EthanSK/magic-wand/control-stones/design/v2/exports/handheld-overview.png

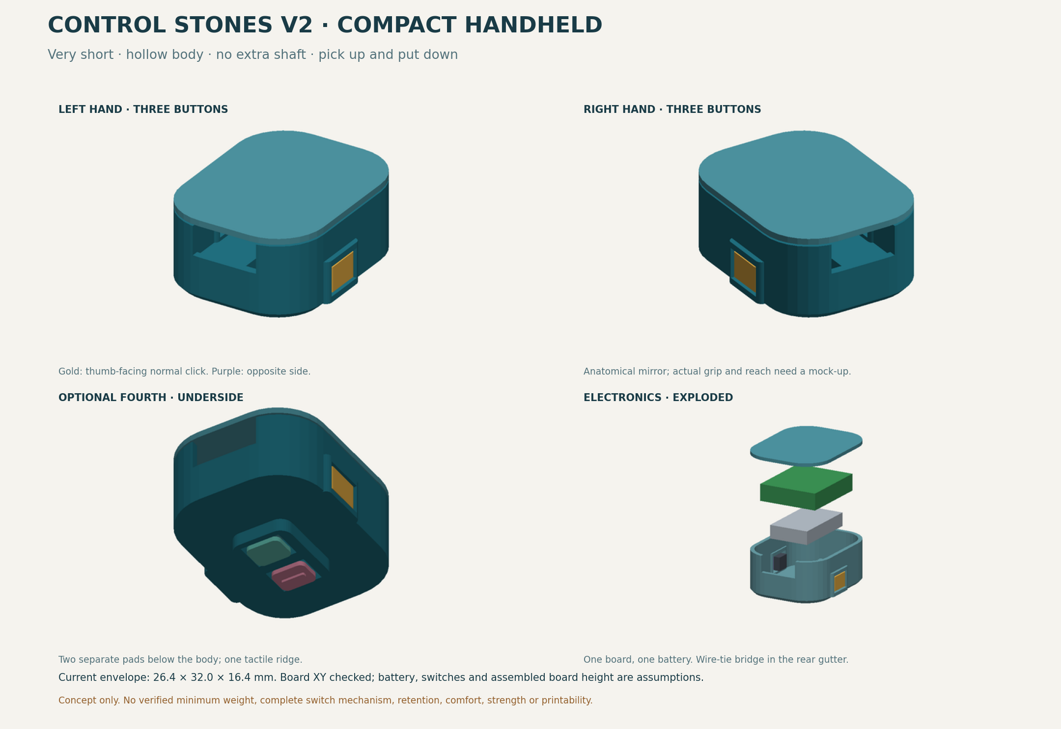
control-stones/design/v2/exports/handheld-overview.png
