EthanSK/magic-wand/control-stones/design/v2/exports/handheld-v-ring.png

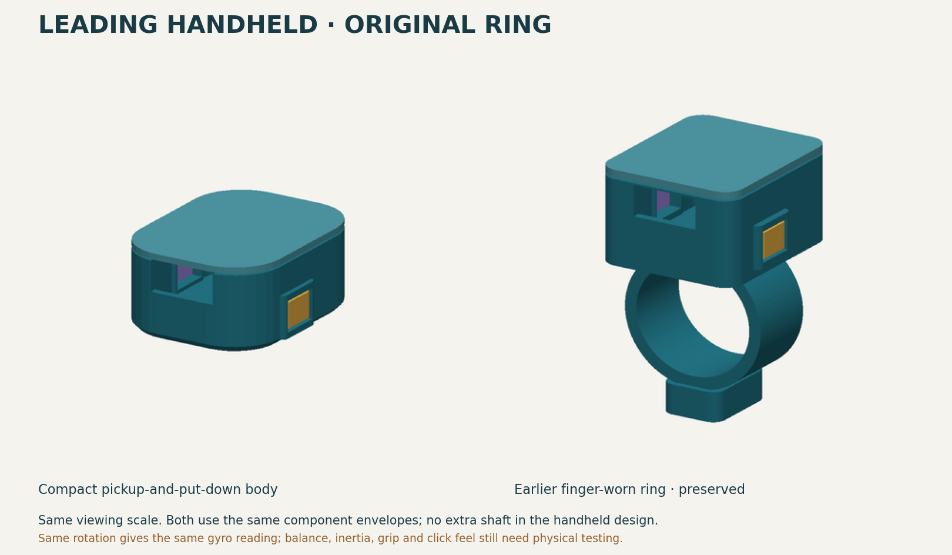
control-stones/design/v2/exports/handheld-v-ring.png
