EthanSK/magic-wand/control-stones/design/v2/exports/overview.png

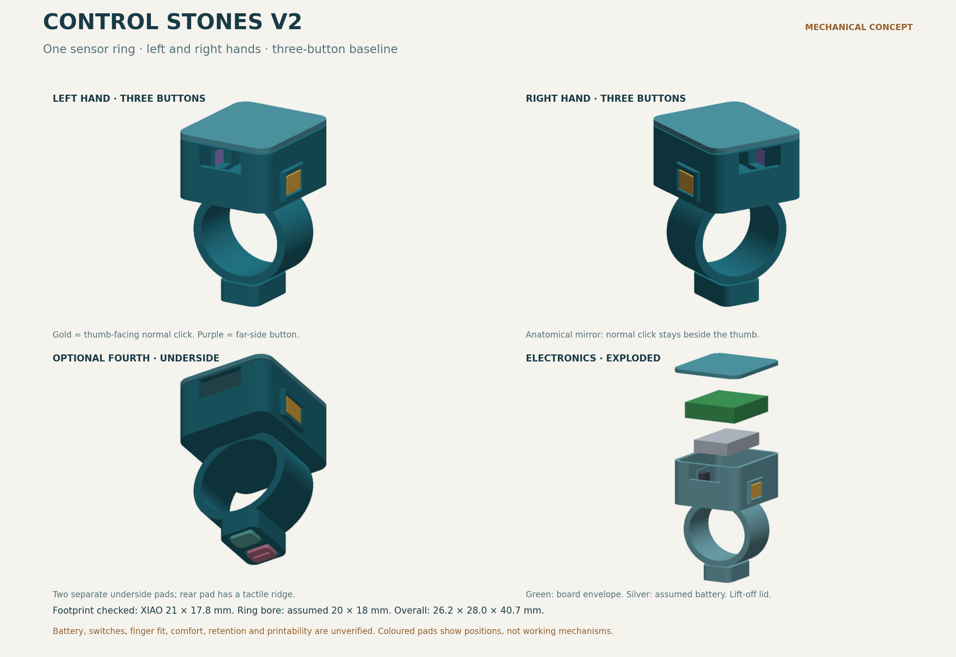
control-stones/design/v2/exports/overview.png
