EthanSK/magic-wand/control-stones/design/v2/exports/underside-comparison.png

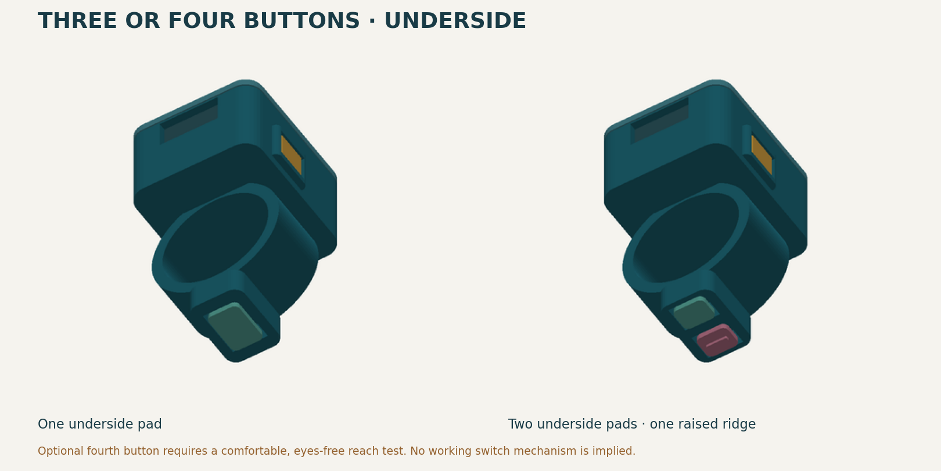
control-stones/design/v2/exports/underside-comparison.png
