EthanSK/magic-wand/magic-wand/hardware/carbon-rod-holders-r5/exports/Battery-options.png

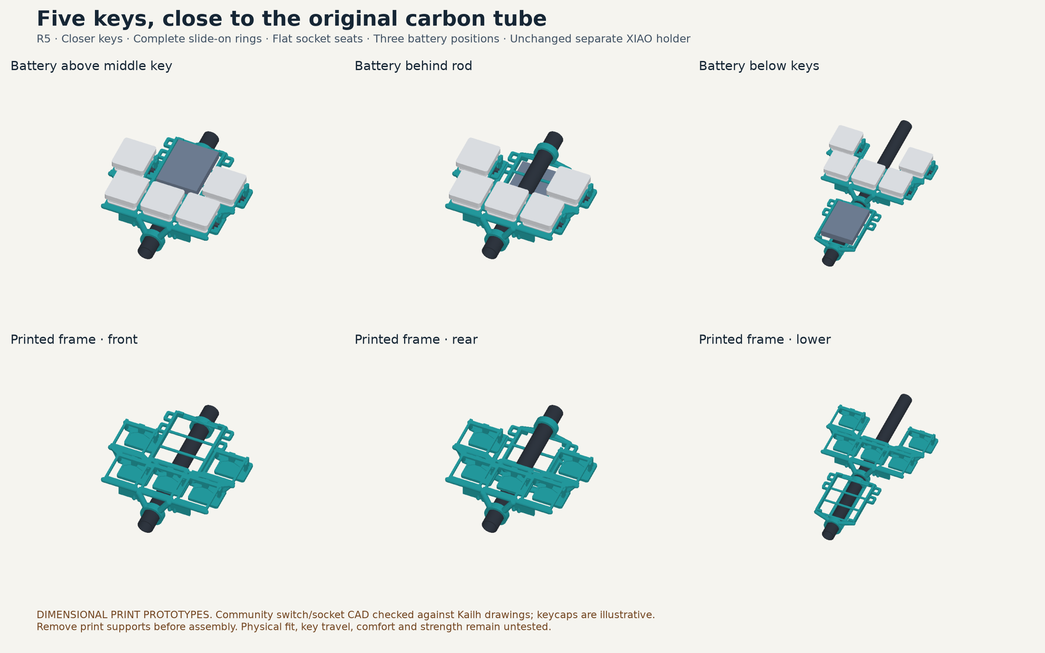
magic-wand/hardware/carbon-rod-holders-r5/exports/Battery-options.png
