EthanSK/magic-wand/magic-wand/hardware/carbon-rod-holders-r14-pyramid/exports/Key_Carrier-overhang-views.png

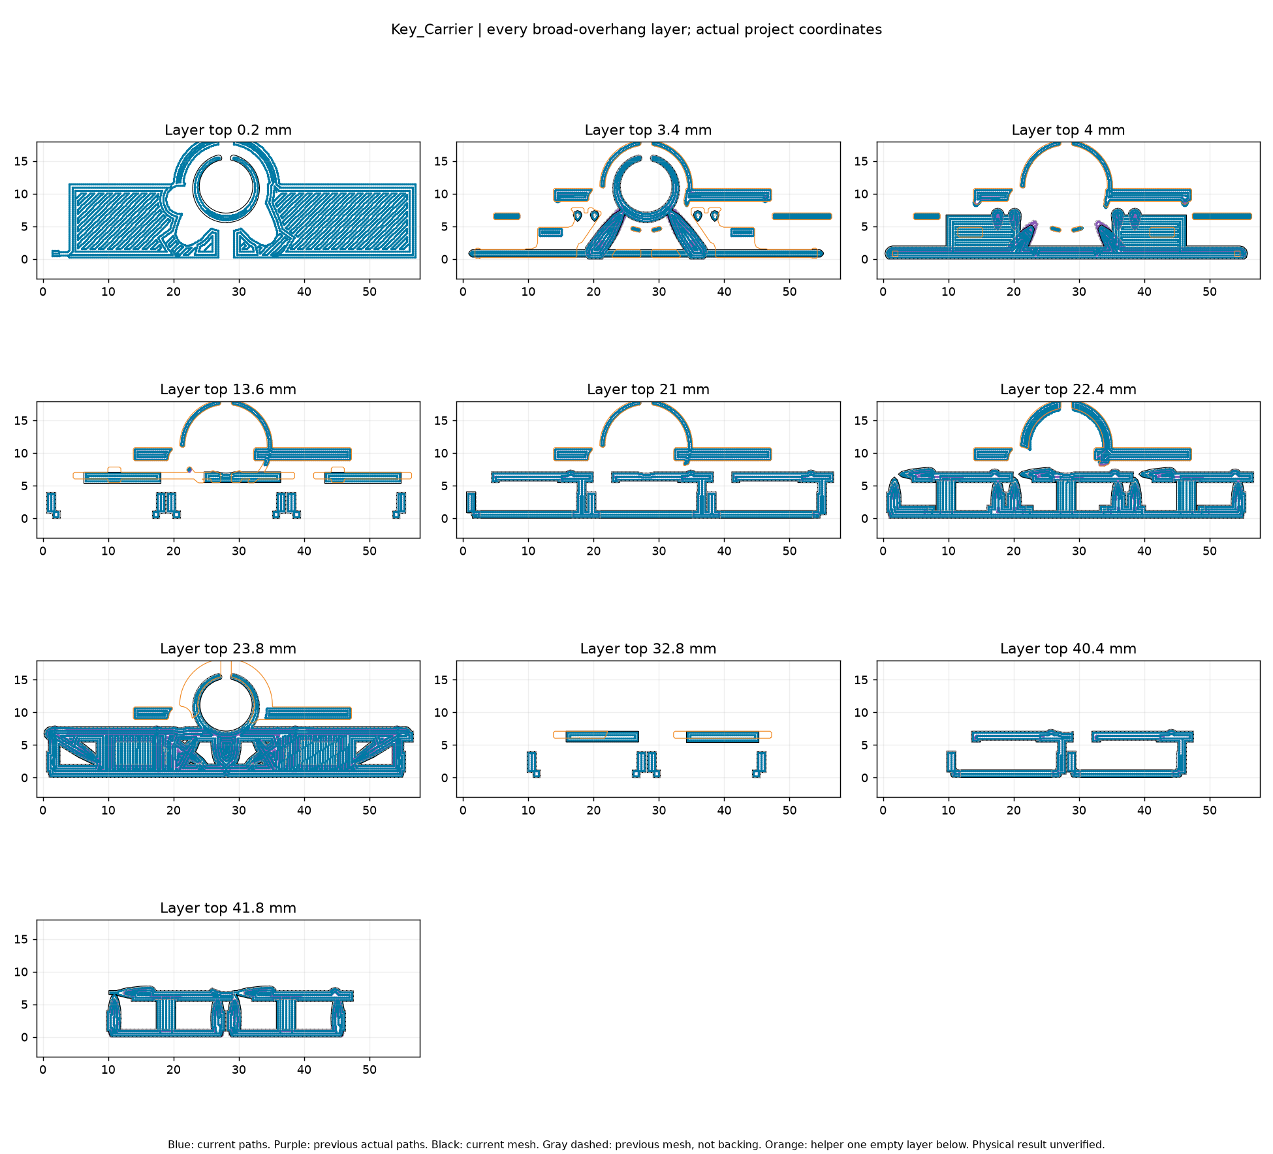
magic-wand/hardware/carbon-rod-holders-r14-pyramid/exports/Key_Carrier-overhang-views.png
