EthanSK/magic-wand/magic-wand/hardware/carbon-rod-holders-r14-pyramid/exports/Key_Carrier-overview.png

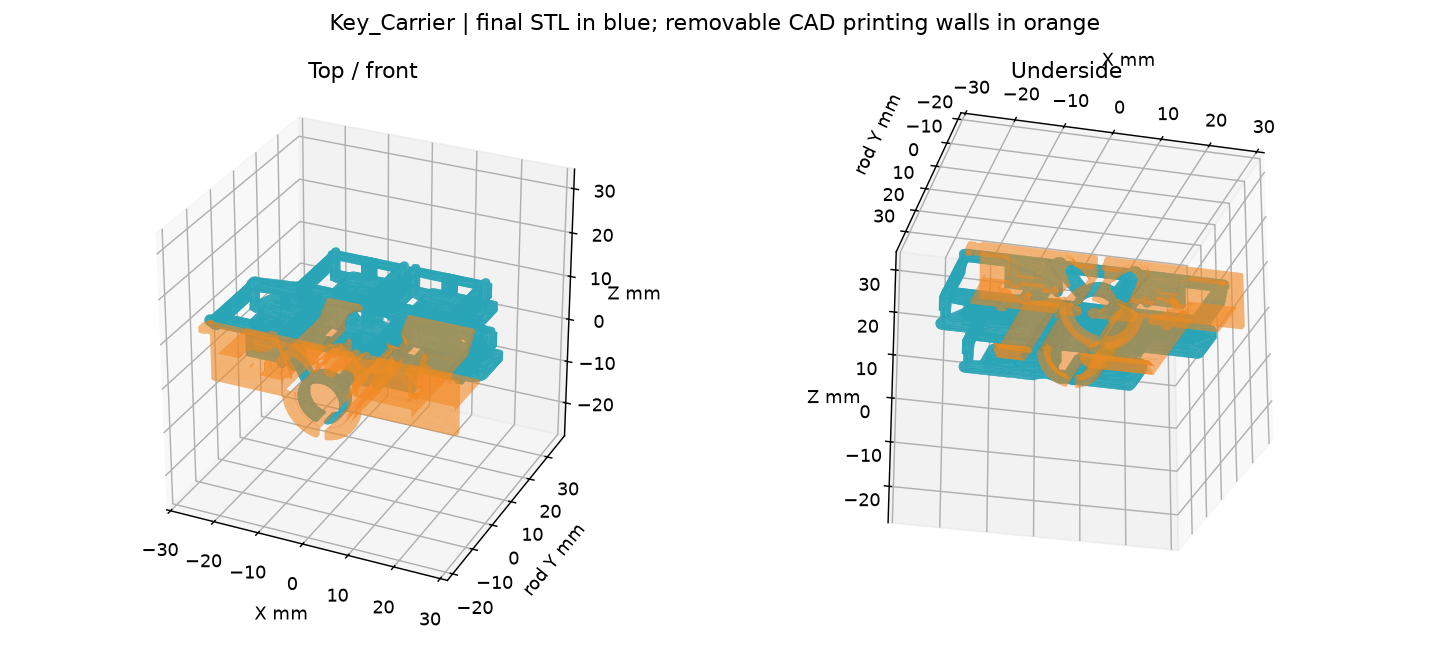
magic-wand/hardware/carbon-rod-holders-r14-pyramid/exports/Key_Carrier-overview.png
