EthanSK/magic-wand/magic-wand/hardware/carbon-rod-holders-r14-pyramid/exports/Key_Carrier-slice-views.png

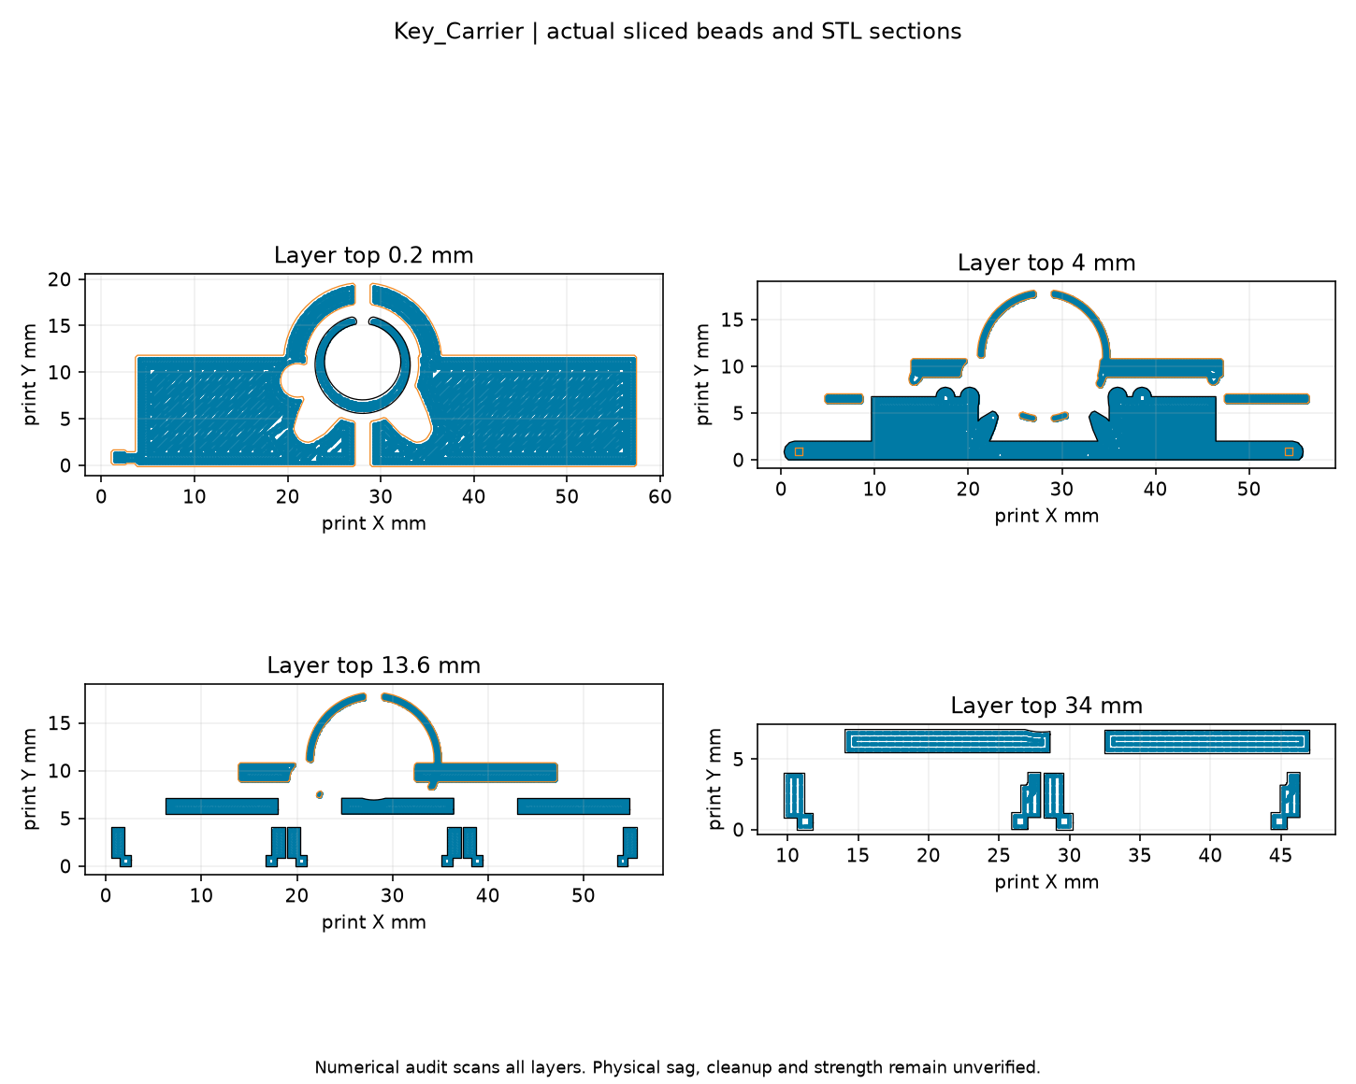
magic-wand/hardware/carbon-rod-holders-r14-pyramid/exports/Key_Carrier-slice-views.png
