EthanSK/magic-wand/magic-wand/hardware/carbon-rod-holders-r14-pyramid/exports/layout-comparison.png

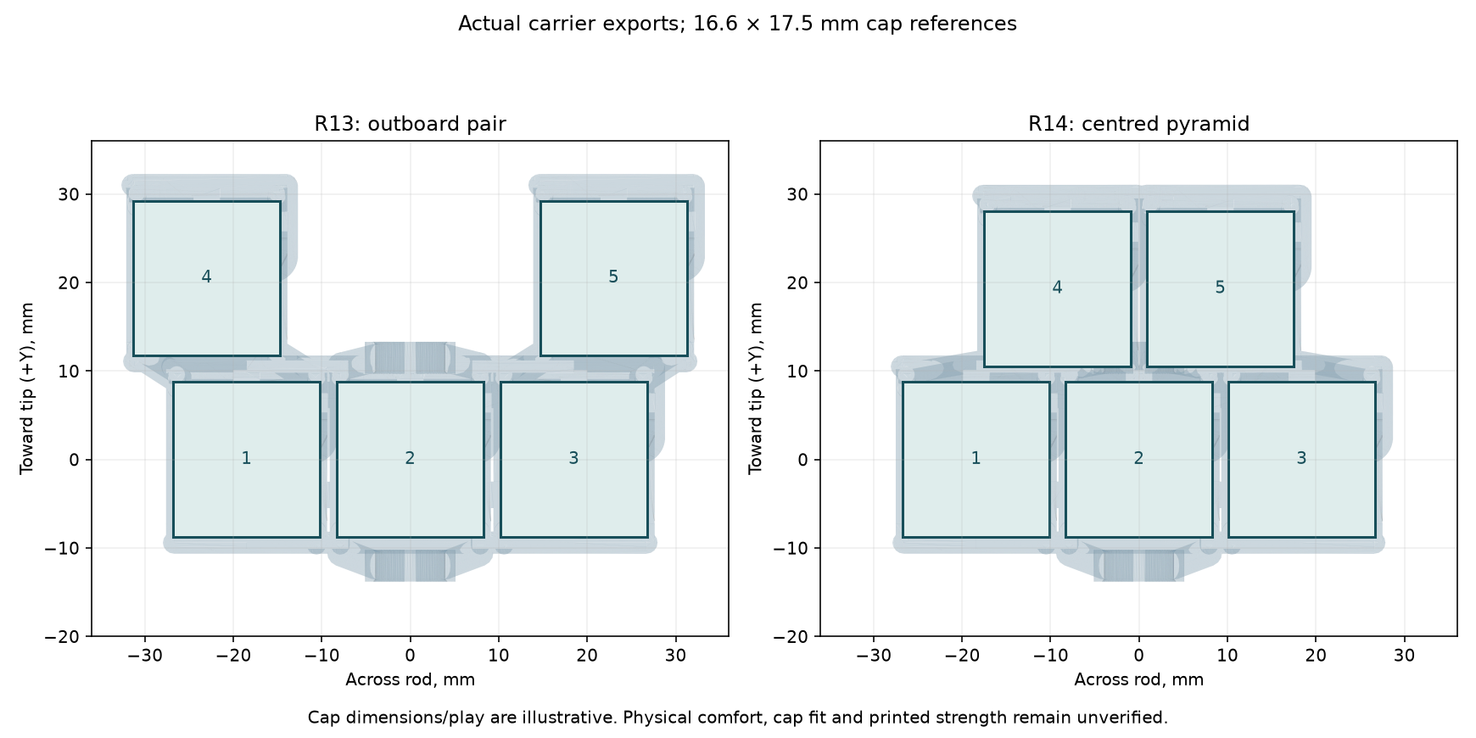
magic-wand/hardware/carbon-rod-holders-r14-pyramid/exports/layout-comparison.png
