EthanSK/magic-wand/magic-wand/hardware/carbon-rod-holders-r15-tight-pyramid/exports/Battery_End_Gate-overview.png

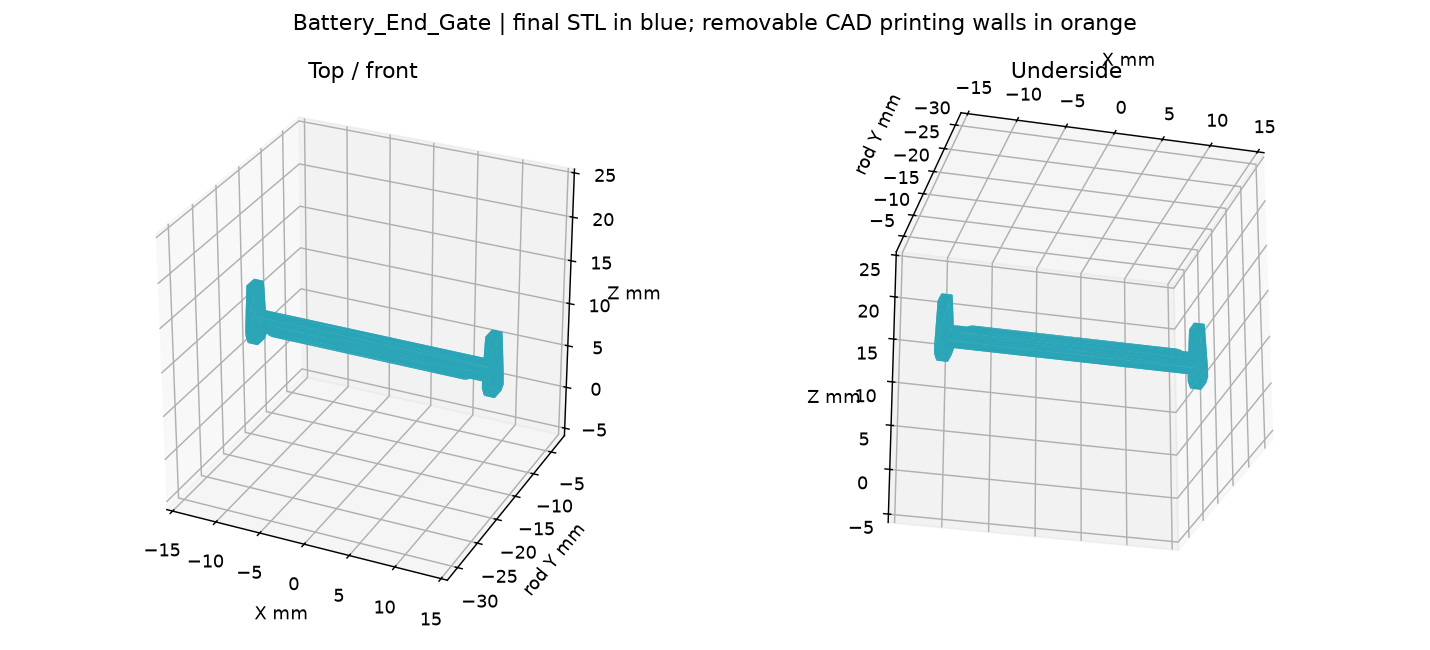
magic-wand/hardware/carbon-rod-holders-r15-tight-pyramid/exports/Battery_End_Gate-overview.png
