EthanSK/magic-wand/magic-wand/hardware/carbon-rod-holders-r15-tight-pyramid/exports/Battery_Holder-slice-views.png

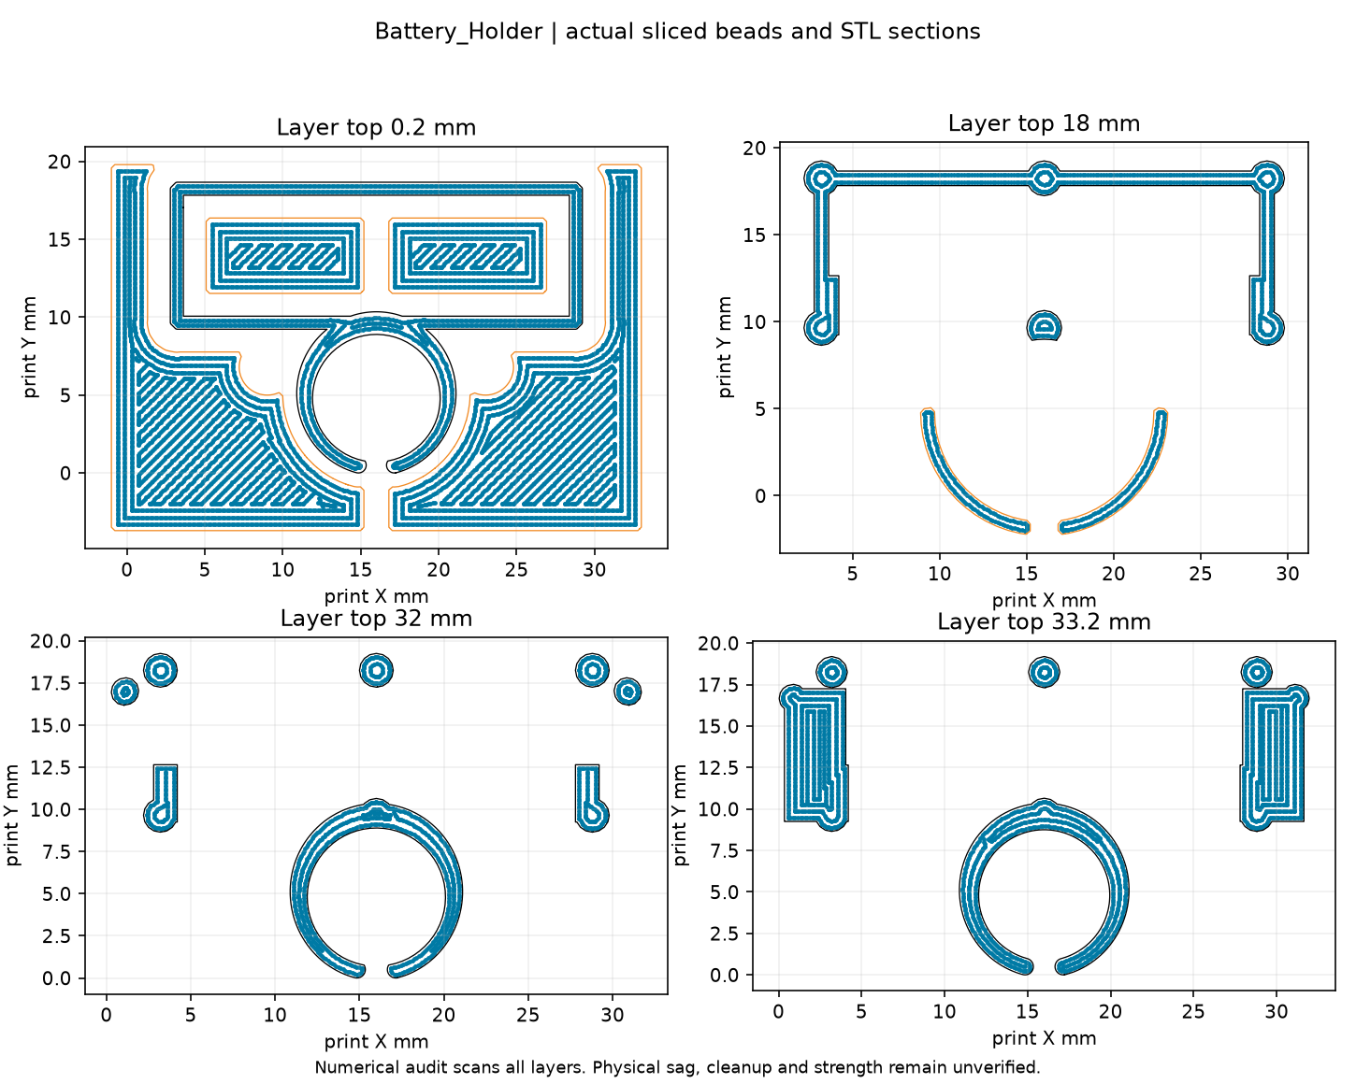
magic-wand/hardware/carbon-rod-holders-r15-tight-pyramid/exports/Battery_Holder-slice-views.png
