EthanSK/magic-wand/magic-wand/hardware/carbon-rod-holders-r15-tight-pyramid/exports/Key_Carrier-overhang-views.png

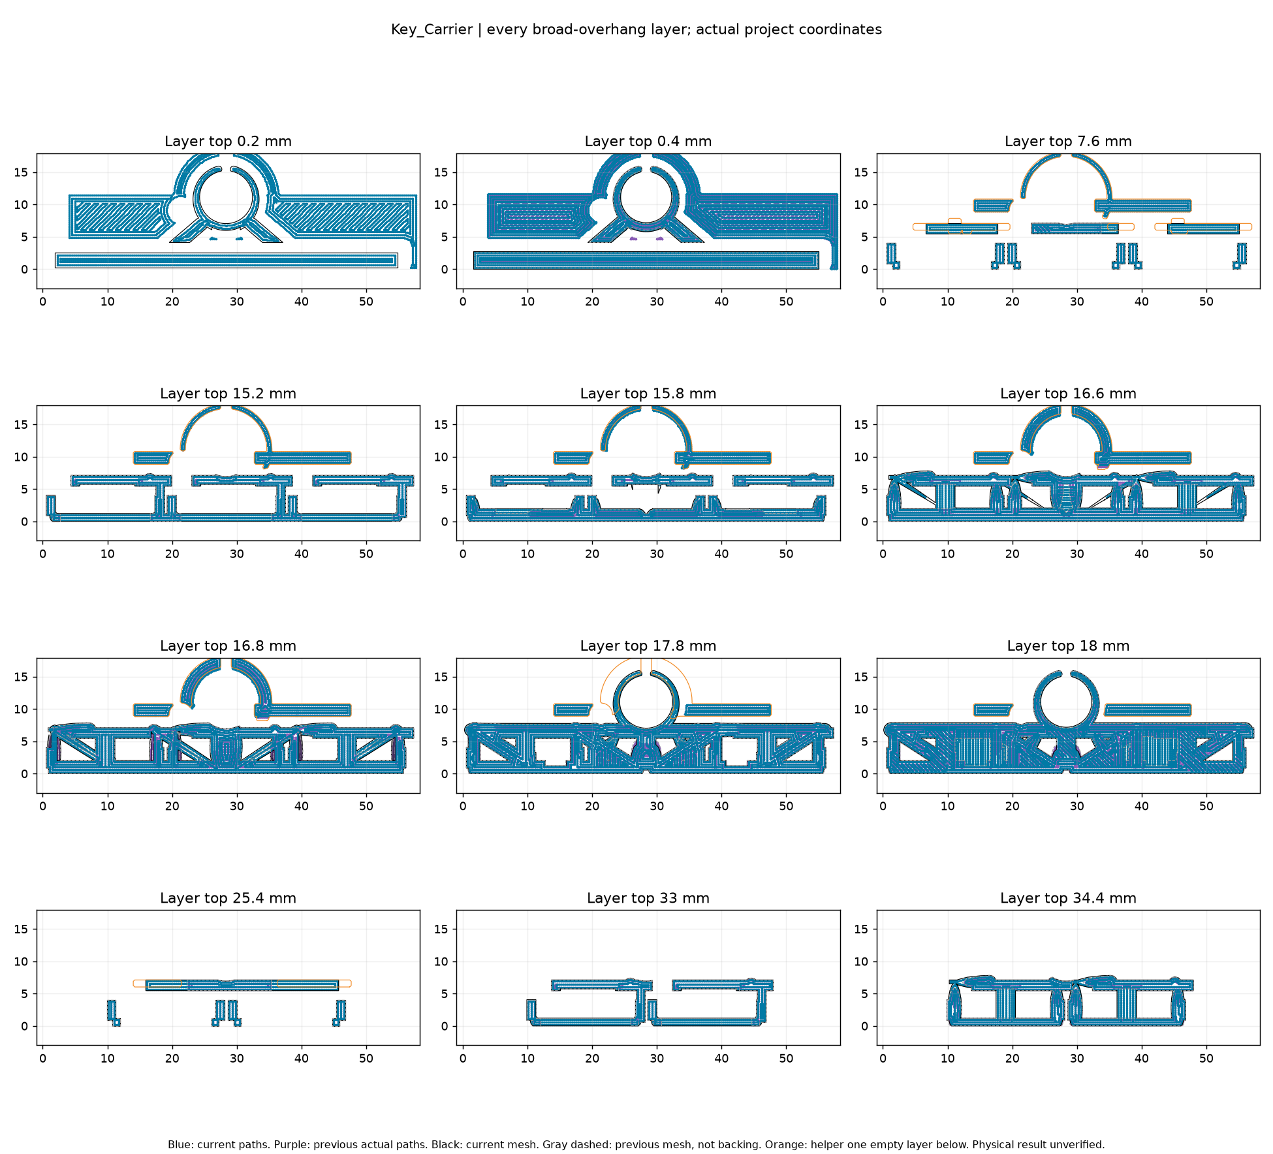
magic-wand/hardware/carbon-rod-holders-r15-tight-pyramid/exports/Key_Carrier-overhang-views.png
