EthanSK/magic-wand/magic-wand/hardware/carbon-rod-holders-r15-tight-pyramid/exports/layout-comparison.png

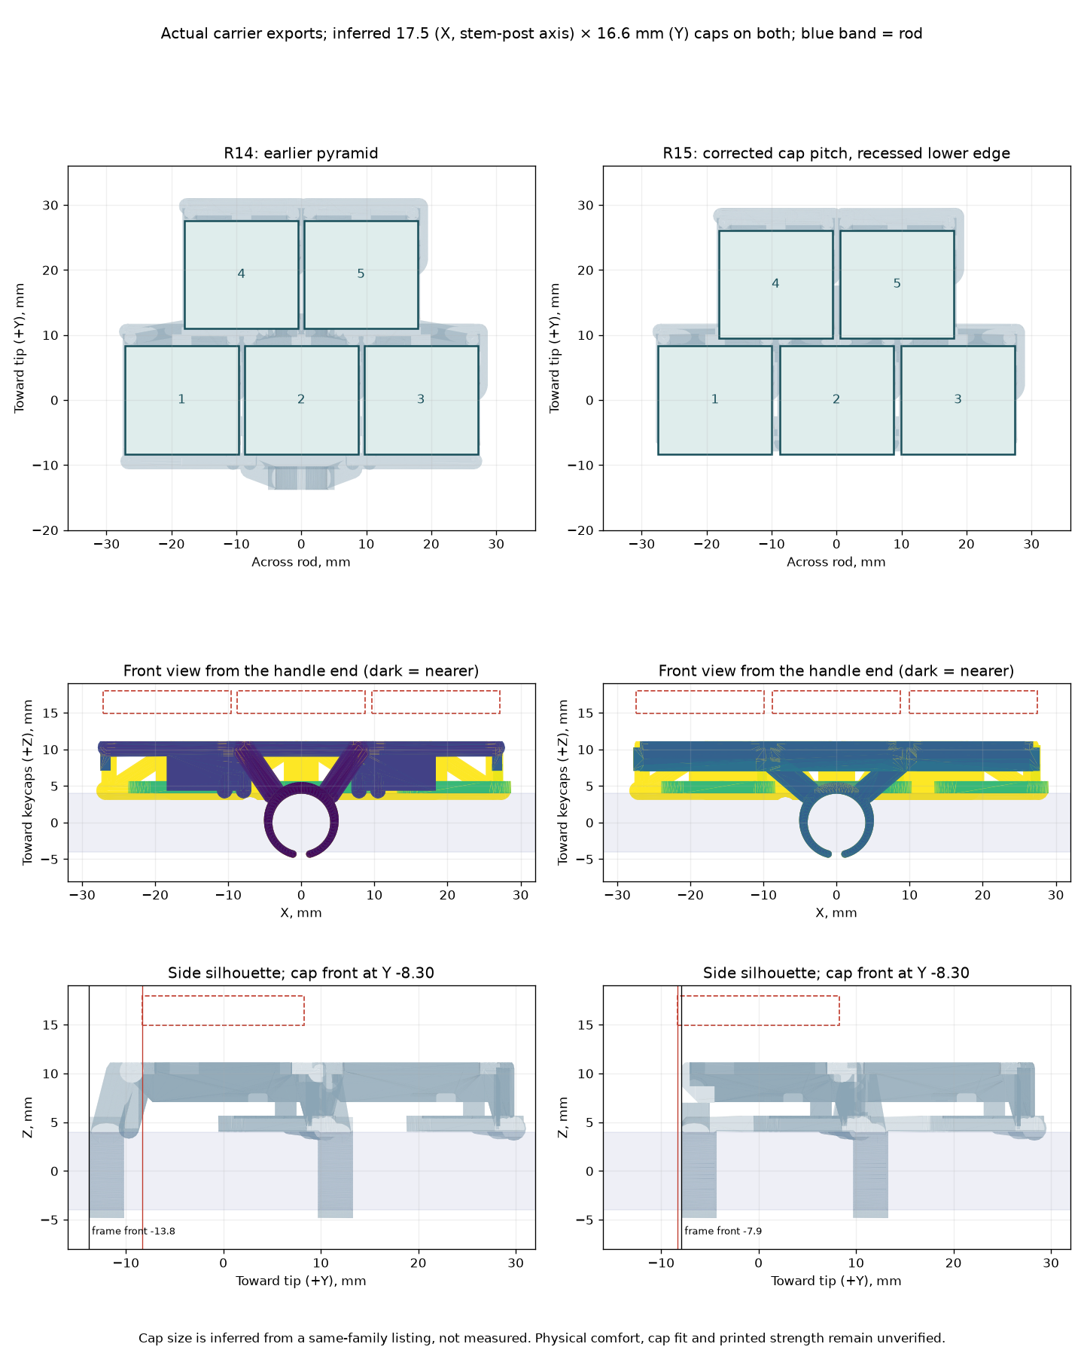
magic-wand/hardware/carbon-rod-holders-r15-tight-pyramid/exports/layout-comparison.png
