EthanSK/magic-wand/magic-wand/hardware/carbon-rod-holders-r15-tight-pyramid/exports/XIAO_Rod_Holder-slice-views.png

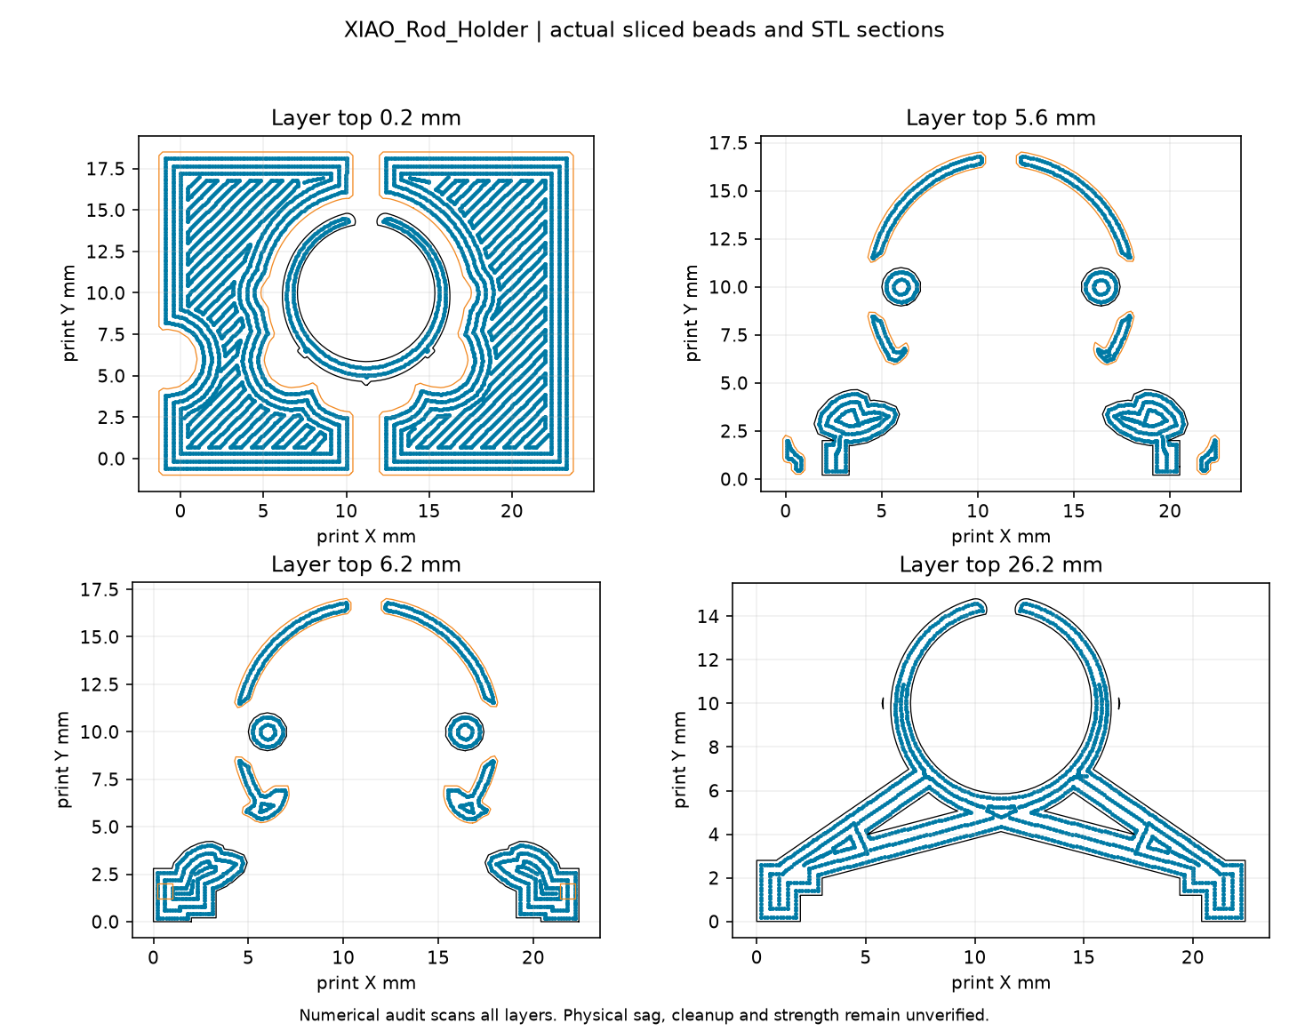
magic-wand/hardware/carbon-rod-holders-r15-tight-pyramid/exports/XIAO_Rod_Holder-slice-views.png
