EthanSK/magic-wand/magic-wand/hardware/carbon-rod-holders-r16-repair/exports/Battery_End_Gate-overview.png

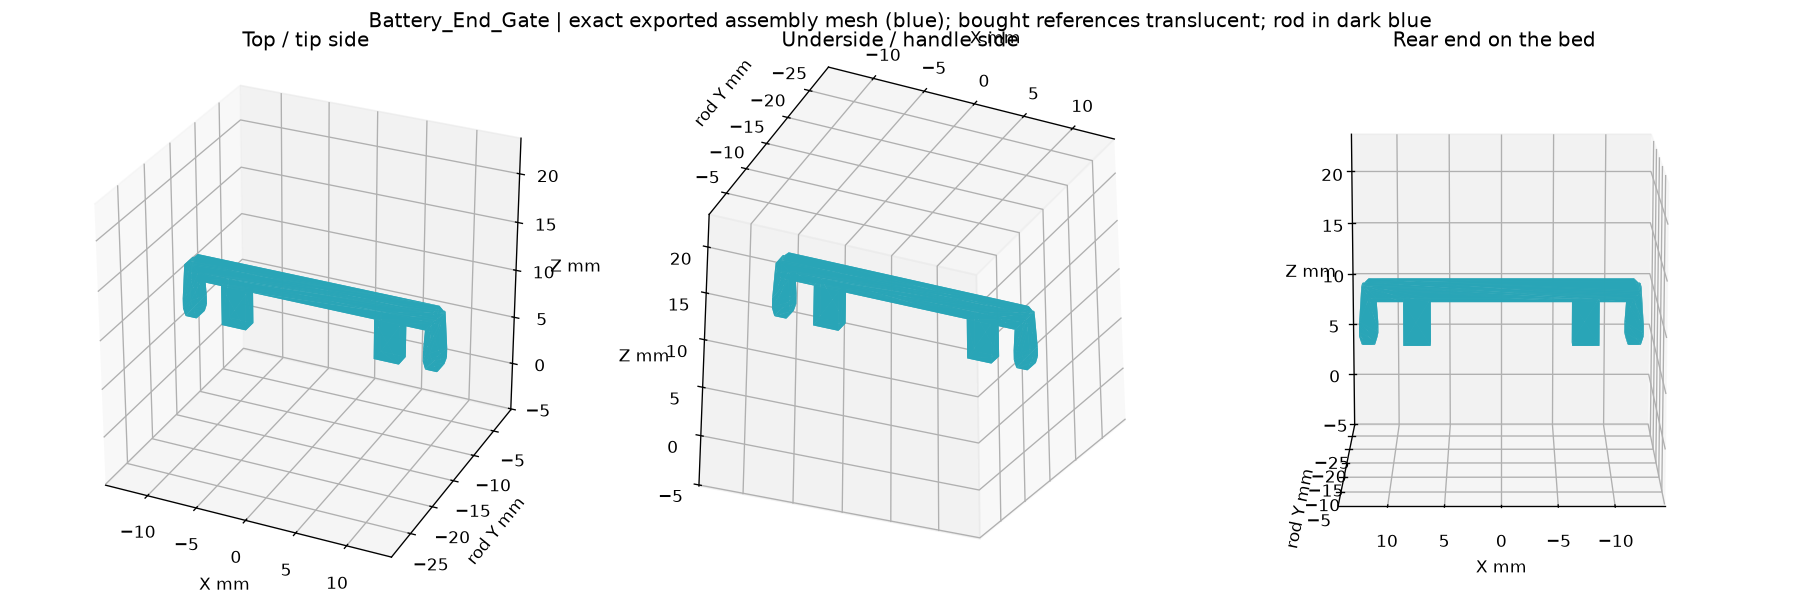
magic-wand/hardware/carbon-rod-holders-r16-repair/exports/Battery_End_Gate-overview.png
