EthanSK/magic-wand/magic-wand/hardware/carbon-rod-holders-r16-repair/exports/Battery_Holder-overview.png

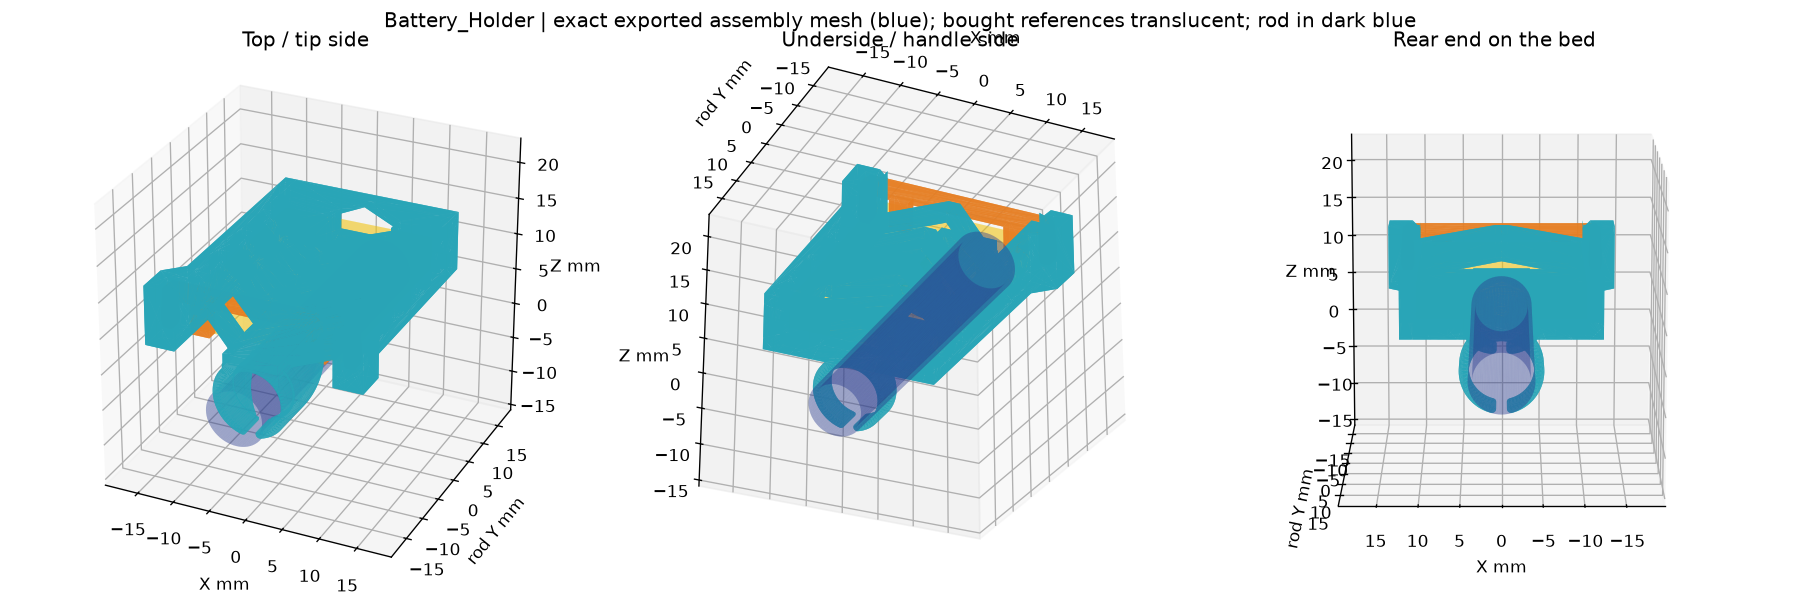
magic-wand/hardware/carbon-rod-holders-r16-repair/exports/Battery_Holder-overview.png
