EthanSK/magic-wand/magic-wand/hardware/carbon-rod-holders-r17-anchored-repair/exports/Battery_End_Gate-overview.png

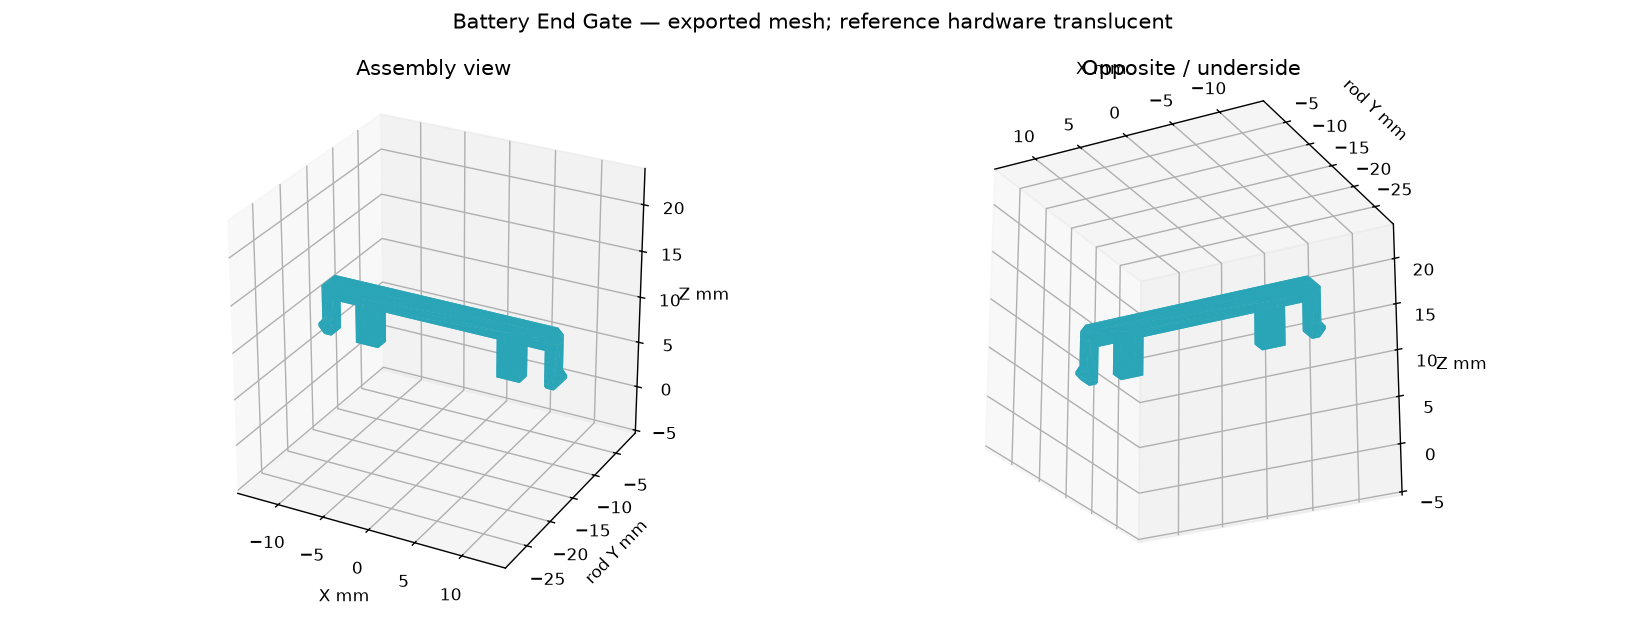
magic-wand/hardware/carbon-rod-holders-r17-anchored-repair/exports/Battery_End_Gate-overview.png
