EthanSK/magic-wand/magic-wand/hardware/carbon-rod-holders-r18-easy-release/exports/Battery_Holder-gui-final-layer-views.png

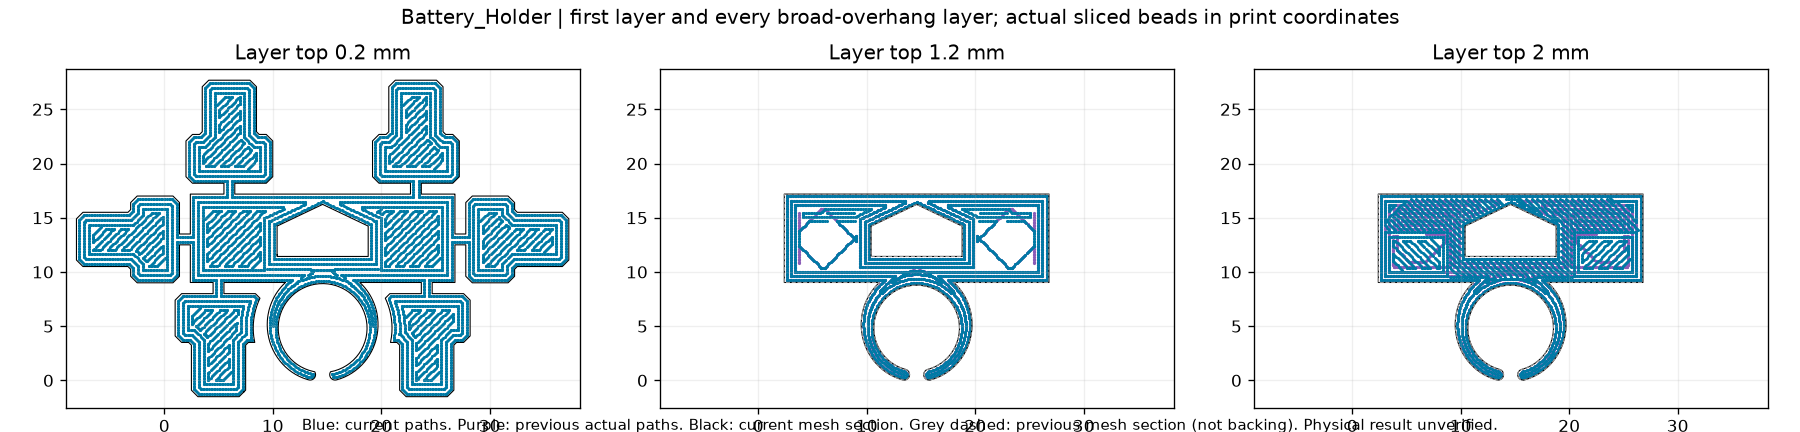
magic-wand/hardware/carbon-rod-holders-r18-easy-release/exports/Battery_Holder-gui-final-layer-views.png
