EthanSK/magic-wand/magic-wand/hardware/carbon-rod-holders-r18-easy-release/exports/XIAO_Rod_Holder-gui-final-layer-views.png

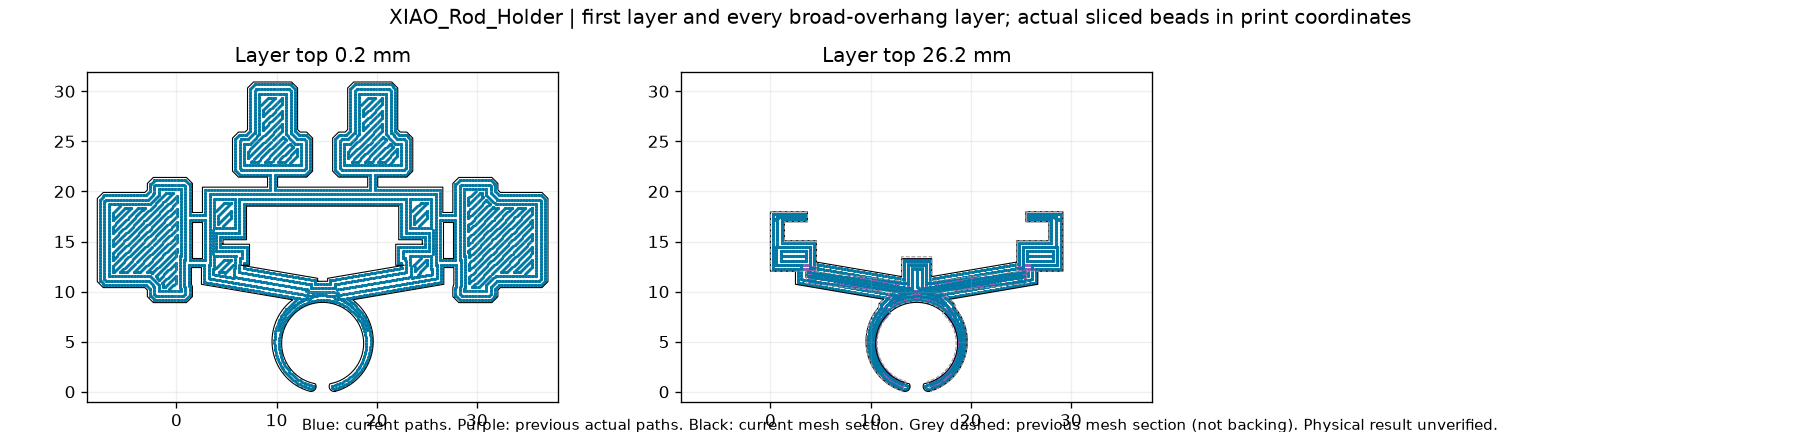
magic-wand/hardware/carbon-rod-holders-r18-easy-release/exports/XIAO_Rod_Holder-gui-final-layer-views.png
