EthanSK/magic-wand/magic-wand/hardware/carbon-rod-holders-r19-lightweight/exports/Battery_Holder-layer-views.png

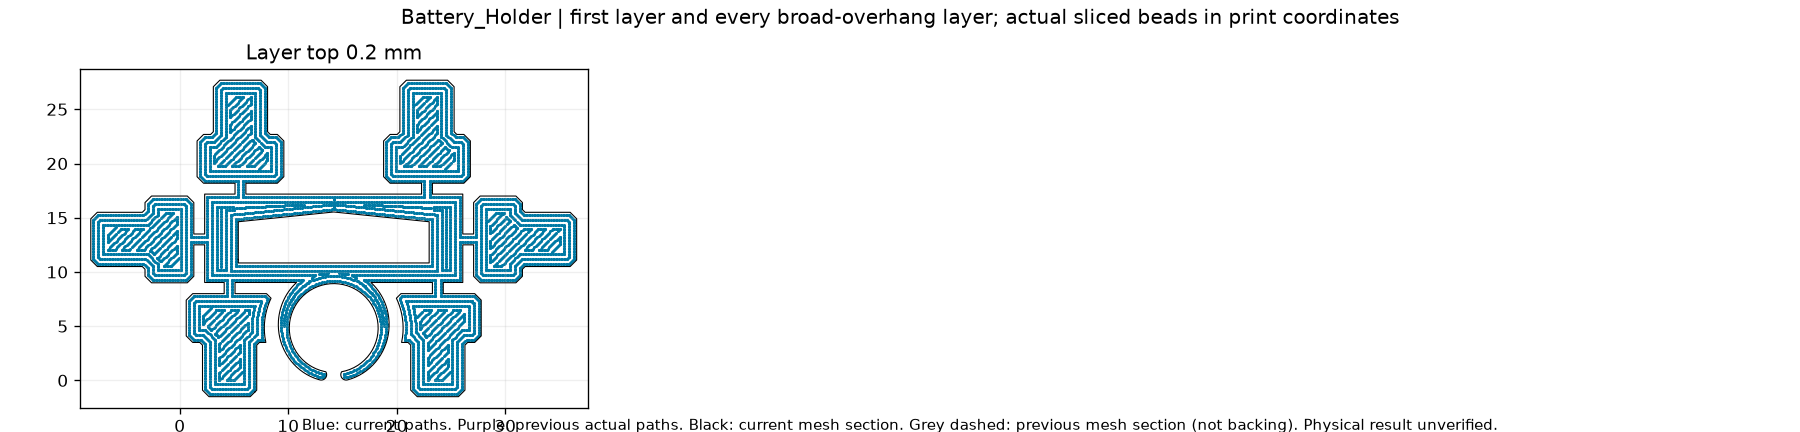
magic-wand/hardware/carbon-rod-holders-r19-lightweight/exports/Battery_Holder-layer-views.png
