EthanSK/magic-wand/magic-wand/hardware/carbon-rod-holders-r19-lightweight/exports/Battery_Spacer_0p4mm-layer-views.png

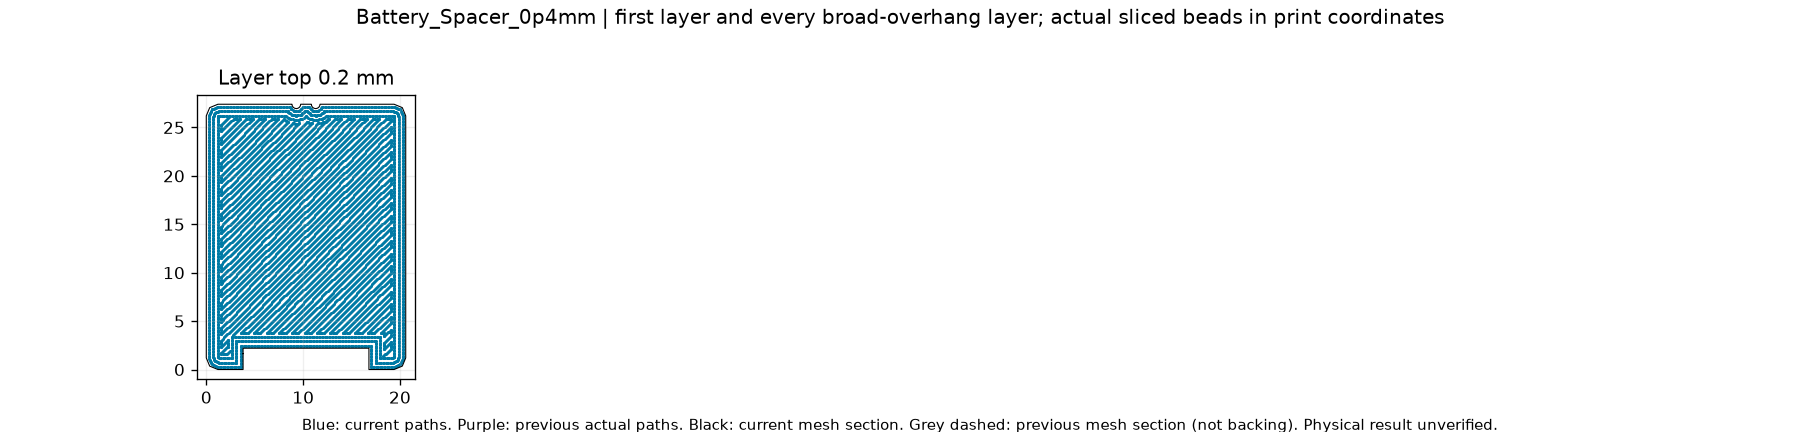
magic-wand/hardware/carbon-rod-holders-r19-lightweight/exports/Battery_Spacer_0p4mm-layer-views.png
