EthanSK/magic-wand/magic-wand/hardware/carbon-rod-holders-r19-lightweight/exports/open-floor-plan.png

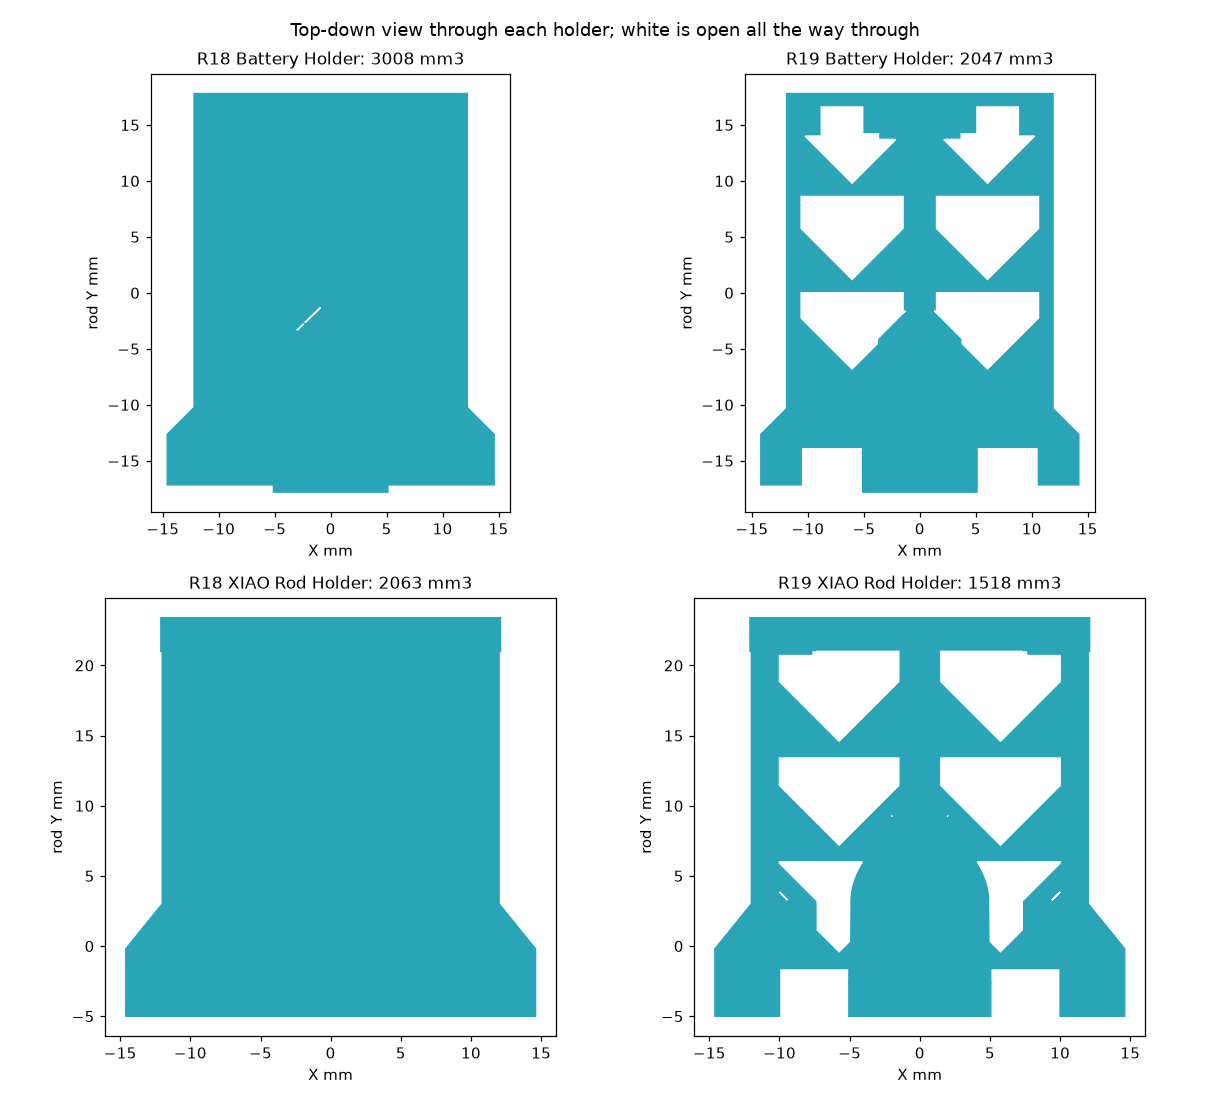
magic-wand/hardware/carbon-rod-holders-r19-lightweight/exports/open-floor-plan.png
