EthanSK/magic-wand/magic-wand/hardware/carbon-rod-holders-r19-lightweight/exports/XIAO_Near_Keeper-layer-views.png

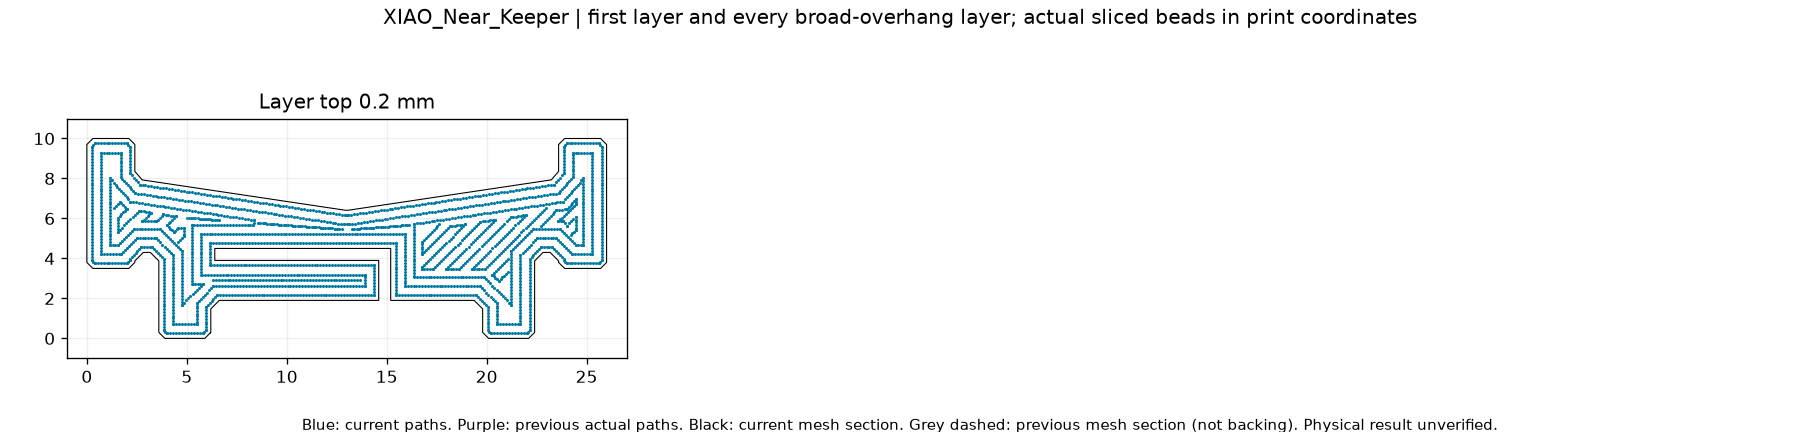
magic-wand/hardware/carbon-rod-holders-r19-lightweight/exports/XIAO_Near_Keeper-layer-views.png
