EthanSK/magic-wand/magic-wand/hardware/carbon-rod-holders-r20-finger-guard/exports/Finger_Guard-layer-views.png

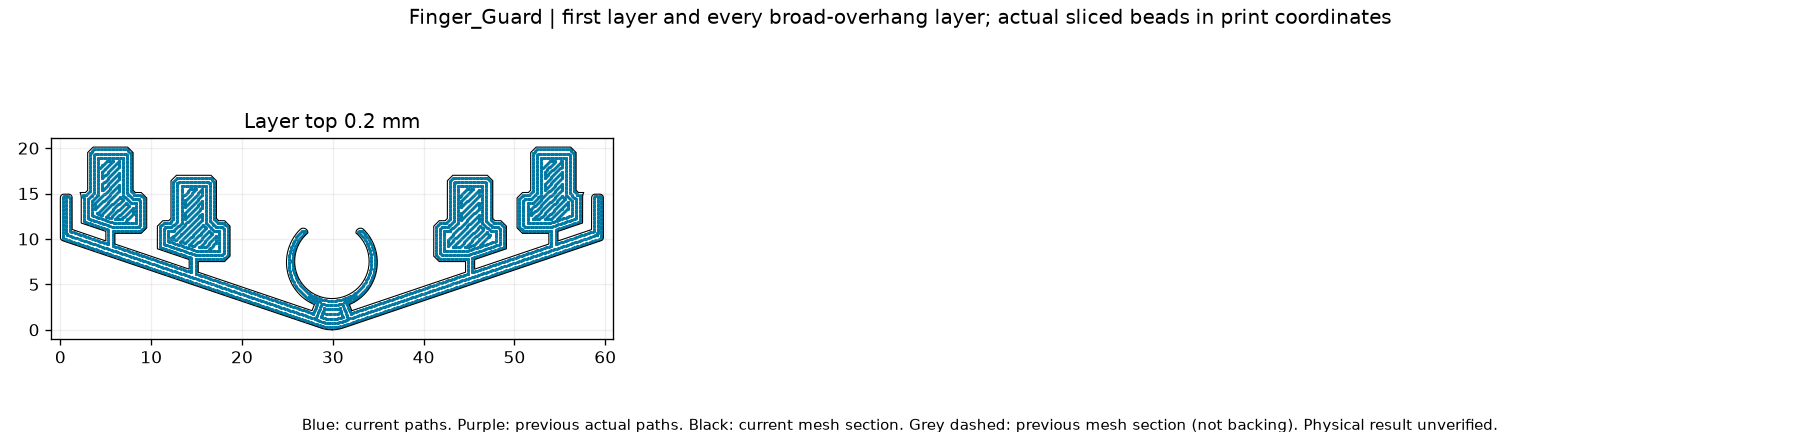
magic-wand/hardware/carbon-rod-holders-r20-finger-guard/exports/Finger_Guard-layer-views.png
