EthanSK/magic-wand/magic-wand/hardware/carbon-rod-holders-r20-finger-guard/exports/Key_Carrier-layer-views.png

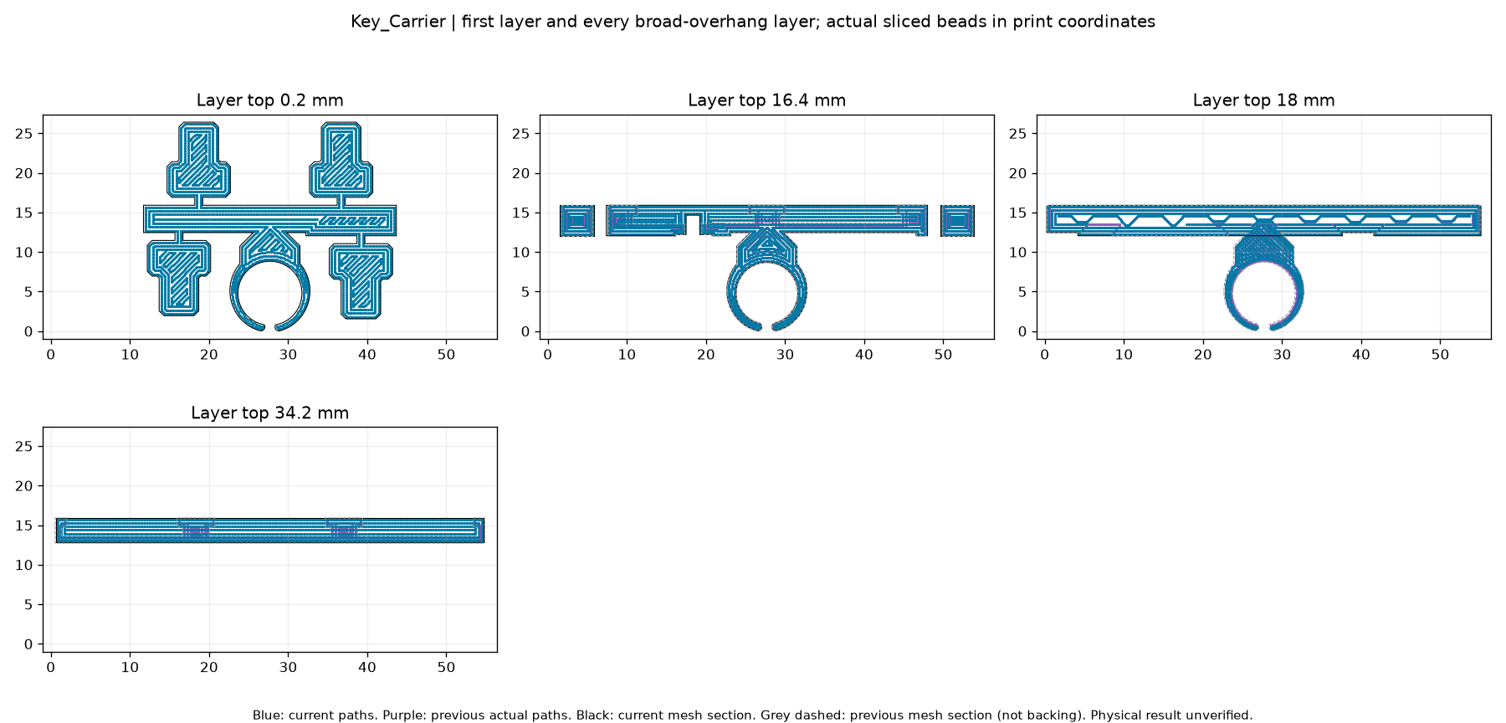
magic-wand/hardware/carbon-rod-holders-r20-finger-guard/exports/Key_Carrier-layer-views.png
