EthanSK/magic-wand/magic-wand/hardware/carbon-rod-holders-r36-grove-touch/exports/plate-preview.png

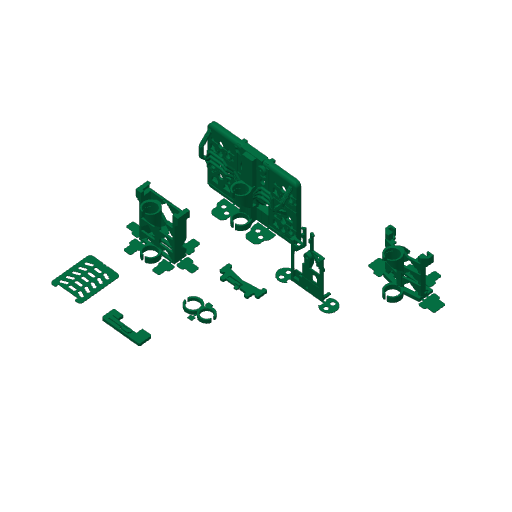
magic-wand/hardware/carbon-rod-holders-r36-grove-touch/exports/plate-preview.png
