EthanSK/magic-wand/magic-wand/hardware/carbon-rod-holders-r37-adjustable-op1/exports/gentle-start/plate-preview.png

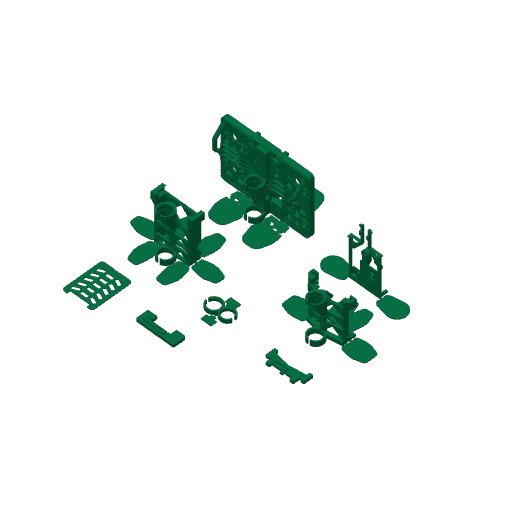
magic-wand/hardware/carbon-rod-holders-r37-adjustable-op1/exports/gentle-start/plate-preview.png
