EthanSK/magic-wand/magic-wand/hardware/carbon-rod-holders-r14-pyramid/exports/Key_Carrier-PRINT-HELPER-assembly.stl

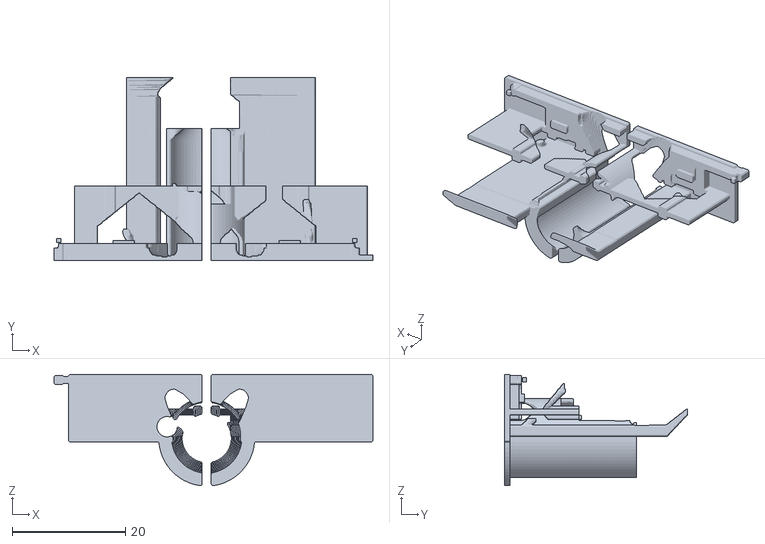
[picture p48: CAD file, 2026-11-06]
magic-wand/hardware/carbon-rod-holders-r14-pyramid/exports/Key_Carrier-PRINT-HELPER-assembly.stl
56.4 x 32.4 x 19.7
