EthanSK/magic-wand/magic-wand/hardware/carbon-rod-holders-r15-tight-pyramid/exports/trial-Key_Carrier/Key_Carrier-assembly.stl

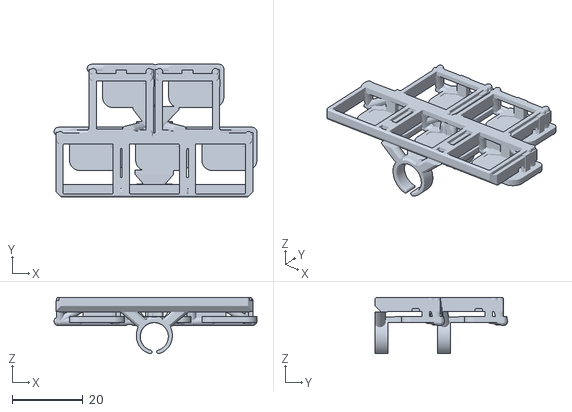
[picture p49: CAD file, 2026-11-06]
magic-wand/hardware/carbon-rod-holders-r15-tight-pyramid/exports/trial-Key_Carrier/Key_Carrier-assembly.stl
57.4 x 37.4 x 15.9
