EthanSK/magic-wand/magic-wand/hardware/carbon-rod-holders-r16-repair/exports/Key_Carrier-assembly.stl

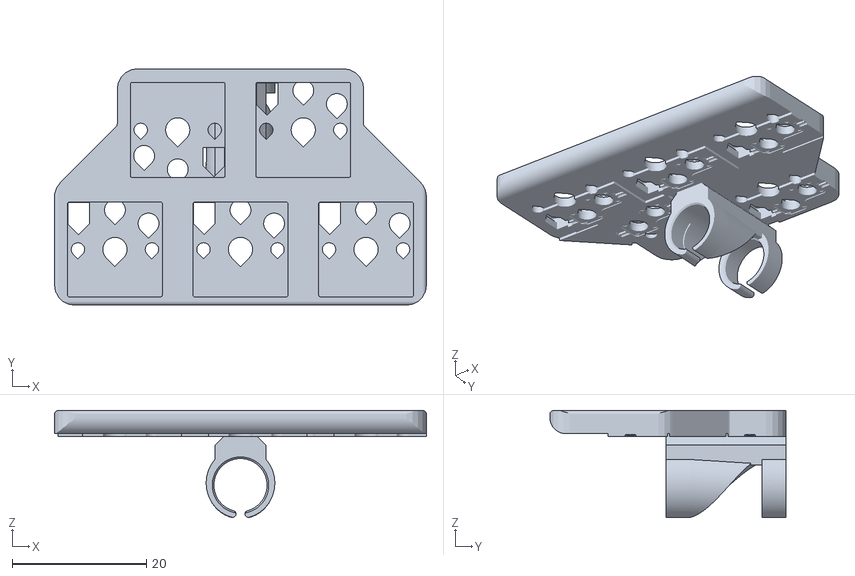
[picture p50: CAD file, 2026-11-08]
magic-wand/hardware/carbon-rod-holders-r16-repair/exports/Key_Carrier-assembly.stl
55.4 x 35.2 x 15.9
