EthanSK/magic-wand/magic-wand/hardware/carbon-rod-holders-r20-finger-guard/exports/Finger_Guard-assembly.stl

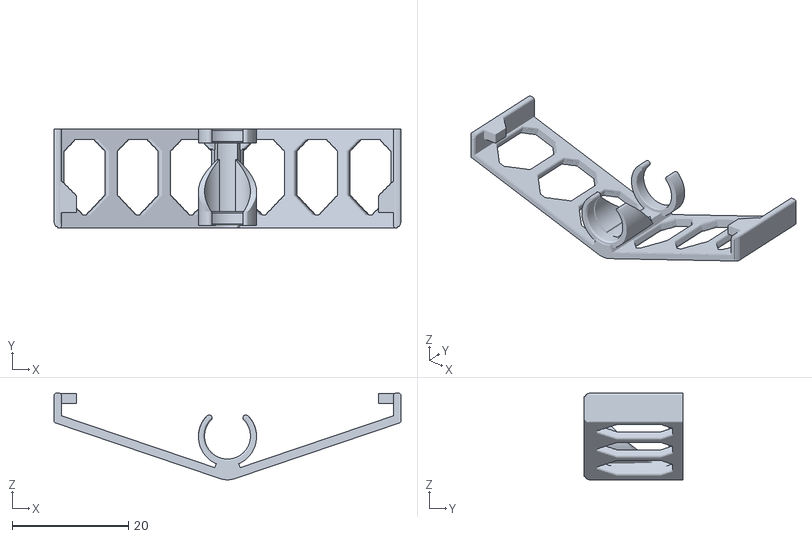
[picture p51: CAD file, 2026-11-10]
magic-wand/hardware/carbon-rod-holders-r20-finger-guard/exports/Finger_Guard-assembly.stl
59.8 x 17.0 x 14.9
