EthanSK/magic-wand/magic-wand/hardware/carbon-rod-holders-r22-integrated-guard/exports/Cable_Clip_12_Wire-assembly.stl

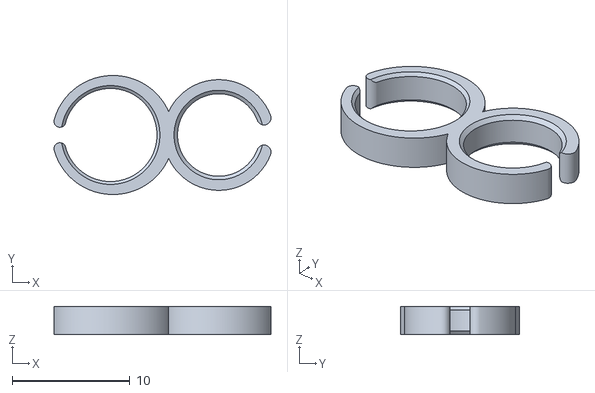
[picture p52: CAD file, 2026-11-10]
magic-wand/hardware/carbon-rod-holders-r22-integrated-guard/exports/Cable_Clip_12_Wire-assembly.stl
18.4 x 10.1 x 2.40
