EthanSK/magic-wand/magic-wand/hardware/carbon-rod-holders-r25-keeper-release/exports/XIAO_Rod_Holder-assembly.stl

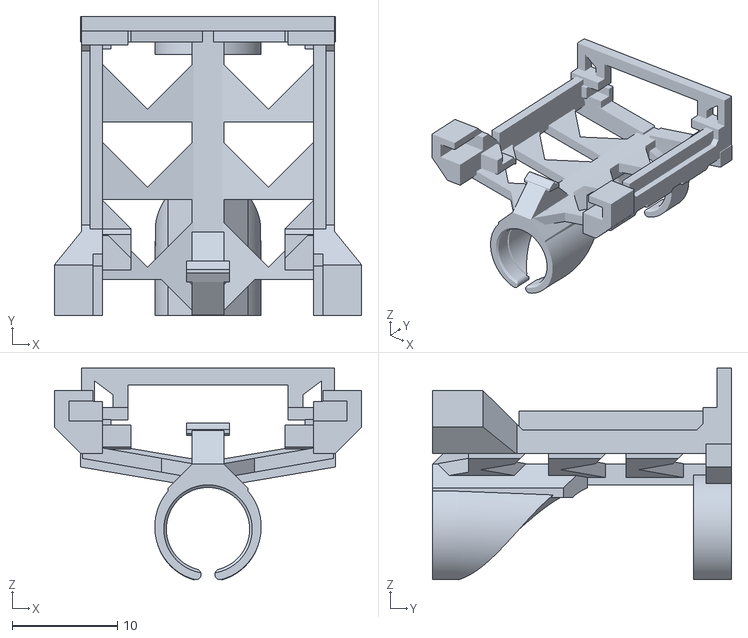
[picture p53: CAD file, 2026-11-10]
magic-wand/hardware/carbon-rod-holders-r25-keeper-release/exports/XIAO_Rod_Holder-assembly.stl
29.2 x 28.4 x 20.1
