EthanSK/magic-wand/magic-wand/hardware/carbon-rod-holders-r32-complete-assembly/exports/R32-Complete-A1-mini-PETG-layout.3mf

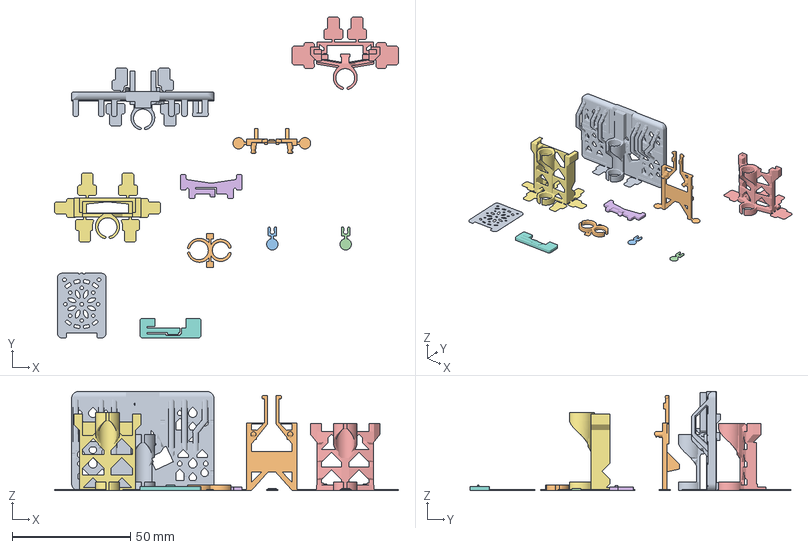
[picture p54: CAD file, 2026-11-11]
magic-wand/hardware/carbon-rod-holders-r32-complete-assembly/exports/R32-Complete-A1-mini-PETG-layout.3mf
145.3 x 135.6 x 41.9 mm
Key_Carrier
DFRobot_Hole_Bracket
DFR0030_Post_Clip
DFR0030_Post_Clip_2
XIAO_Rod_Holder
XIAO_Near_Keeper
Battery_Holder
Battery_End_Door
Battery_Spacer_0p4mm_Patterned
Cable_Clip_12_Wire
