EthanSK/magic-wand/magic-wand/hardware/carbon-rod-holders-r33-crosswise-guards/exports/Key_Carrier-assembly.stl

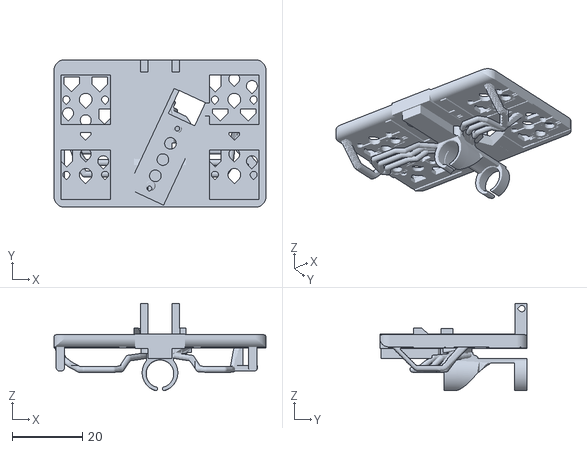
[picture p55: CAD file, 2026-11-11]
magic-wand/hardware/carbon-rod-holders-r33-crosswise-guards/exports/Key_Carrier-assembly.stl
60.2 x 41.9 x 24.8
