EthanSK/magic-wand/magic-wand/hardware/carbon-rod-holders-r38-centred-op1/exports/standard-retry/R38-Complete-A1-mini-PETG-layout.3mf

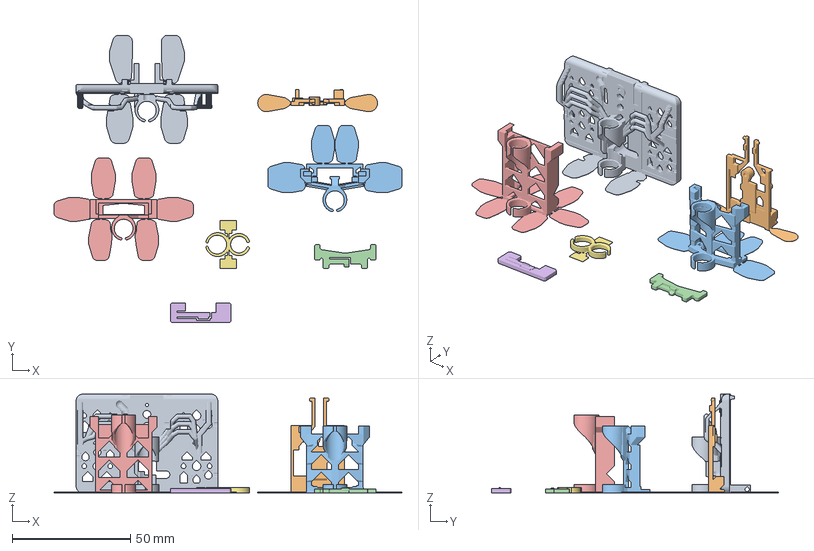
[picture p56: CAD file, 2026-11-14]
magic-wand/hardware/carbon-rod-holders-r38-centred-op1/exports/standard-retry/R38-Complete-A1-mini-PETG-layout.3mf
147.3 x 121.6 x 41.9 mm
Key_Carrier
Grove_Touch_Bracket
XIAO_Rod_Holder
XIAO_Near_Keeper
Battery_Holder
Battery_End_Door
Cable_Clip_12_Wire
