EthanSK/magic-wand/magic-wand/hardware/carbon-rod-holders-r6-three-key/exports/Key_Battery_Carrier-assembly.stl

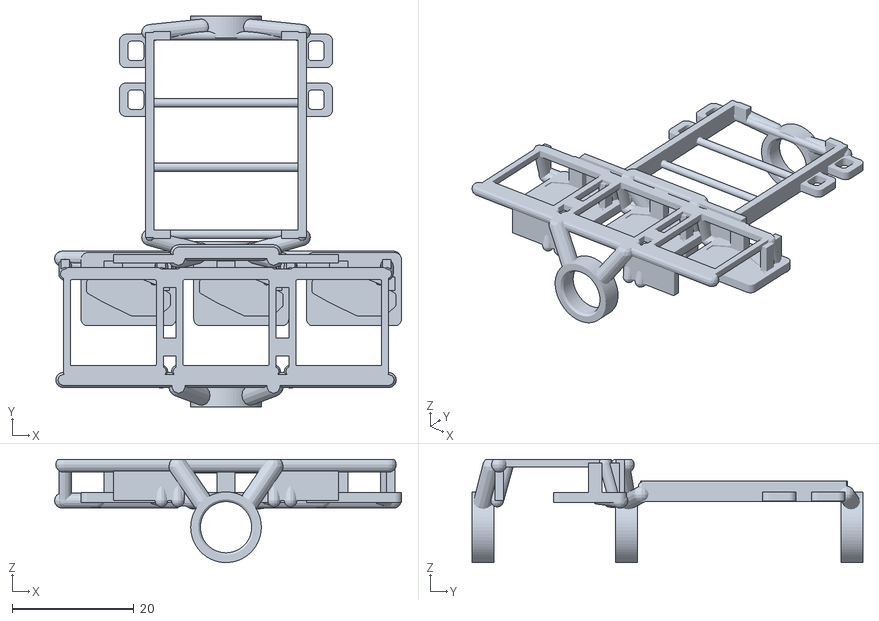
[picture p57: CAD file, 2026-11-02]
magic-wand/hardware/carbon-rod-holders-r6-three-key/exports/Key_Battery_Carrier-assembly.stl
56.9 x 64.1 x 16.9
