EthanSK/magic-wand/magic-wand/hardware/carbon-rod-holders/exports/XIAO_Rod_Holder-assembly.stl

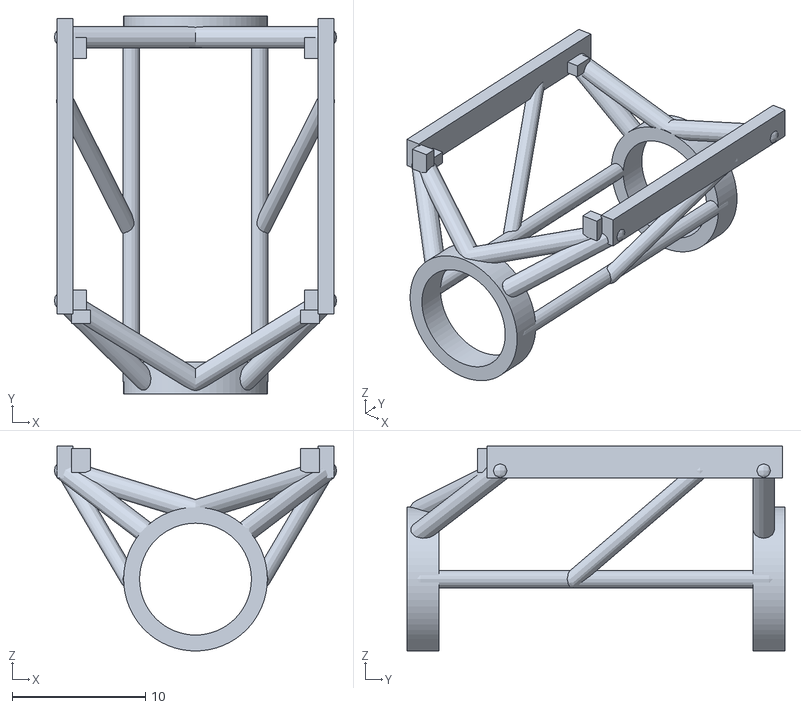
[picture p58: CAD file, 2026-10-30]
magic-wand/hardware/carbon-rod-holders/exports/XIAO_Rod_Holder-assembly.stl
21.2 x 28.4 x 15.4
