EthanSK/magic-wand/magic-wand/hardware/carbon-rod-holders-r16-repair/exports/Battery_Holder-assembly.stl

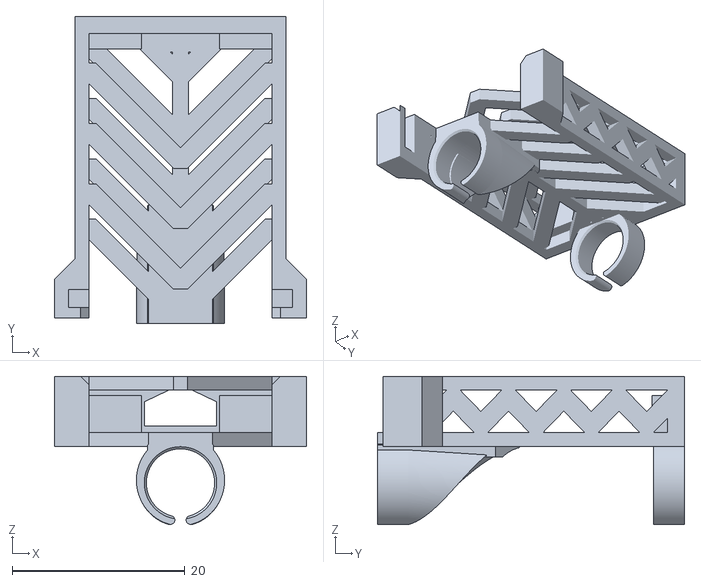
[picture p59: CAD file, 2026-11-08]
magic-wand/hardware/carbon-rod-holders-r16-repair/exports/Battery_Holder-assembly.stl
29.2 x 35.6 x 17.2
