EthanSK/magic-wand/magic-wand/hardware/carbon-rod-holders-r22-integrated-guard/exports/Key_Carrier-assembly.stl

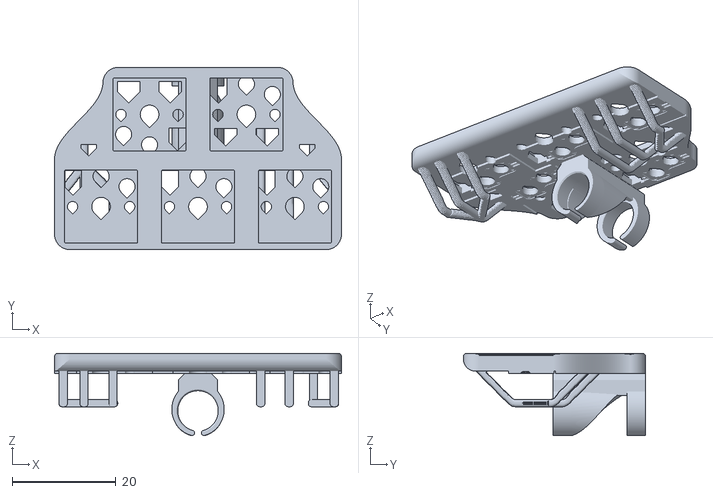
[picture p62: CAD file, 2026-11-10]
magic-wand/hardware/carbon-rod-holders-r22-integrated-guard/exports/Key_Carrier-assembly.stl
55.4 x 35.2 x 15.9
