EthanSK/magic-wand/magic-wand/hardware/carbon-rod-holders-r25-keeper-release/exports/XIAO_Near_Keeper-assembly.stl

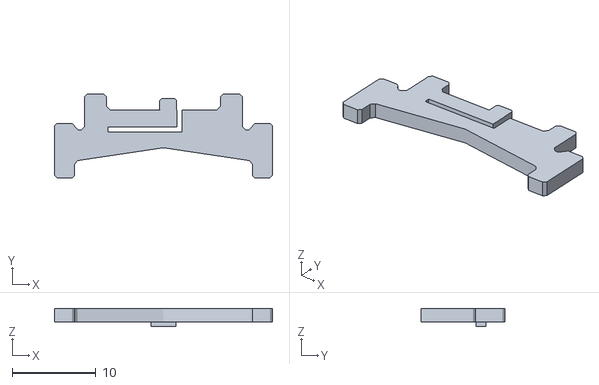
[picture p63: CAD file, 2026-11-10]
magic-wand/hardware/carbon-rod-holders-r25-keeper-release/exports/XIAO_Near_Keeper-assembly.stl
26.0 x 10.0 x 2.15
