EthanSK/magic-wand/magic-wand/hardware/carbon-rod-holders-r34-straight-op1/exports/DFRobot_Hole_Bracket-assembly.stl

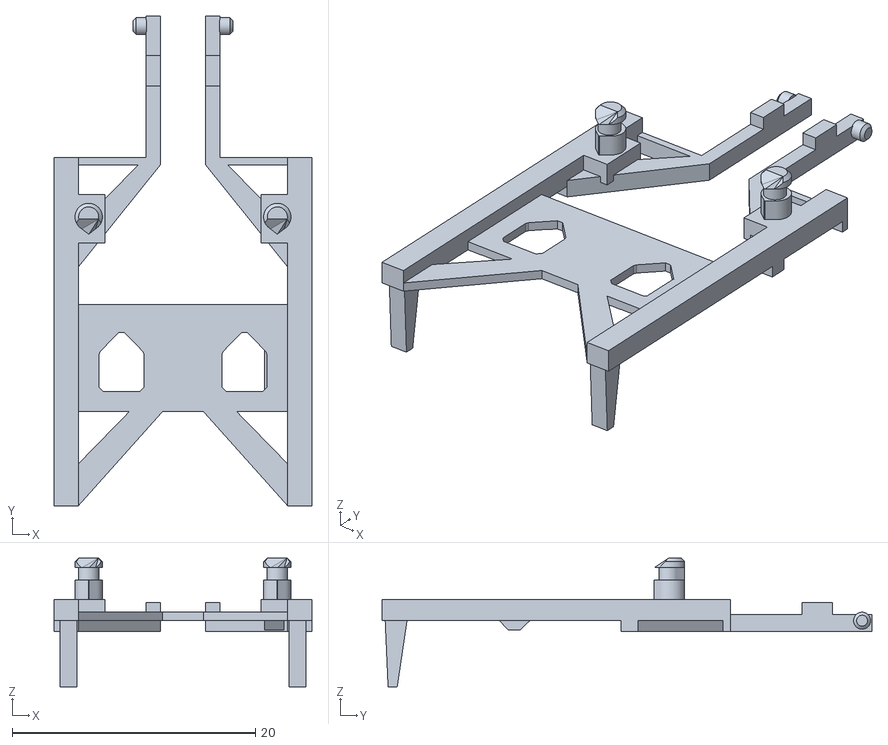
[picture p64: CAD file, 2026-11-11]
magic-wand/hardware/carbon-rod-holders-r34-straight-op1/exports/DFRobot_Hole_Bracket-assembly.stl
21.2 x 40.2 x 10.6
