EthanSK/magic-wand/magic-wand/hardware/carbon-rod-holders-r35-backed-roots/exports/DFRobot_Hole_Bracket-assembly.stl

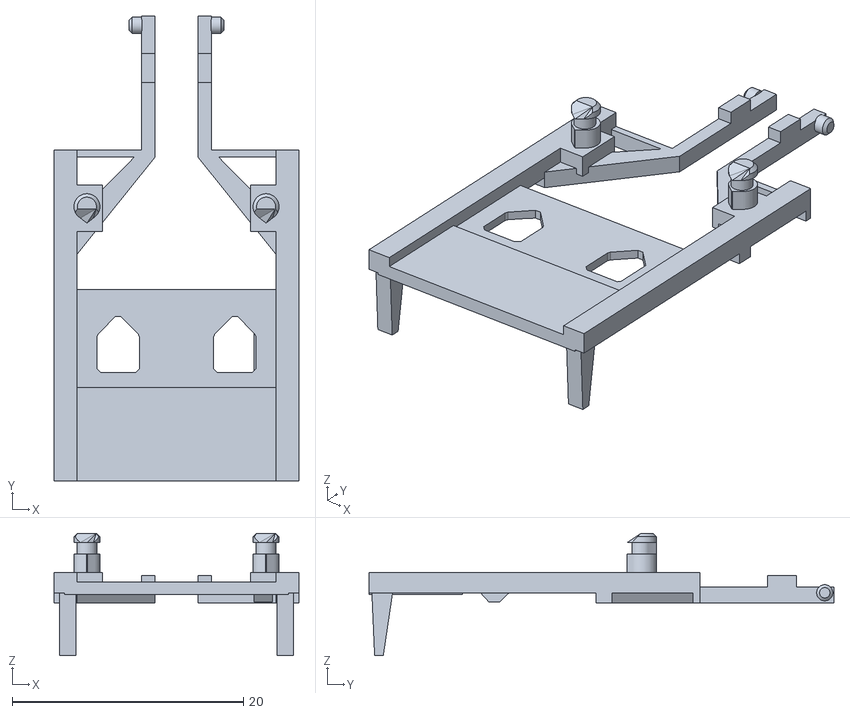
[picture p65: CAD file, 2026-11-12]
magic-wand/hardware/carbon-rod-holders-r35-backed-roots/exports/DFRobot_Hole_Bracket-assembly.stl
21.2 x 40.2 x 10.6
