EthanSK/magic-wand/magic-wand/hardware/carbon-rod-holders-r36-grove-touch/exports/Grove_Touch_Bracket-assembly.stl

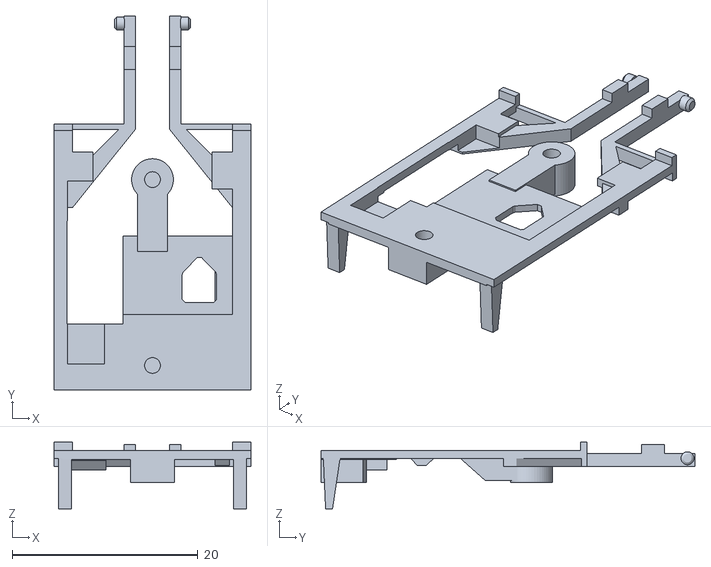
[picture p66: CAD file, 2026-11-12]
magic-wand/hardware/carbon-rod-holders-r36-grove-touch/exports/Grove_Touch_Bracket-assembly.stl
21.2 x 40.2 x 7.20
