EthanSK/magic-wand/magic-wand/hardware/carbon-rod-holders-r38-centred-op1/exports/Key_Carrier-assembly.stl

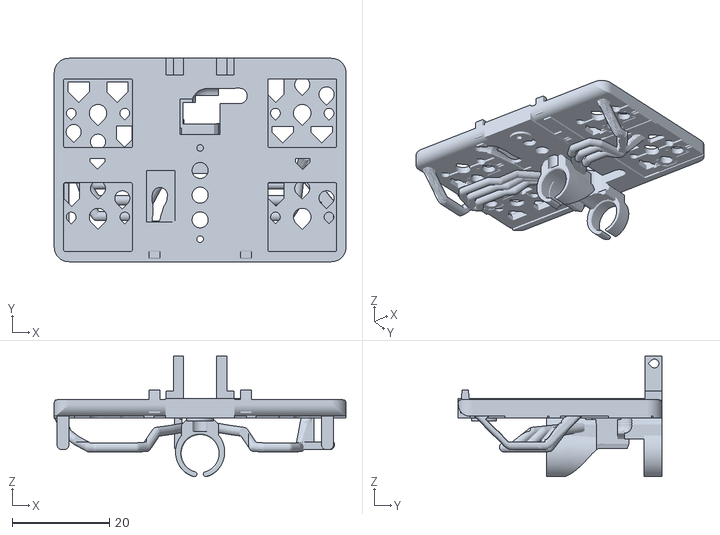
[picture p67: CAD file, 2026-11-14]
magic-wand/hardware/carbon-rod-holders-r38-centred-op1/exports/Key_Carrier-assembly.stl
60.0 x 41.9 x 24.8
