EthanSK/magic-wand/magic-wand/hardware/carbon-rod-holders-r12-closer-thumb/exports/Key_Carrier-assembly.stl

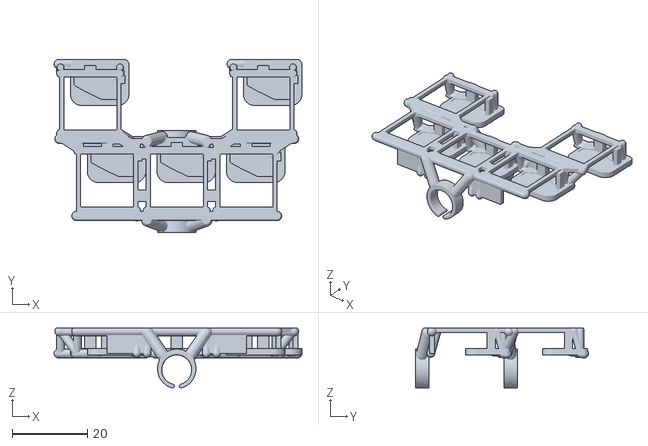
[picture p68: CAD file, 2026-11-02]
magic-wand/hardware/carbon-rod-holders-r12-closer-thumb/exports/Key_Carrier-assembly.stl
66.0 x 46.1 x 15.9
