EthanSK/magic-wand/magic-wand/hardware/carbon-rod-holders-r14-pyramid/exports/Key_Carrier-assembly.stl

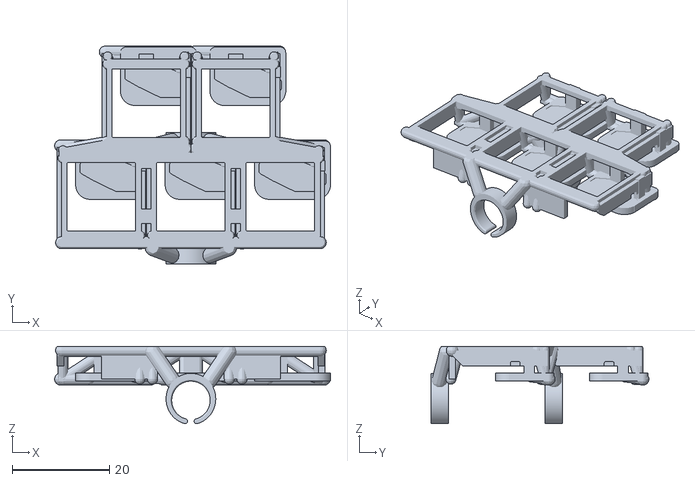
[picture p69: CAD file, 2026-11-06]
magic-wand/hardware/carbon-rod-holders-r14-pyramid/exports/Key_Carrier-assembly.stl
56.8 x 44.8 x 15.9
