EthanSK/magic-wand/magic-wand/hardware/carbon-rod-holders-r16-repair/exports/Battery_End_Gate-assembly.stl

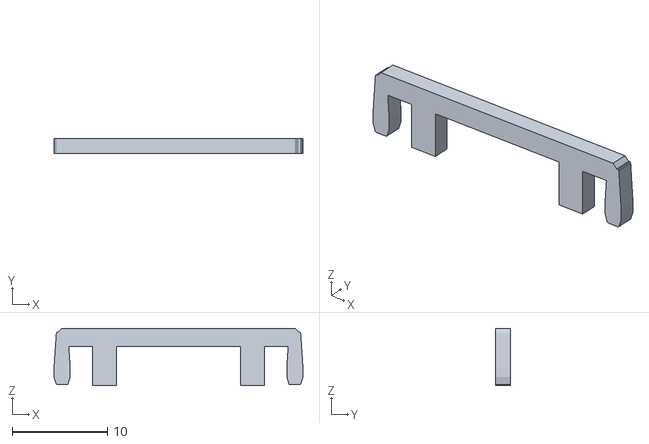
[picture p70: CAD file, 2026-11-08]
magic-wand/hardware/carbon-rod-holders-r16-repair/exports/Battery_End_Gate-assembly.stl
26.1 x 1.60 x 6.00
