EthanSK/magic-wand/magic-wand/hardware/carbon-rod-holders-r17-anchored-repair/exports/XIAO_Rod_Holder-assembly.stl

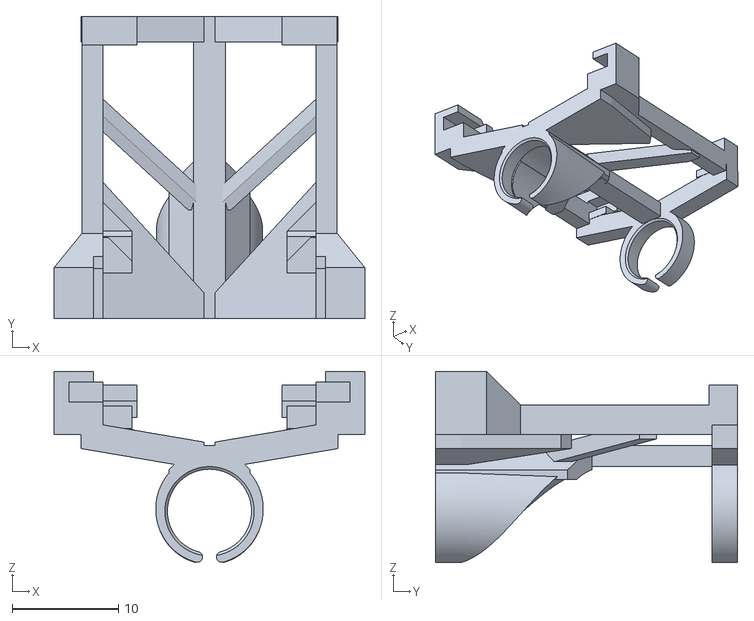
[picture p71: CAD file, 2026-11-08]
magic-wand/hardware/carbon-rod-holders-r17-anchored-repair/exports/XIAO_Rod_Holder-assembly.stl
29.2 x 28.4 x 18.0
