EthanSK/magic-wand/magic-wand/hardware/carbon-rod-holders-r20-finger-guard/exports/Battery_Holder-assembly.stl

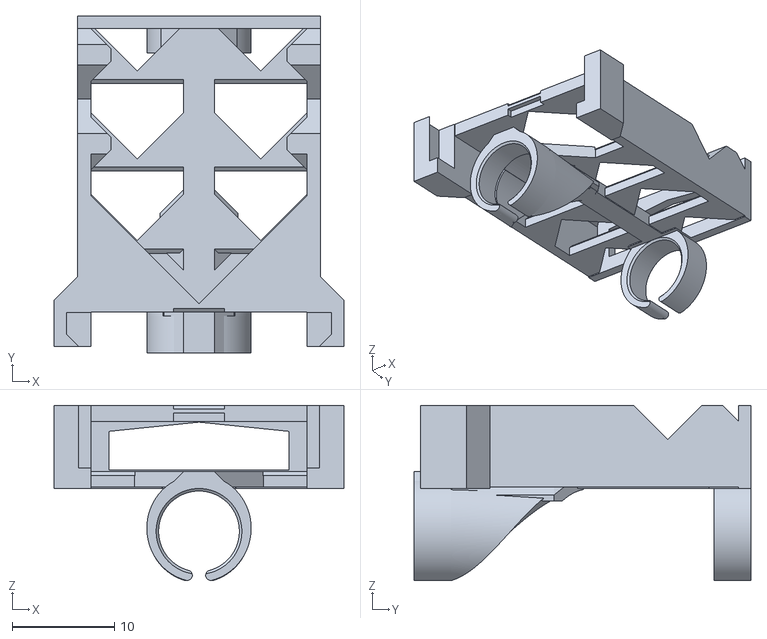
[picture p72: CAD file, 2026-11-10]
magic-wand/hardware/carbon-rod-holders-r20-finger-guard/exports/Battery_Holder-assembly.stl
28.4 x 33.0 x 17.2
