EthanSK/magic-wand/magic-wand/hardware/carbon-rod-holders-r23-hybrid-centre/exports/Centre_Paddle_Deep_Trial-assembly.stl

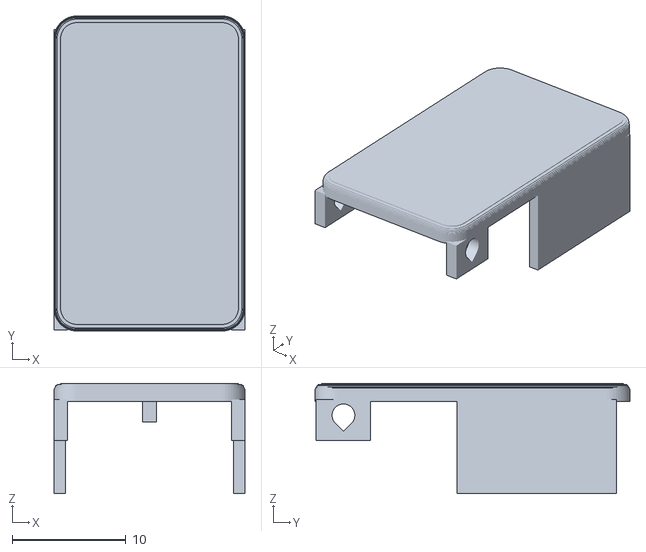
[picture p73: CAD file, 2026-11-10]
magic-wand/hardware/carbon-rod-holders-r23-hybrid-centre/exports/Centre_Paddle_Deep_Trial-assembly.stl
16.8 x 27.7 x 9.68
