EthanSK/magic-wand/magic-wand/hardware/carbon-rod-holders-r29-dfrobot-snap-arms/exports/DFRobot_Touch_Tray-assembly.stl

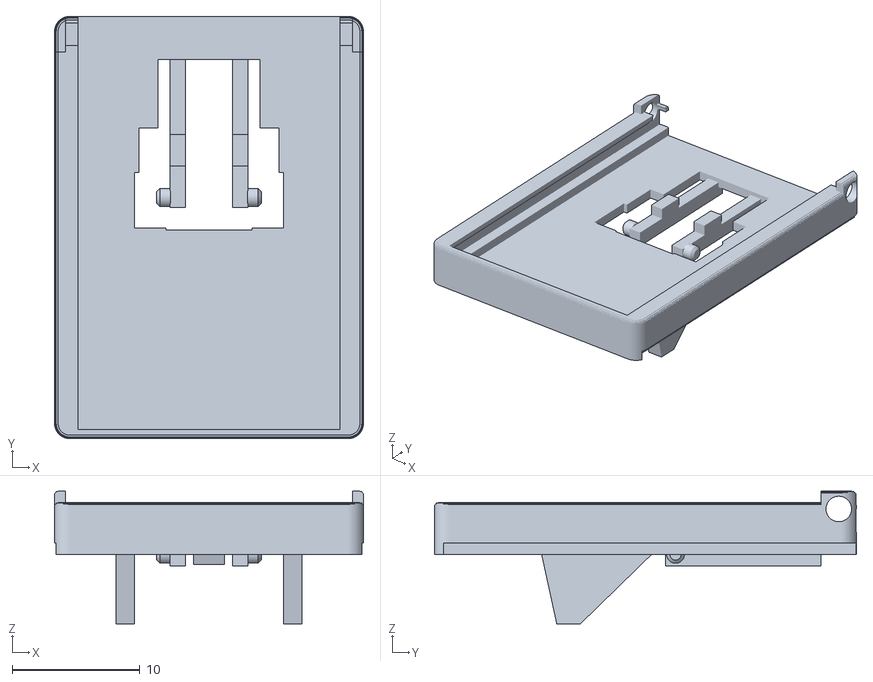
[picture p74: CAD file, 2026-11-11]
magic-wand/hardware/carbon-rod-holders-r29-dfrobot-snap-arms/exports/DFRobot_Touch_Tray-assembly.stl
24.2 x 33.1 x 10.4
