EthanSK/magic-wand/magic-wand/hardware/carbon-rod-holders-r3/exports/Key_Battery_Carrier-assembly.stl

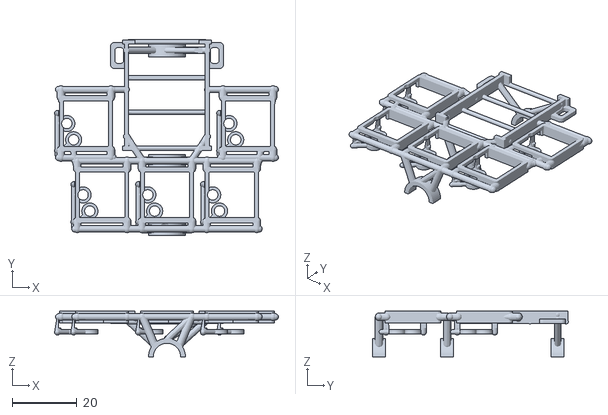
[picture p75: CAD file, 2026-11-01]
magic-wand/hardware/carbon-rod-holders-r3/exports/Key_Battery_Carrier-assembly.stl
69.1 x 60.4 x 14.1
