EthanSK/magic-wand/magic-wand/hardware/carbon-rod-holders-r30-dfrobot-hole-mount/exports/DFRobot_Hole_Bracket-assembly.stl

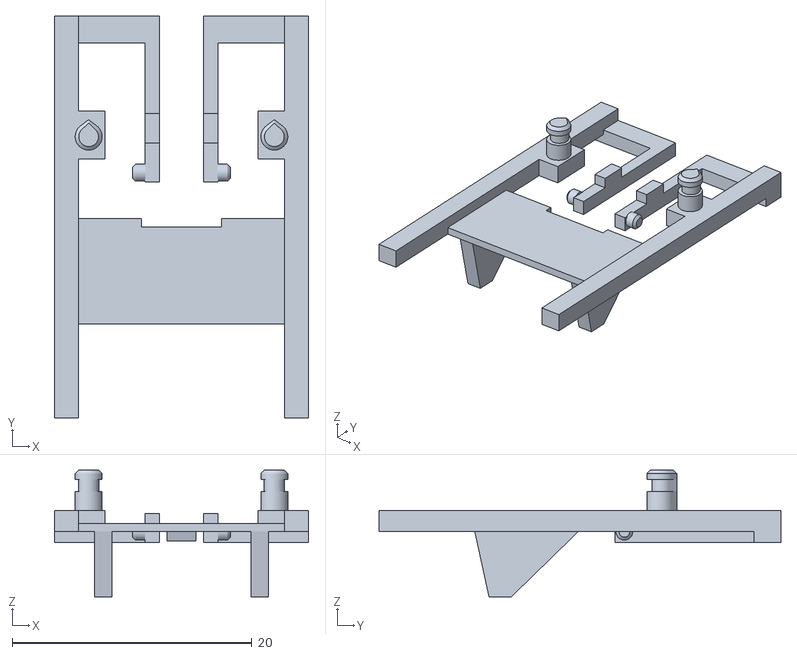
[picture p76: CAD file, 2026-11-11]
magic-wand/hardware/carbon-rod-holders-r30-dfrobot-hole-mount/exports/DFRobot_Hole_Bracket-assembly.stl
21.2 x 33.5 x 10.6
