EthanSK/magic-wand/magic-wand/hardware/carbon-rod-holders-r37-adjustable-op1/exports/Key_Carrier-assembly.stl

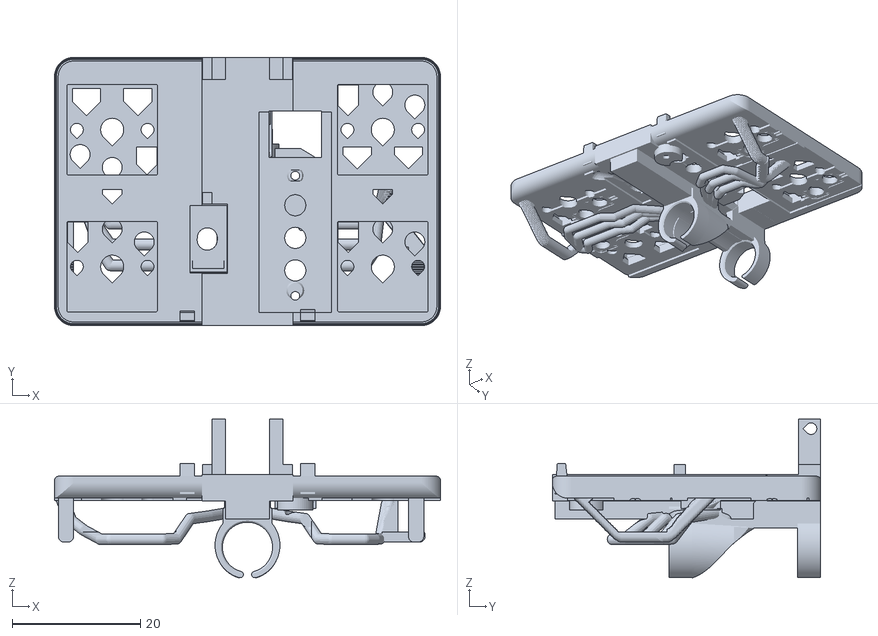
[picture p78: CAD file, 2026-11-12]
magic-wand/hardware/carbon-rod-holders-r37-adjustable-op1/exports/Key_Carrier-assembly.stl
60.2 x 41.9 x 24.8
