EthanSK/magic-wand/magic-wand-3d-models/Slim-Loop-slim-complete-both-hands.3mf

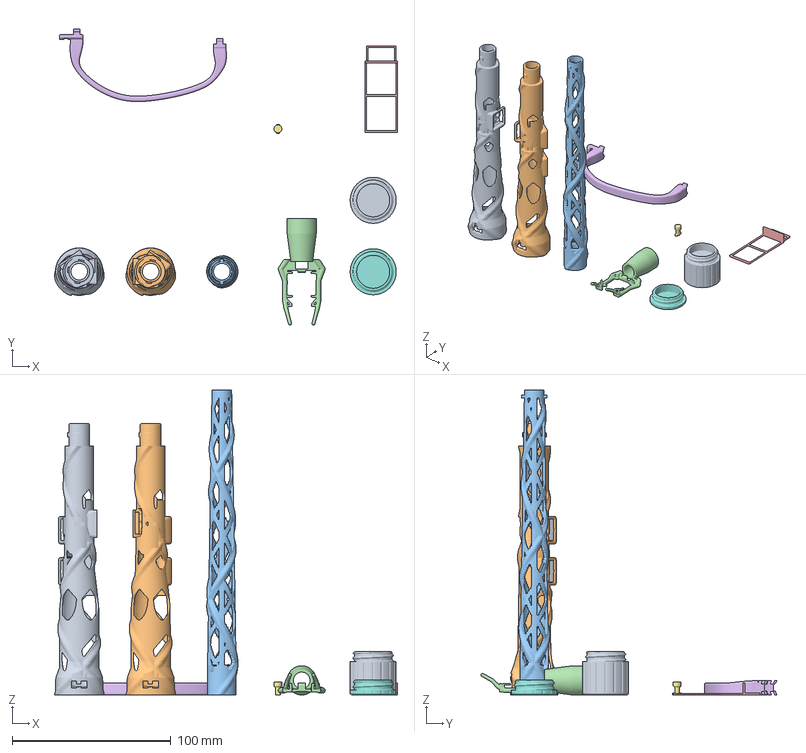
[picture p79: CAD file, 2026-10-28]
magic-wand-3d-models/Slim-Loop-slim-complete-both-hands.3mf
215.9 x 186.3 x 192.0 mm
Grip_Left
Grip_Right
Continuous_Shaft
Sense_Open_Cradle
Battery_Sled
Removable_Finger_Loop
Loop_Keeper_Key
Battery_Screw_Cap_Light
Battery_Screw_Cap_Weighted
