EthanSK/magic-wand/magic-wand/hardware/carbon-rod-holders-r15-tight-pyramid/exports/Key_Carrier-PRINT-HELPER-assembly.stl

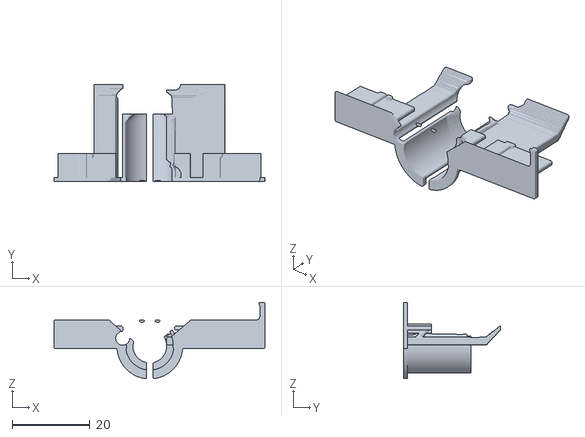
[picture p80: CAD file, 2026-11-06]
magic-wand/hardware/carbon-rod-holders-r15-tight-pyramid/exports/Key_Carrier-PRINT-HELPER-assembly.stl
54.4 x 25.0 x 19.7
