EthanSK/magic-wand/magic-wand/hardware/carbon-rod-holders-r19-lightweight/exports/XIAO_Rod_Holder-assembly.stl

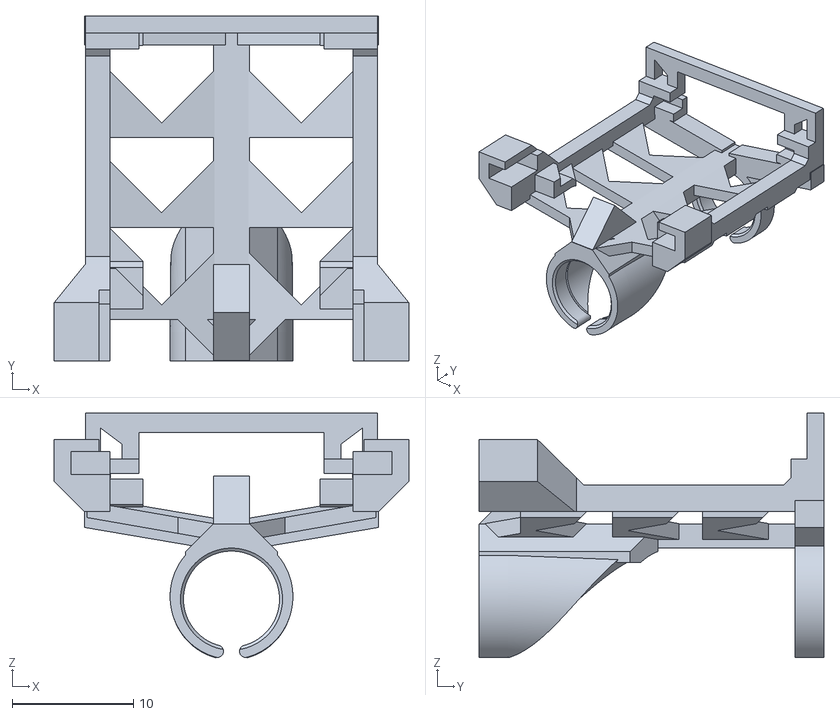
[picture p81: CAD file, 2026-11-09]
magic-wand/hardware/carbon-rod-holders-r19-lightweight/exports/XIAO_Rod_Holder-assembly.stl
29.2 x 28.4 x 20.1
