EthanSK/magic-wand/magic-wand/hardware/carbon-rod-holders-r29-dfrobot-snap-arms/exports/Key_Carrier-assembly.stl

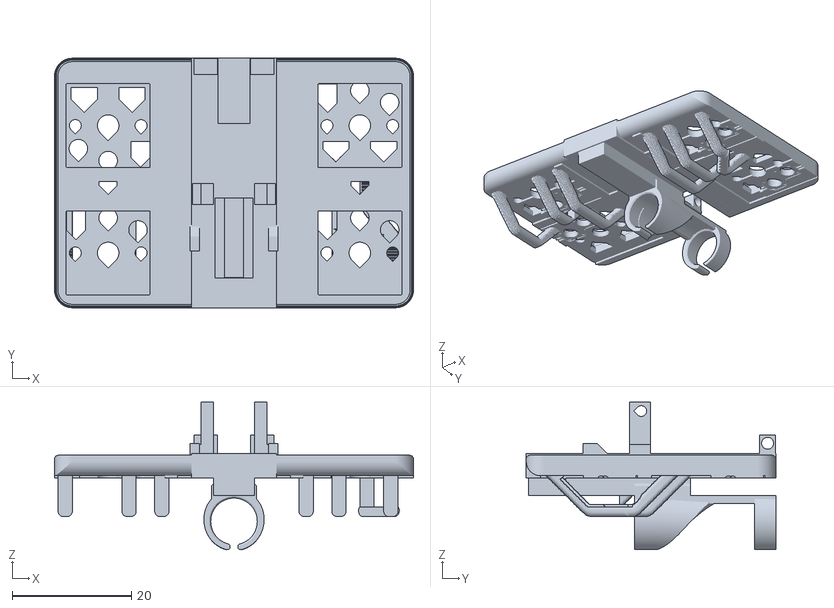
[picture p82: CAD file, 2026-11-11]
magic-wand/hardware/carbon-rod-holders-r29-dfrobot-snap-arms/exports/Key_Carrier-assembly.stl
60.2 x 41.9 x 24.8
