EthanSK/magic-wand/magic-wand/hardware/carbon-rod-holders-r38-centred-op1/exports/Grove_Touch_Bracket-assembly.stl

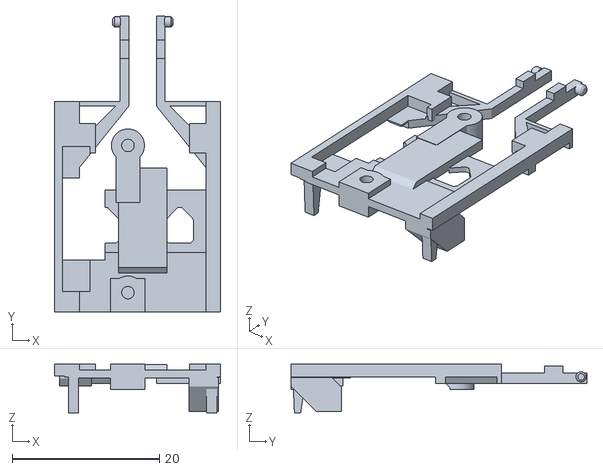
[picture p84: CAD file, 2026-11-14]
magic-wand/hardware/carbon-rod-holders-r38-centred-op1/exports/Grove_Touch_Bracket-assembly.stl
22.6 x 40.2 x 6.66
