EthanSK/magic-wand/magic-wand/hardware/carbon-rod-holders-r7-spring-clips/exports/Carrier_rear-assembly.stl

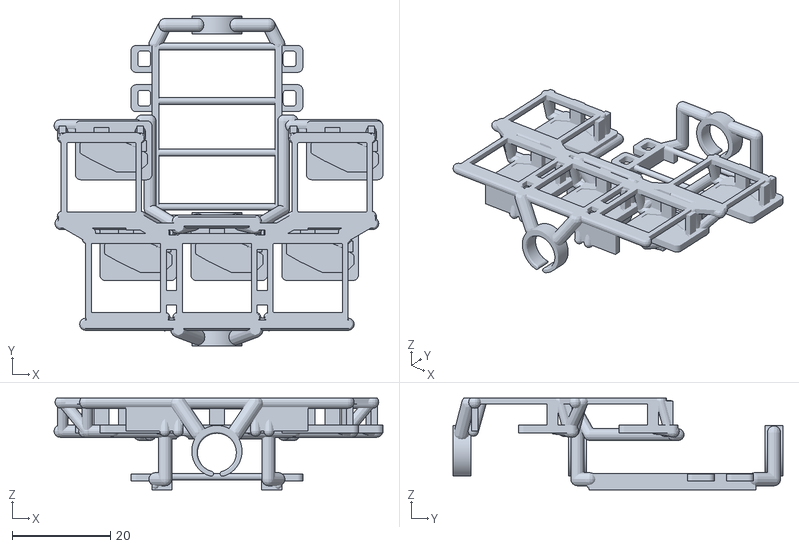
[picture p85: CAD file, 2026-11-02]
magic-wand/hardware/carbon-rod-holders-r7-spring-clips/exports/Carrier_rear-assembly.stl
67.0 x 67.1 x 18.7
