EthanSK/magic-wand/magic-wand/hardware/carbon-rod-holders-r21-cable-clip/exports/Cable_Clip_4mm-assembly.stl

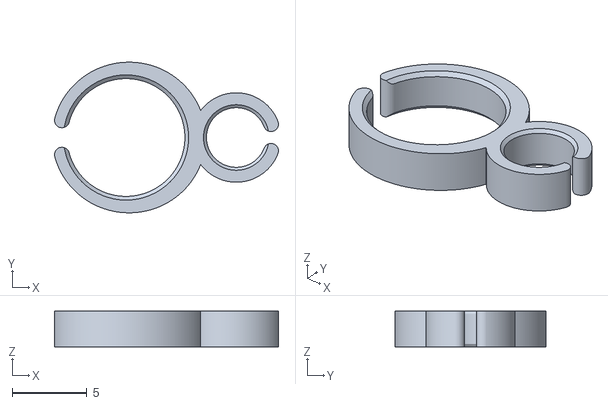
[picture p86: CAD file, 2026-11-10]
magic-wand/hardware/carbon-rod-holders-r21-cable-clip/exports/Cable_Clip_4mm-assembly.stl
15.0 x 10.1 x 2.40
