EthanSK/magic-wand/magic-wand/hardware/carbon-rod-holders-r26-dfrobot-centre/exports/OP1_Board_Latch-assembly.stl

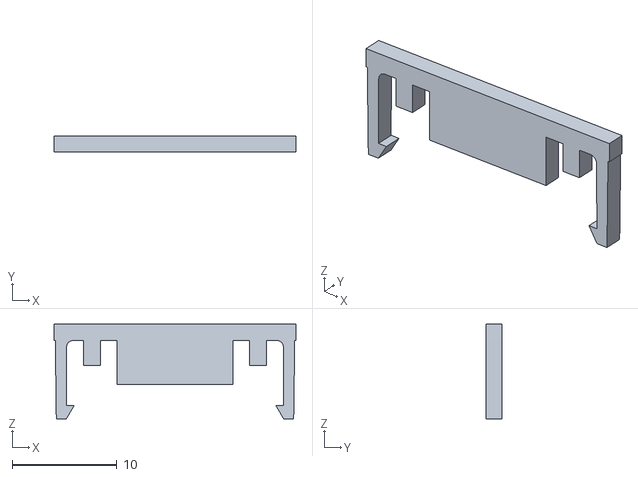
[picture p87: CAD file, 2026-11-11]
magic-wand/hardware/carbon-rod-holders-r26-dfrobot-centre/exports/OP1_Board_Latch-assembly.stl
23.1 x 1.54 x 9.04
