EthanSK/magic-wand/magic-wand/hardware/carbon-rod-holders-r29-dfrobot-snap-arms/exports/OP1_Rear_Keeper-assembly.stl

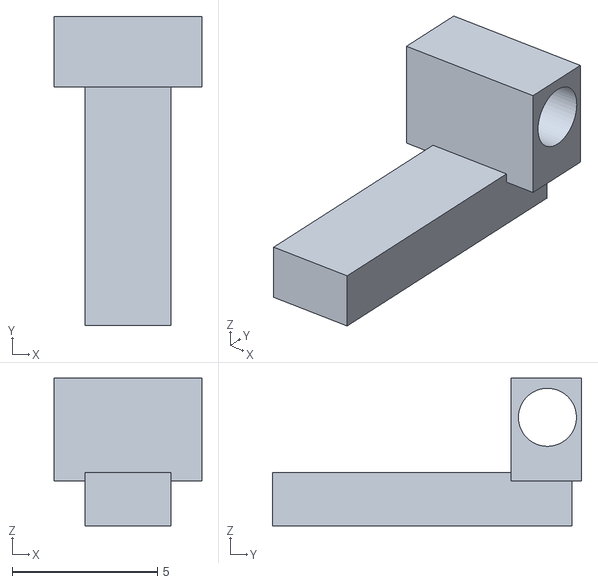
[picture p88: CAD file, 2026-11-11]
magic-wand/hardware/carbon-rod-holders-r29-dfrobot-snap-arms/exports/OP1_Rear_Keeper-assembly.stl
5.10 x 10.7 x 5.09
