EthanSK/magic-wand/magic-wand/hardware/carbon-rod-holders-r5/exports/Carrier_front-assembly.stl

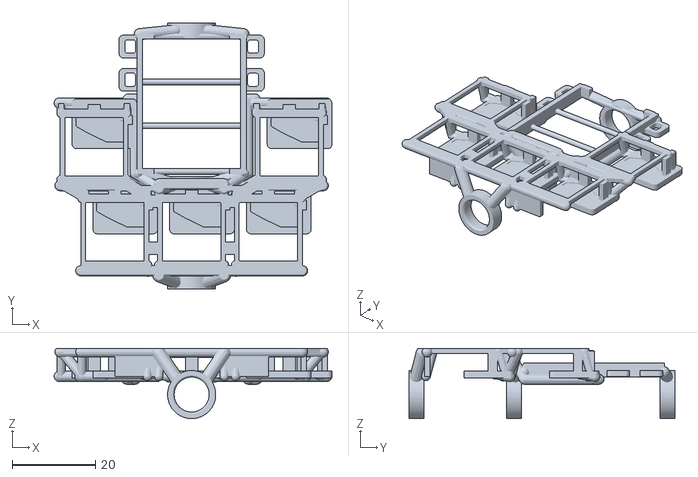
[picture p89: CAD file, 2026-11-02]
magic-wand/hardware/carbon-rod-holders-r5/exports/Carrier_front-assembly.stl
67.0 x 64.1 x 16.9
