EthanSK/magic-wand/magic-wand/hardware/carbon-rod-holders-r12-closer-thumb/exports/Battery_End_Gate-assembly.stl

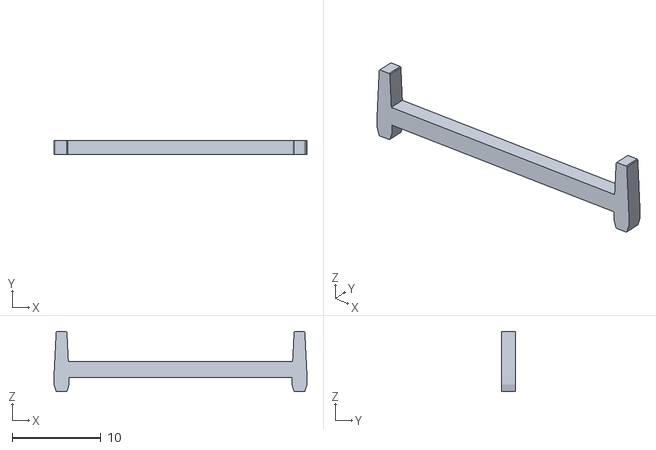
[picture p90: CAD file, 2026-11-02]
magic-wand/hardware/carbon-rod-holders-r12-closer-thumb/exports/Battery_End_Gate-assembly.stl
28.5 x 1.60 x 6.80
