EthanSK/magic-wand/magic-wand/hardware/carbon-rod-holders-r15-tight-pyramid/exports/XIAO_Rod_Holder-PRINT-HELPER-assembly.stl

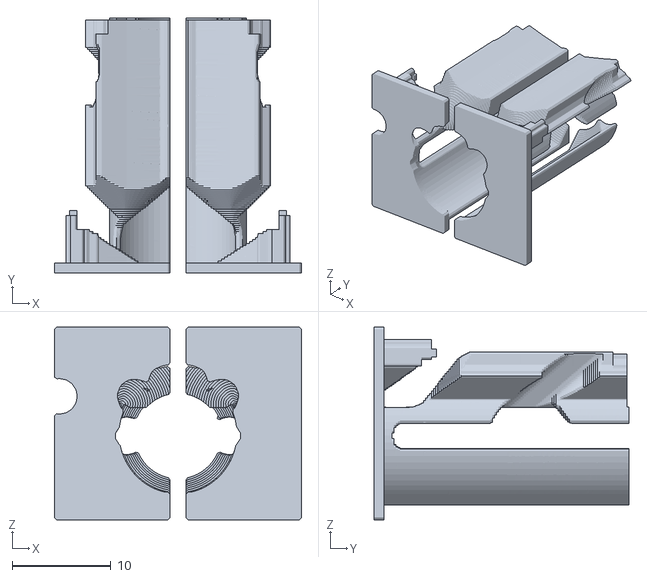
[picture p91: CAD file, 2026-11-05]
magic-wand/hardware/carbon-rod-holders-r15-tight-pyramid/exports/XIAO_Rod_Holder-PRINT-HELPER-assembly.stl
25.0 x 25.8 x 19.5
