EthanSK/magic-wand/magic-wand/hardware/carbon-rod-holders-r26-dfrobot-centre/exports/Key_Carrier-assembly.stl

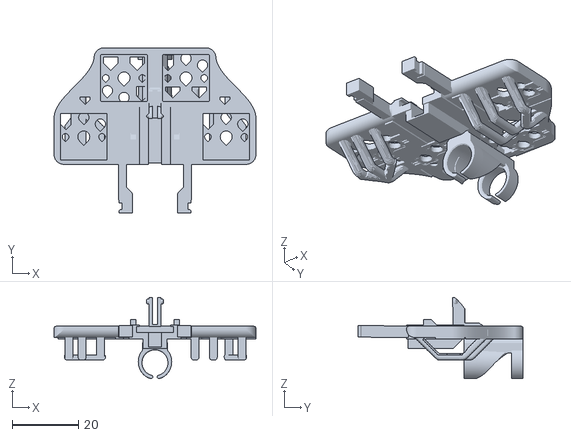
[picture p92: CAD file, 2026-11-11]
magic-wand/hardware/carbon-rod-holders-r26-dfrobot-centre/exports/Key_Carrier-assembly.stl
61.0 x 49.9 x 24.6
