EthanSK/magic-wand/magic-wand/hardware/carbon-rod-holders-r37-adjustable-op1/exports/Grove_Touch_Bracket-assembly.stl

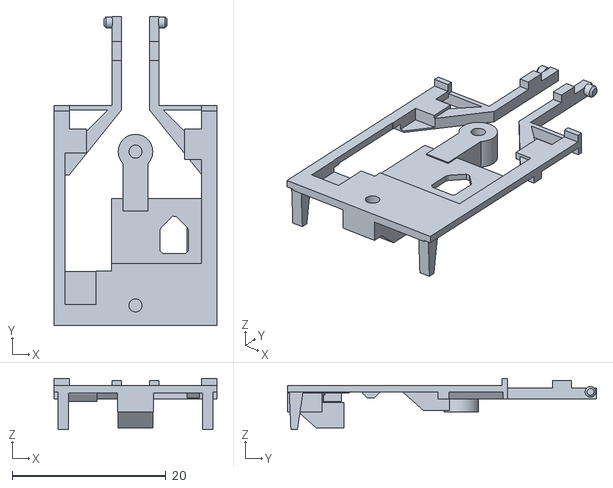
[picture p93: CAD file, 2026-11-12]
magic-wand/hardware/carbon-rod-holders-r37-adjustable-op1/exports/Grove_Touch_Bracket-assembly.stl
21.2 x 40.2 x 6.66
