EthanSK/magic-wand/magic-wand/hardware/carbon-rod-holders-r15-tight-pyramid/exports/Battery_Holder-PRINT-HELPER-assembly.stl

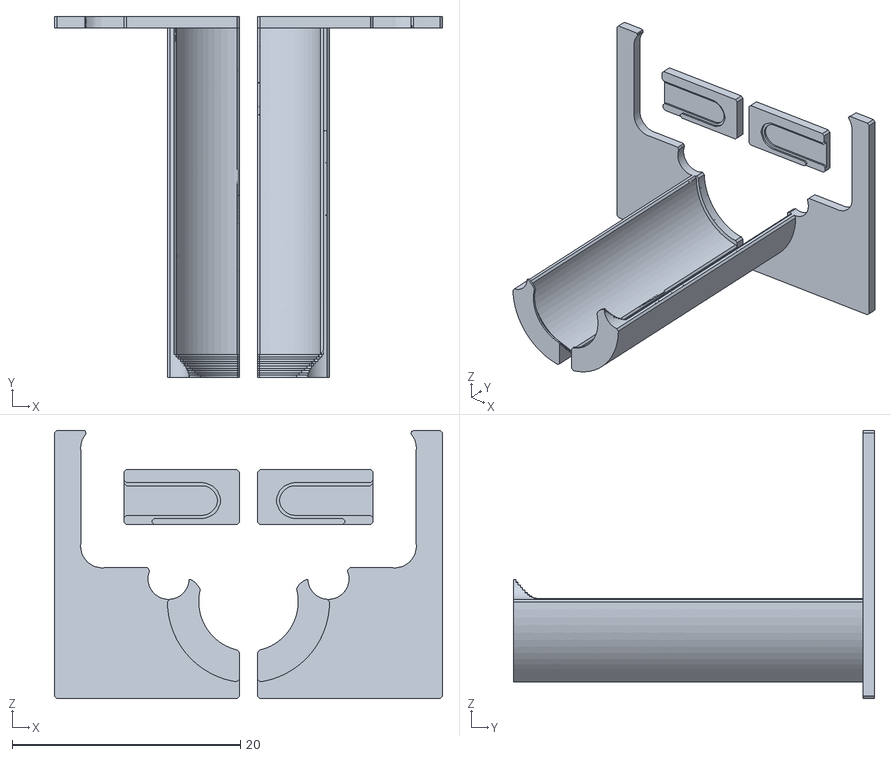
[picture p94: CAD file, 2026-11-05]
magic-wand/hardware/carbon-rod-holders-r15-tight-pyramid/exports/Battery_Holder-PRINT-HELPER-assembly.stl
34.0 x 31.6 x 23.5
