EthanSK/magic-wand/magic-wand/hardware/carbon-rod-holders-r19-lightweight/exports/Battery_Holder-assembly.stl

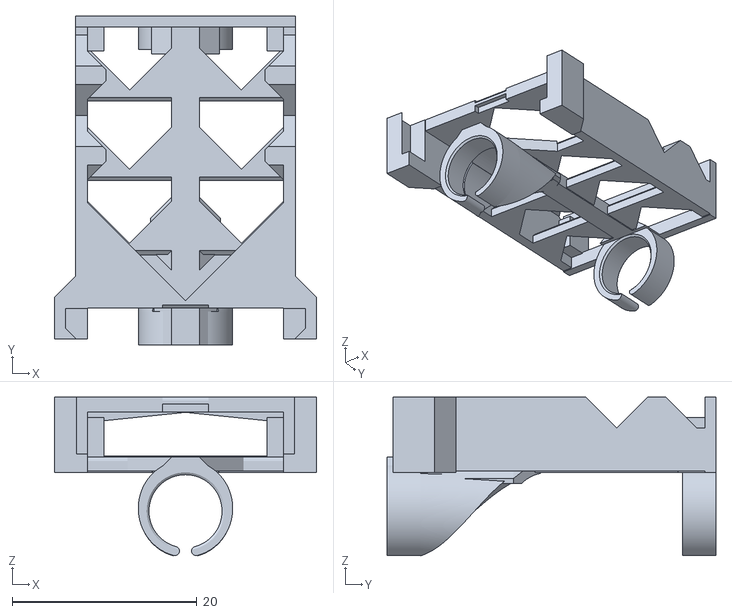
[picture p95: CAD file, 2026-11-09]
magic-wand/hardware/carbon-rod-holders-r19-lightweight/exports/Battery_Holder-assembly.stl
28.4 x 35.6 x 17.2
