EthanSK/magic-wand/magic-wand/hardware/carbon-rod-holders-r36-grove-touch/exports/Battery_Spacer_0p4mm_Patterned-assembly.stl

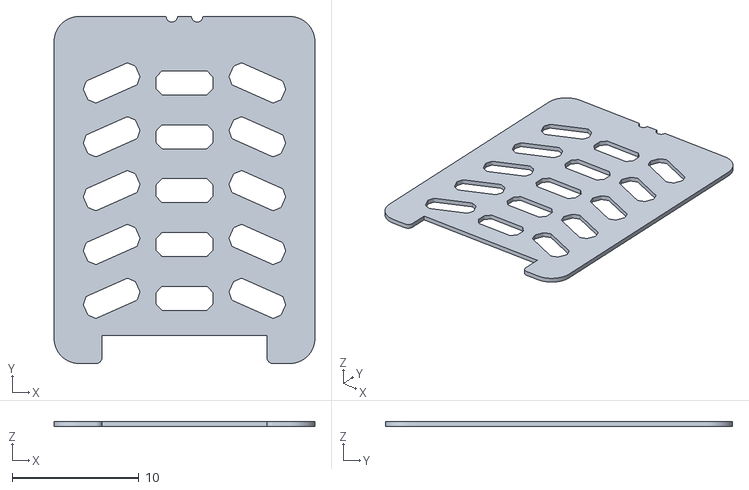
[picture p96: CAD file, 2026-11-11]
magic-wand/hardware/carbon-rod-holders-r36-grove-touch/exports/Battery_Spacer_0p4mm_Patterned-assembly.stl
20.6 x 27.4 x 0.4
