EthanSK/magic-wand/magic-wand/hardware/carbon-rod-holders-r5/exports/Carrier_rear-assembly.stl

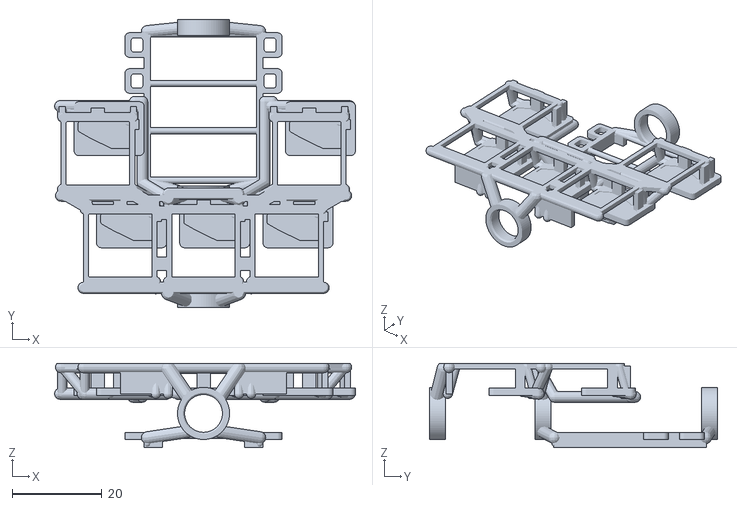
[picture p97: CAD file, 2026-11-02]
magic-wand/hardware/carbon-rod-holders-r5/exports/Carrier_rear-assembly.stl
67.0 x 64.1 x 18.7
