EthanSK/magic-wand/magic-wand/hardware/carbon-rod-holders-r7-spring-clips/exports/Carrier_lower-assembly.stl

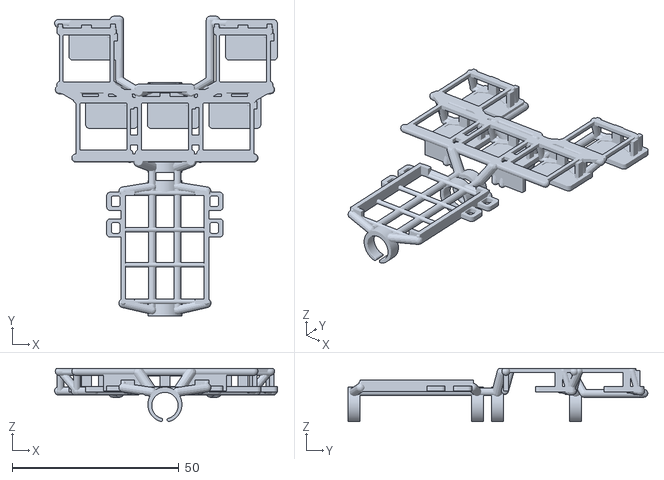
[picture p98: CAD file, 2026-11-02]
magic-wand/hardware/carbon-rod-holders-r7-spring-clips/exports/Carrier_lower-assembly.stl
67.0 x 90.0 x 15.9
