EthanSK/magic-wand/magic-wand/hardware/carbon-rod-holders-r12-closer-thumb/exports/Battery_Holder-assembly.stl

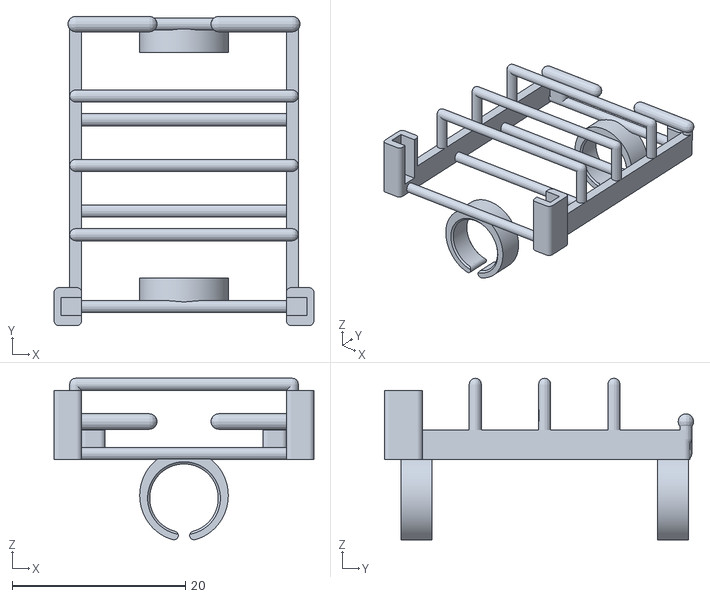
[picture p99: CAD file, 2026-11-02]
magic-wand/hardware/carbon-rod-holders-r12-closer-thumb/exports/Battery_Holder-assembly.stl
30.0 x 35.7 x 18.6
