EthanSK/magic-wand/magic-wand/hardware/carbon-rod-holders-r26-dfrobot-centre/exports/DFRobot_Front_Keeper-assembly.stl

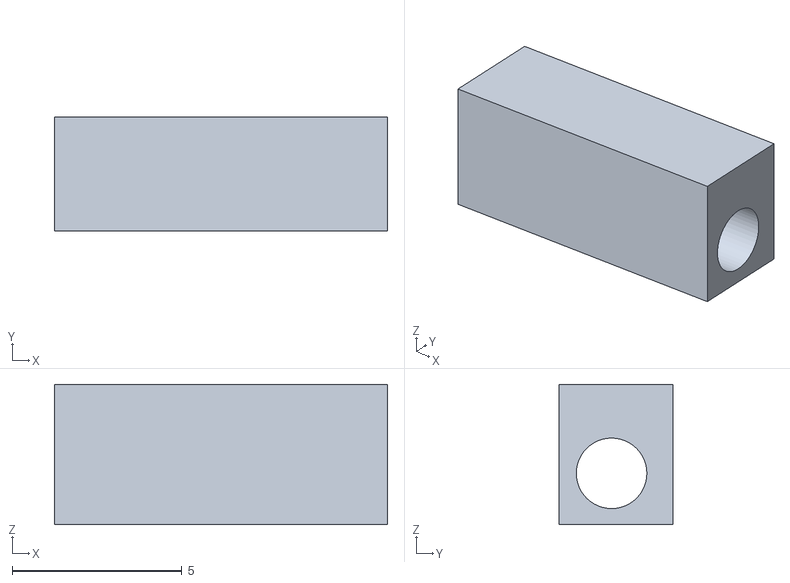
[picture p101: CAD file, 2026-11-11]
magic-wand/hardware/carbon-rod-holders-r26-dfrobot-centre/exports/DFRobot_Front_Keeper-assembly.stl
9.82 x 3.36 x 4.13
