EthanSK/magic-wand/magic-wand/hardware/carbon-rod-holders-r35-backed-roots/exports/DFR0030_Post_Clip-assembly.stl

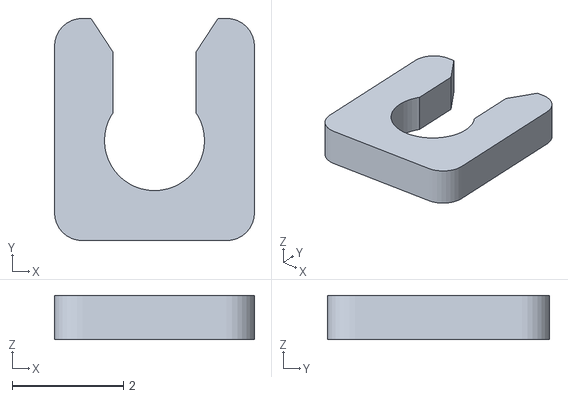
[picture p102: CAD file, 2026-11-11]
magic-wand/hardware/carbon-rod-holders-r35-backed-roots/exports/DFR0030_Post_Clip-assembly.stl
3.60 x 4.00 x 0.8
