EthanSK/magic-wand/magic-wand/hardware/carbon-rod-holders-r15-tight-pyramid/exports/Battery_End_Gate-assembly.stl

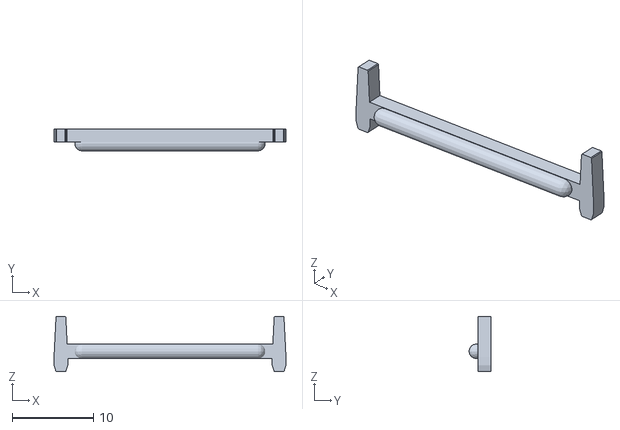
[picture p103: CAD file, 2026-11-05]
magic-wand/hardware/carbon-rod-holders-r15-tight-pyramid/exports/Battery_End_Gate-assembly.stl
28.5 x 2.70 x 6.80
