EthanSK/magic-wand/magic-wand/hardware/carbon-rod-holders-r16-repair/exports/XIAO_Rod_Holder-assembly.stl

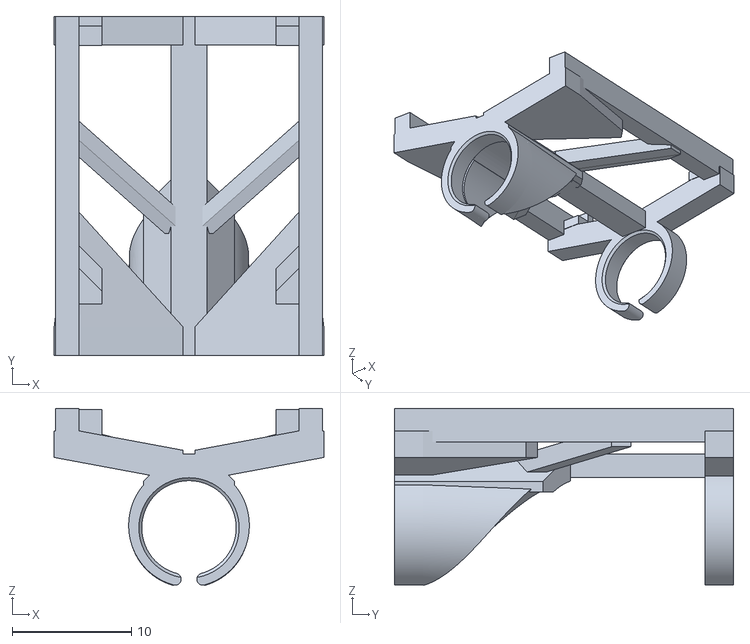
[picture p104: CAD file, 2026-11-08]
magic-wand/hardware/carbon-rod-holders-r16-repair/exports/XIAO_Rod_Holder-assembly.stl
22.6 x 28.4 x 14.8
