EthanSK/magic-wand/magic-wand/hardware/carbon-rod-holders-r22-integrated-guard/exports/Battery_End_Door_Easy_Trial-assembly.stl

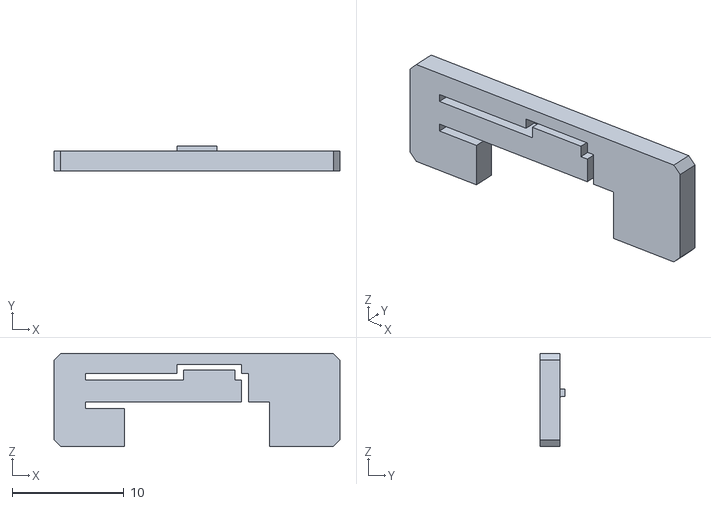
[picture p105: CAD file, 2026-11-10]
magic-wand/hardware/carbon-rod-holders-r22-integrated-guard/exports/Battery_End_Door_Easy_Trial-assembly.stl
25.6 x 2.25 x 8.35
