EthanSK/magic-wand/magic-wand/hardware/carbon-rod-holders-r23-hybrid-centre/exports/Key_Carrier-assembly.stl

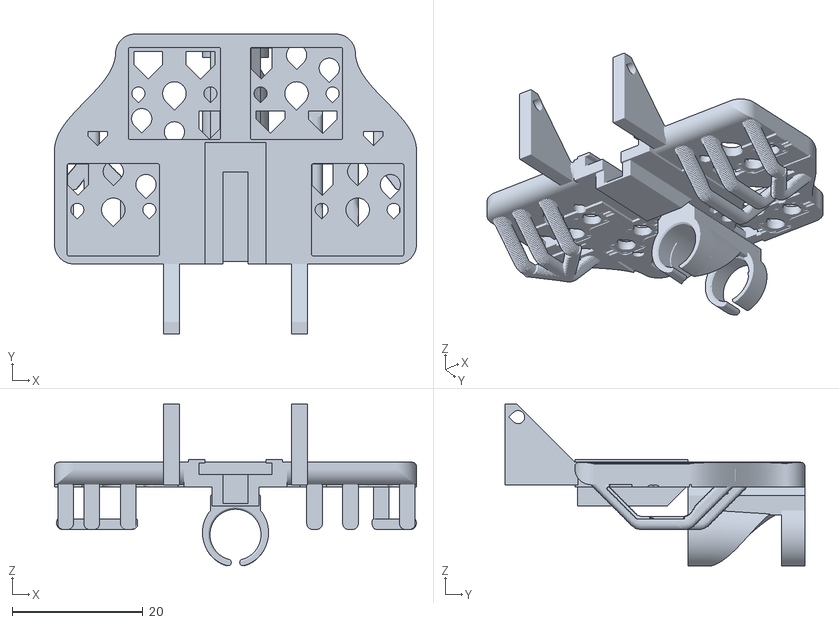
[picture p106: CAD file, 2026-11-10]
magic-wand/hardware/carbon-rod-holders-r23-hybrid-centre/exports/Key_Carrier-assembly.stl
55.4 x 45.9 x 24.8
