EthanSK/magic-wand/magic-wand/hardware/carbon-rod-holders-r5/exports/Carrier_lower-assembly.stl

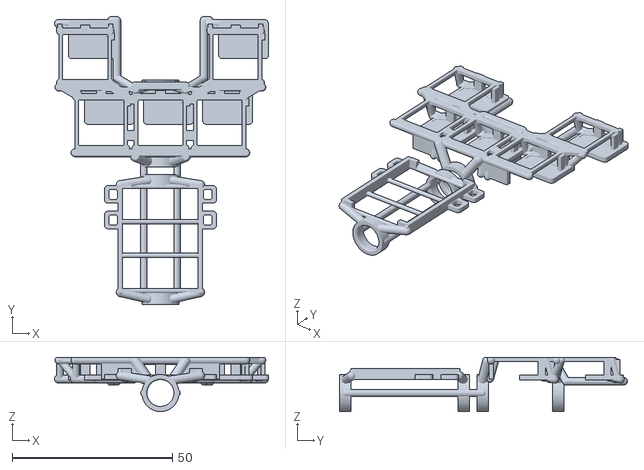
[picture p107: CAD file, 2026-11-02]
magic-wand/hardware/carbon-rod-holders-r5/exports/Carrier_lower-assembly.stl
67.0 x 90.0 x 16.9
