EthanSK/magic-wand/magic-wand/hardware/carbon-rod-holders-r17-anchored-repair/exports/XIAO_Top_Retainer-assembly.stl

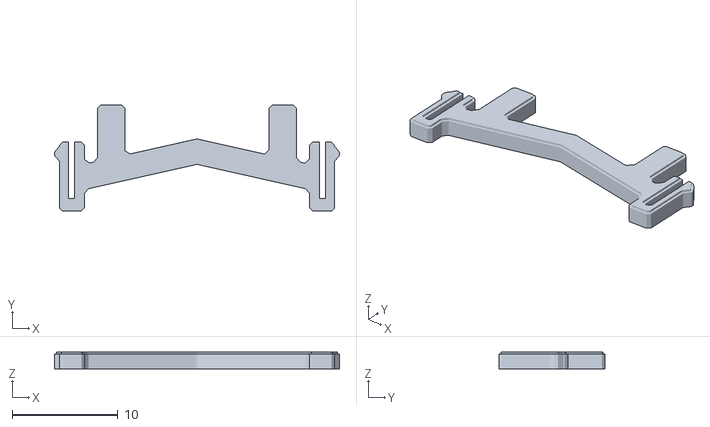
[picture p108: CAD file, 2026-11-08]
magic-wand/hardware/carbon-rod-holders-r17-anchored-repair/exports/XIAO_Top_Retainer-assembly.stl
26.9 x 10.0 x 1.60
