EthanSK/magic-wand/magic-wand/hardware/carbon-rod-holders-r26-dfrobot-centre/exports/DFRobot_Paddle-assembly.stl

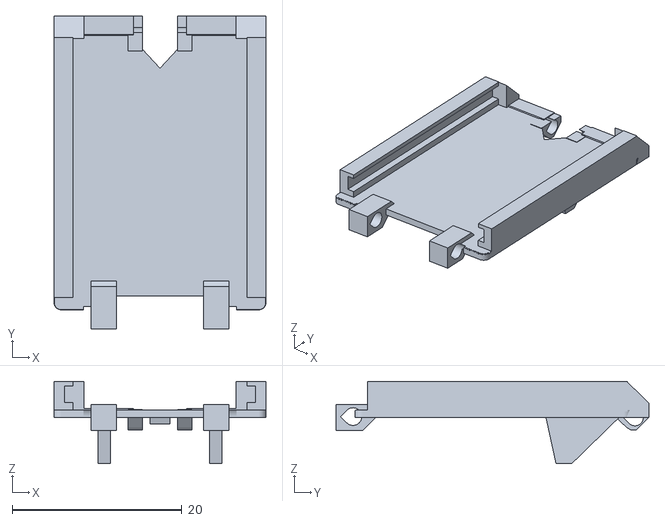
[picture p109: CAD file, 2026-11-11]
magic-wand/hardware/carbon-rod-holders-r26-dfrobot-centre/exports/DFRobot_Paddle-assembly.stl
25.0 x 36.9 x 9.70
