EthanSK/magic-wand/magic-wand/hardware/carbon-rod-holders-r7-spring-clips/exports/Carrier_front-assembly.stl

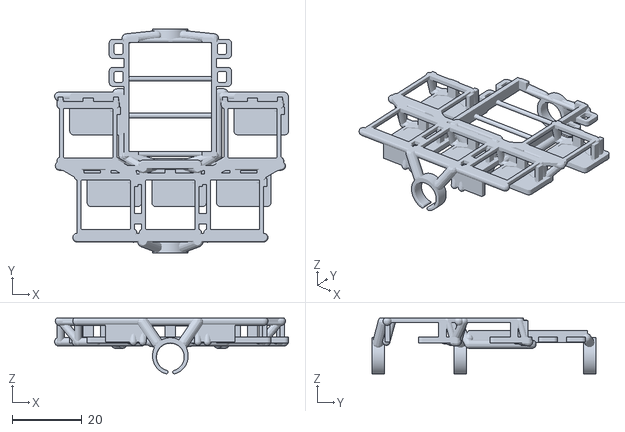
[picture p110: CAD file, 2026-11-02]
magic-wand/hardware/carbon-rod-holders-r7-spring-clips/exports/Carrier_front-assembly.stl
67.0 x 64.1 x 15.9
