EthanSK/magic-wand/magic-wand/hardware/carbon-rod-holders-r15-tight-pyramid/exports/Battery_Holder-assembly.stl

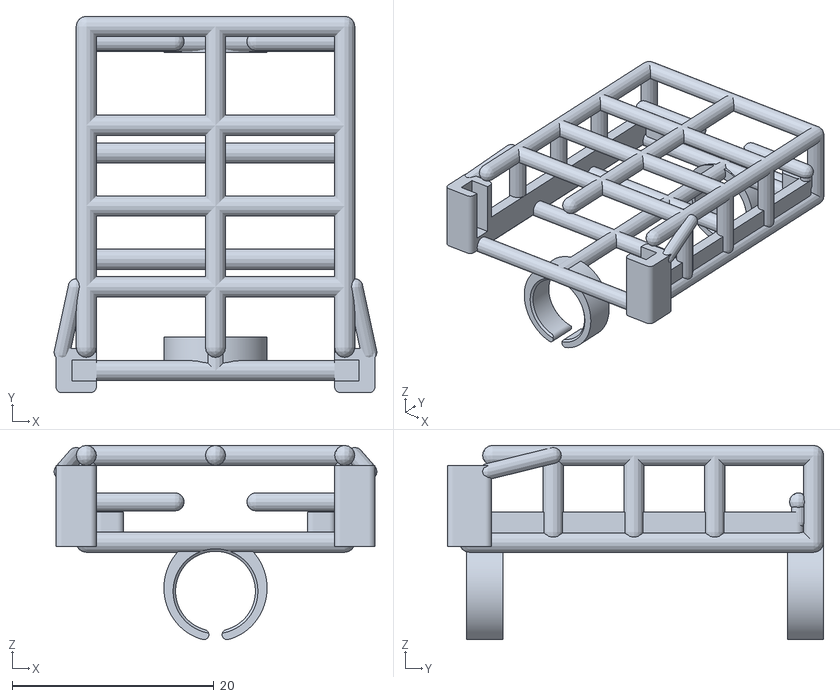
[picture p111: CAD file, 2026-11-05]
magic-wand/hardware/carbon-rod-holders-r15-tight-pyramid/exports/Battery_Holder-assembly.stl
32.0 x 37.3 x 19.2
