EthanSK/magic-wand/magic-wand/hardware/carbon-rod-holders-r15-tight-pyramid/exports/XIAO_Rod_Holder-assembly.stl

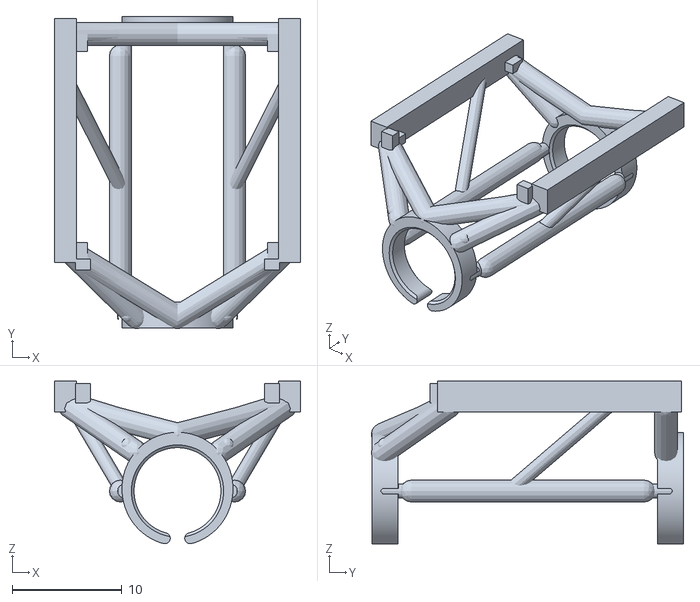
[picture p112: CAD file, 2026-11-05]
magic-wand/hardware/carbon-rod-holders-r15-tight-pyramid/exports/XIAO_Rod_Holder-assembly.stl
22.4 x 28.4 x 14.8
