EthanSK/magic-wand/magic-wand-3d-models/Print-Shard-Tube-complete.3mf

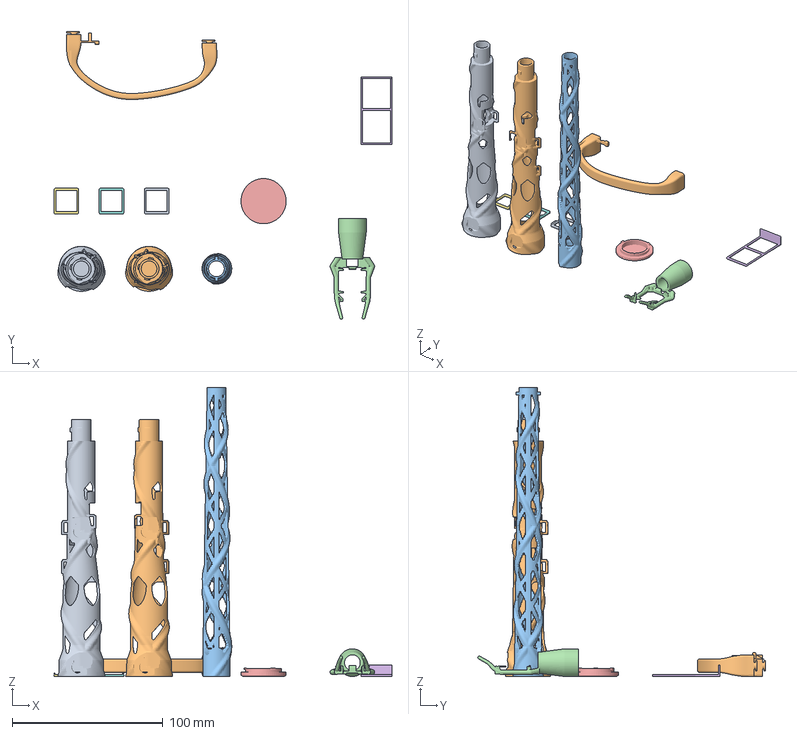
[picture p113: CAD file, 2026-10-27]
magic-wand-3d-models/Print-Shard-Tube-complete.3mf
224.5 x 191.0 x 192.0 mm
Handle_Left
Handle_Right
Continuous_Shaft
Sense_Open_Cradle
Battery_Twist_Cap
Battery_Sled
Choc_Recessed_Plate x 3
Removable_Finger_Loop
