EthanSK/magic-wand/magic-wand/hardware/carbon-rod-holders-r22-integrated-guard/exports/Battery_End_Door-assembly.stl

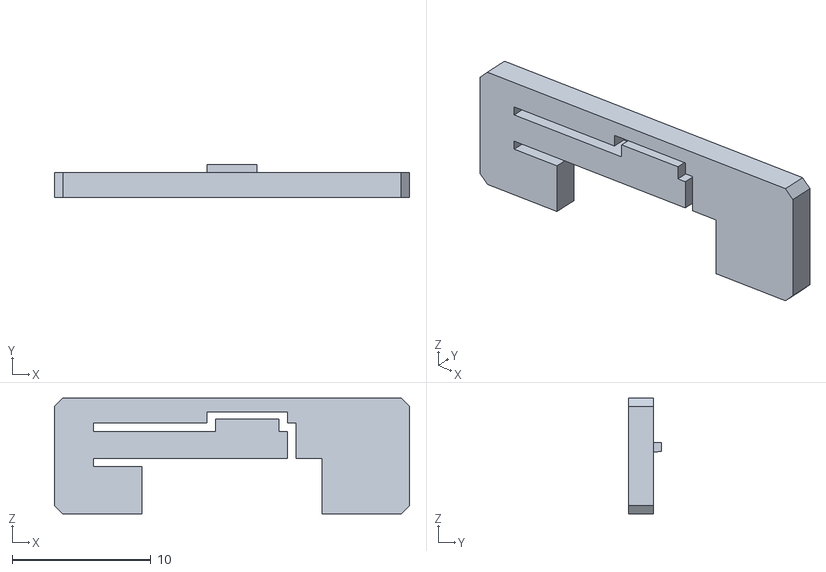
[picture p114: CAD file, 2026-11-08]
magic-wand/hardware/carbon-rod-holders-r22-integrated-guard/exports/Battery_End_Door-assembly.stl
25.6 x 2.40 x 8.35
