EthanSK/magic-wand/magic-wand/hardware/carbon-rod-holders-r22-integrated-guard/exports/Battery_Spacer_0p4mm-assembly.stl

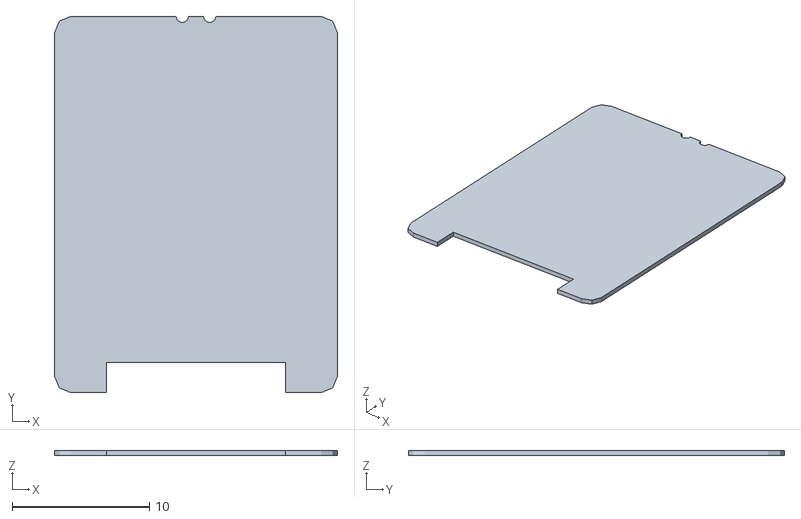
[picture p116: CAD file, 2026-11-08]
magic-wand/hardware/carbon-rod-holders-r22-integrated-guard/exports/Battery_Spacer_0p4mm-assembly.stl
20.6 x 27.4 x 0.4
