EthanSK/magic-wand/magic-wand-3d-models/Print-20-complete-left-right-solid-band-butt-grip-410mm.3mf

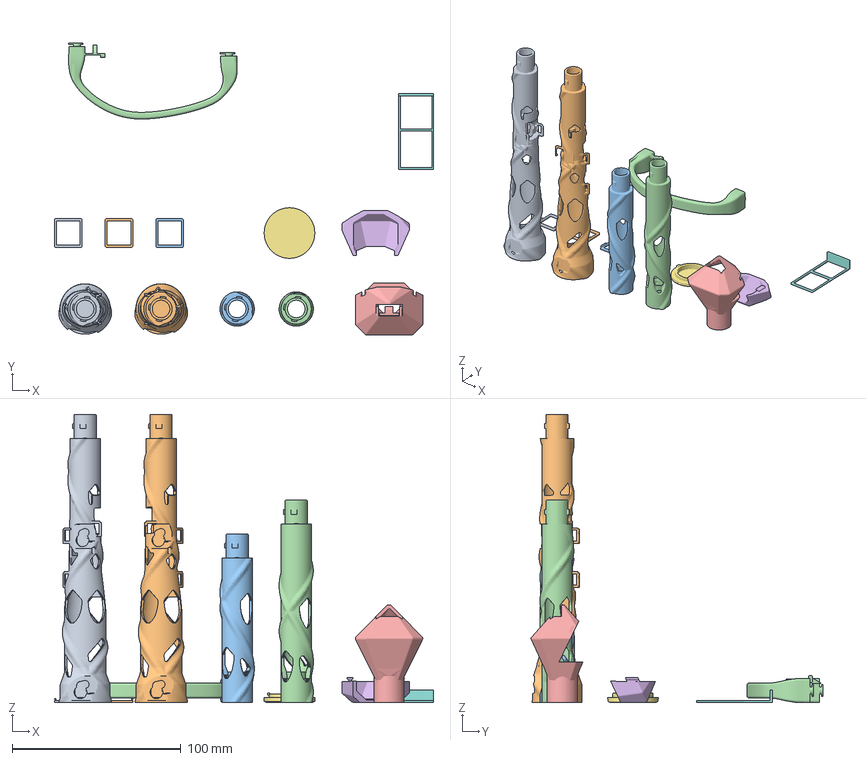
[picture p117: CAD file, 2026-10-27]
magic-wand-3d-models/Print-20-complete-left-right-solid-band-butt-grip-410mm.3mf
224.5 x 172.9 x 170.8 mm
Handle_Left
Handle_Right
Lower_Shaft
Upper_Shaft
Sense_Head_Base
Sense_Sliding_Cover
Battery_Twist_Cap
Battery_Sled
Choc_Recessed_Plate x 3
Removable_Finger_Loop
