EthanSK/magic-wand/magic-wand-3d-models/Print-Continuous-Two-Wide-V19-complete.3mf

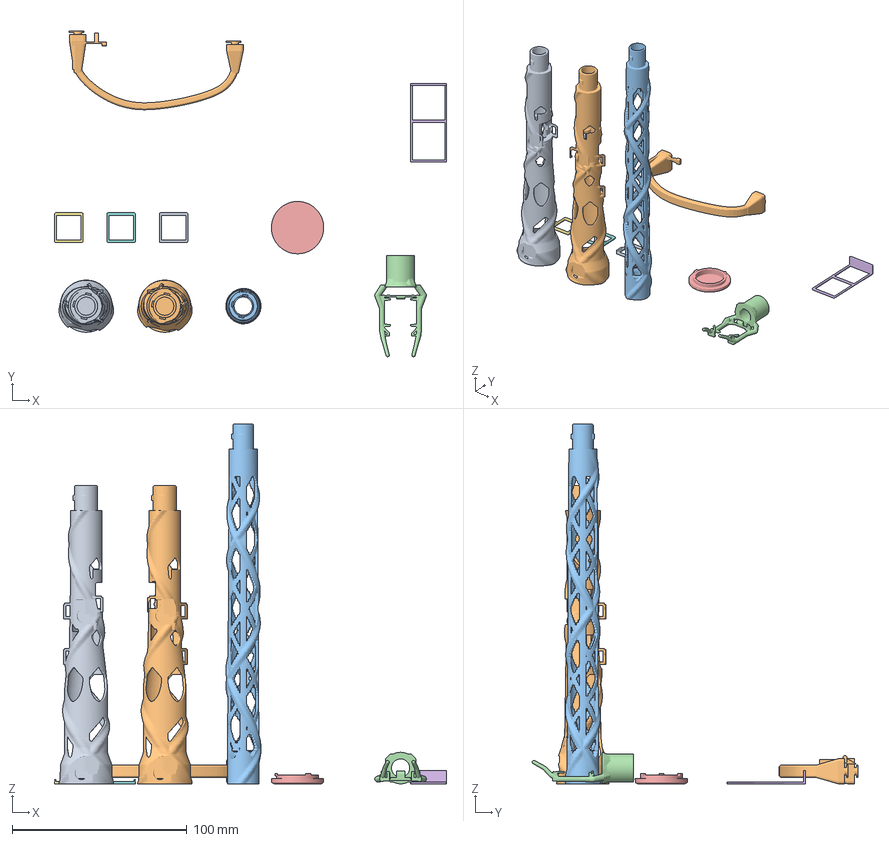
[picture p119: CAD file, 2026-10-27]
magic-wand-3d-models/Print-Continuous-Two-Wide-V19-complete.3mf
224.5 x 186.5 x 206.0 mm
Handle_Left
Handle_Right
Continuous_Shaft
Sense_Open_Cradle
Battery_Twist_Cap
Battery_Sled
Choc_Recessed_Plate x 3
Removable_Finger_Loop
