EthanSK/magic-wand/magic-wand-3d-models/Print-Lattice-two-wide-complete.3mf

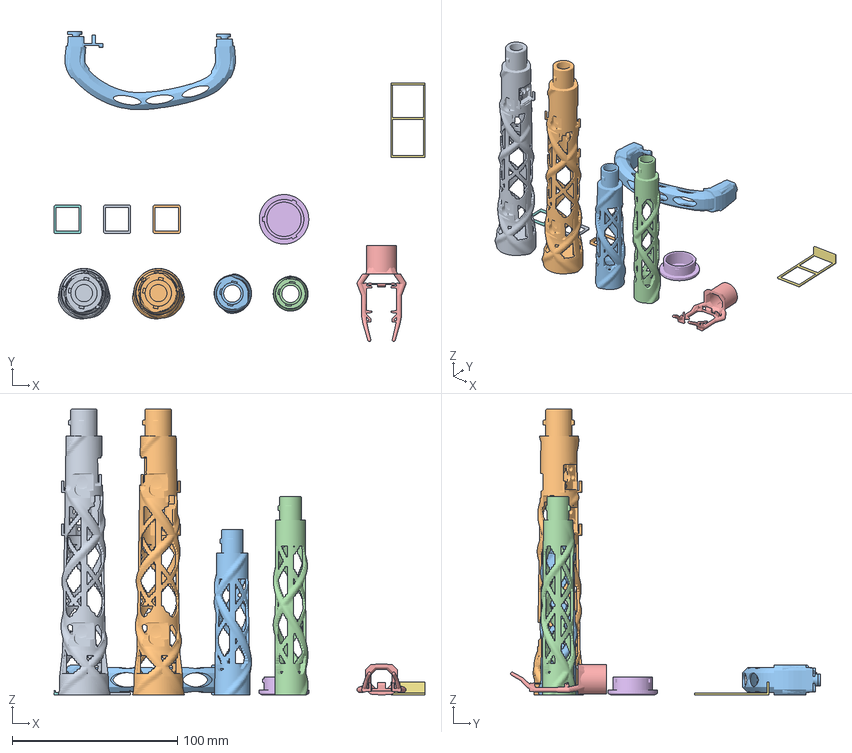
[picture p121: CAD file, 2026-10-27]
magic-wand-3d-models/Print-Lattice-two-wide-complete.3mf
224.5 x 187.7 x 172.8 mm
Handle_Left
Handle_Right
Lower_Shaft
Upper_Shaft
Sense_Open_Cradle
Battery_Twist_Cap
Battery_Sled
Choc_Recessed_Plate x 3
Removable_Finger_Loop
