EthanSK/magic-wand/magic-wand-3d-models/Print-18-complete-left-right-seated-handle-slim-grip-410mm.3mf

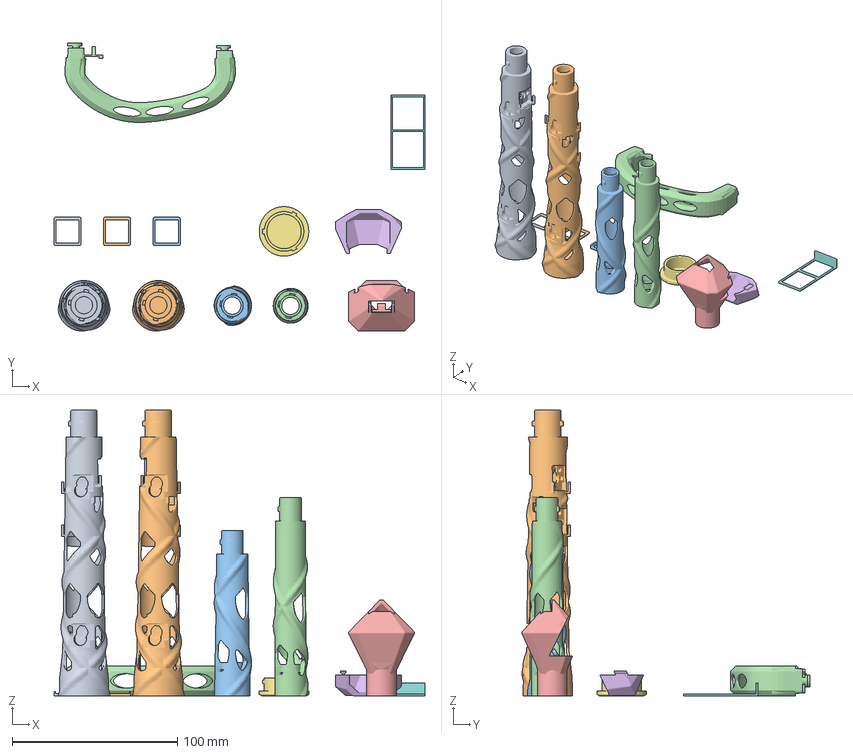
[picture p127: CAD file, 2026-10-27]
magic-wand-3d-models/Print-18-complete-left-right-seated-handle-slim-grip-410mm.3mf
224.5 x 174.5 x 172.8 mm
Handle_Left
Handle_Right
Lower_Shaft
Upper_Shaft
Sense_Head_Base
Sense_Sliding_Cover
Battery_Twist_Cap
Battery_Sled
Choc_Recessed_Plate x 3
Removable_Finger_Loop
