EthanSK/magic-wand/magic-wand-3d-models/Print-8-complete-left-right-top-slide-410mm.3mf

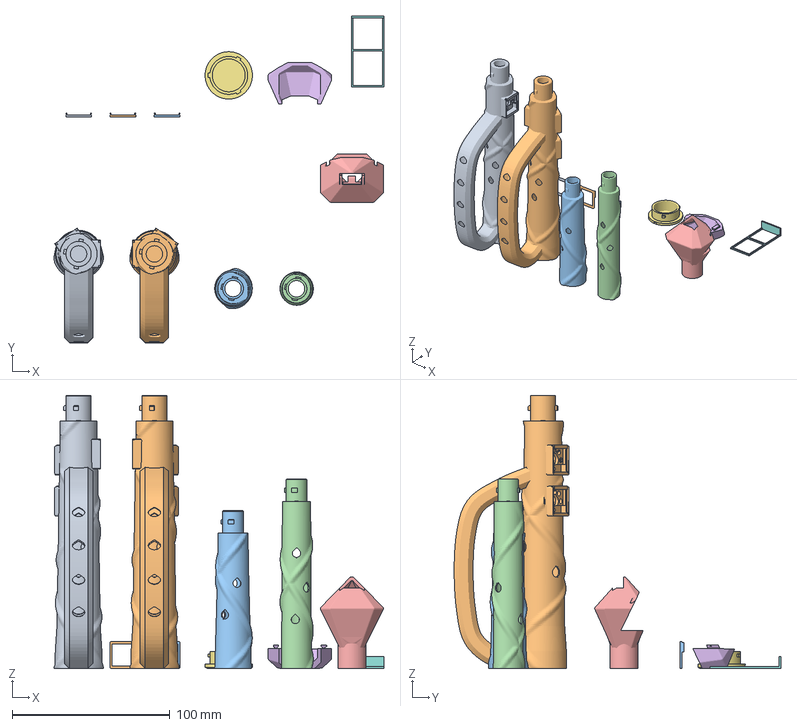
[picture p131: CAD file, 2026-10-26]
magic-wand-3d-models/Print-8-complete-left-right-top-slide-410mm.3mf
208.9 x 206.9 x 173.0 mm
Handle_Left
Handle_Right
Lower_Shaft
Upper_Shaft
Sense_Head_Base
Sense_Sliding_Cover
Battery_Twist_Cap
Battery_Sled
Choc_Top_Slide_Plate x 3
