EthanSK/magic-wand/magic-wand-3d-models/Print-6-complete-left-right-top-slide-410mm.3mf

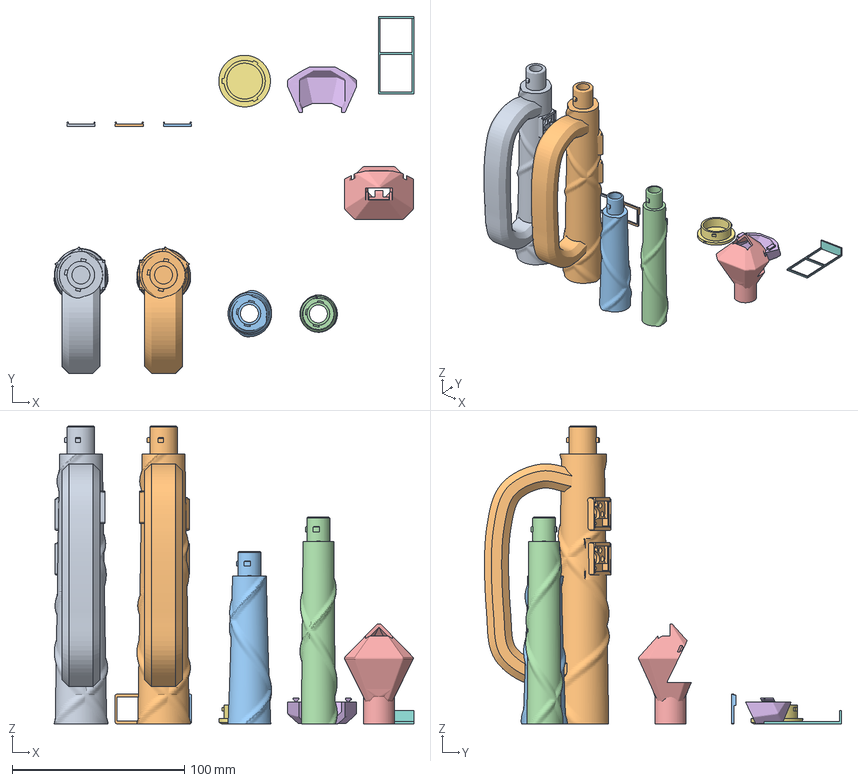
[picture p132: CAD file, 2026-10-26]
magic-wand-3d-models/Print-6-complete-left-right-top-slide-410mm.3mf
208.9 x 207.3 x 172.8 mm
Handle_Left
Handle_Right
Lower_Shaft
Upper_Shaft
Sense_Head_Base
Sense_Sliding_Cover
Battery_Twist_Cap
Battery_Sled
Choc_Top_Slide_Plate x 3
