EthanSK/magic-wand/magic-wand-3d-models/Print-3-full-left-raised-buttons-410mm.3mf

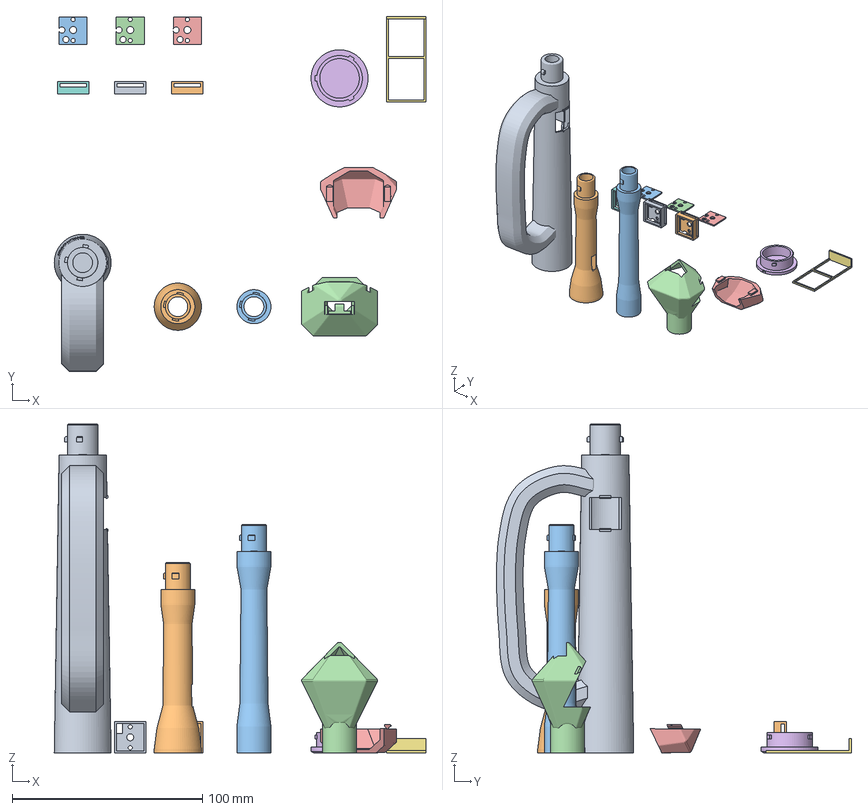
[picture p133: CAD file, 2026-10-26]
magic-wand-3d-models/Print-3-full-left-raised-buttons-410mm.3mf
195.2 x 186.6 x 172.8 mm
Handle_Left
Lower_Shaft
Upper_Shaft
Sense_Head_Base
Sense_Sliding_Cover
Battery_Twist_Cap
Battery_Sled
Choc_Socket_Carrier x 3
Choc_Socket_Keeper x 3
