EthanSK/magic-wand/control-stones/design/v2/exports/Handheld_Left_3Button/Under_Switch_Assumed.stl

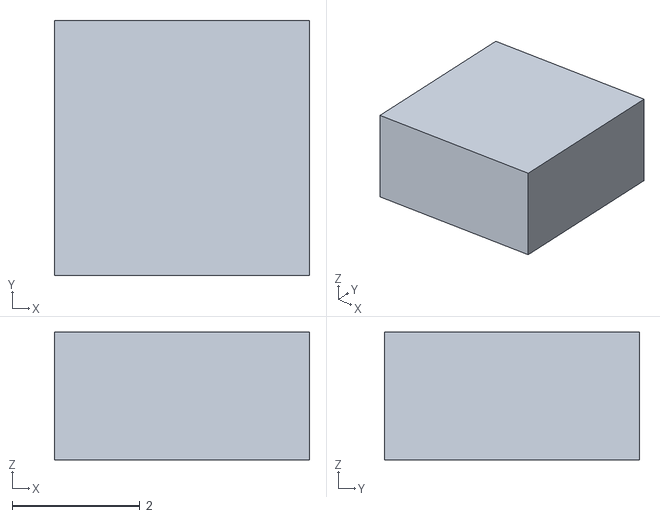
[picture p134: CAD file, 2026-11-02]
control-stones/design/v2/exports/Handheld_Left_3Button/Under_Switch_Assumed.stl
4.00 x 4.00 x 2.00
