EthanSK/magic-wand/control-stones/design/v2/exports/Handheld_Left_4Button/Under_1_Cap.stl

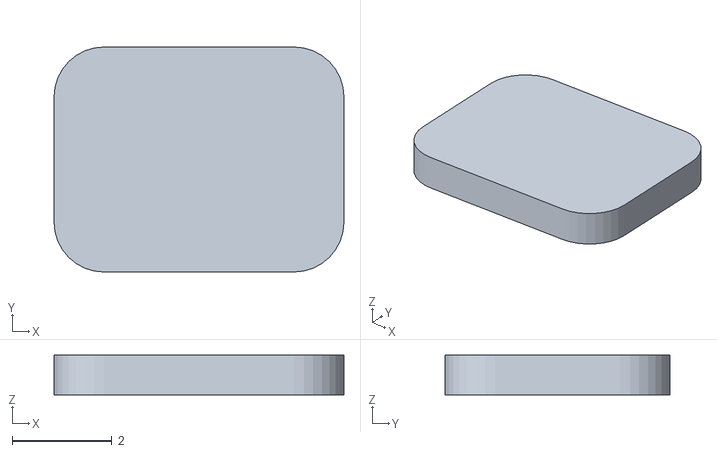
[picture p135: CAD file, 2026-11-02]
control-stones/design/v2/exports/Handheld_Left_4Button/Under_1_Cap.stl
5.80 x 4.50 x 0.8
