EthanSK/magic-wand/control-stones/design/v2/exports/Handheld_Right_3Button/Lift_Off_Lid.stl

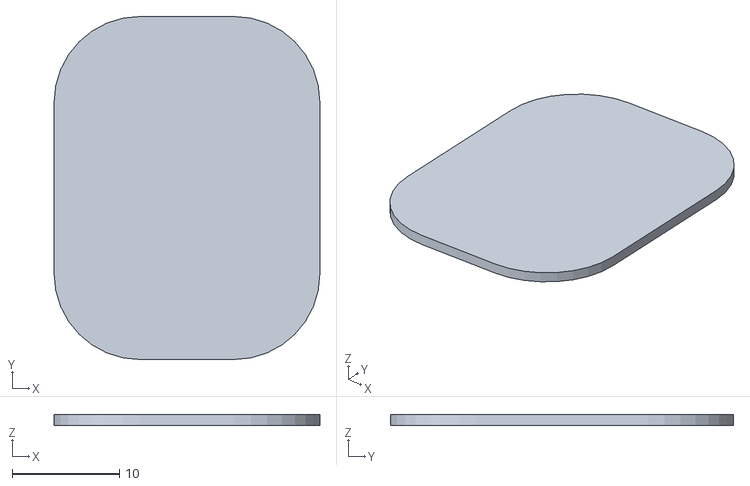
[picture p136: CAD file, 2026-11-02]
control-stones/design/v2/exports/Handheld_Right_3Button/Lift_Off_Lid.stl
24.8 x 32.0 x 1.00
