EthanSK/magic-wand/control-stones/design/v2/exports/Left_3Button/Band_Pod.stl

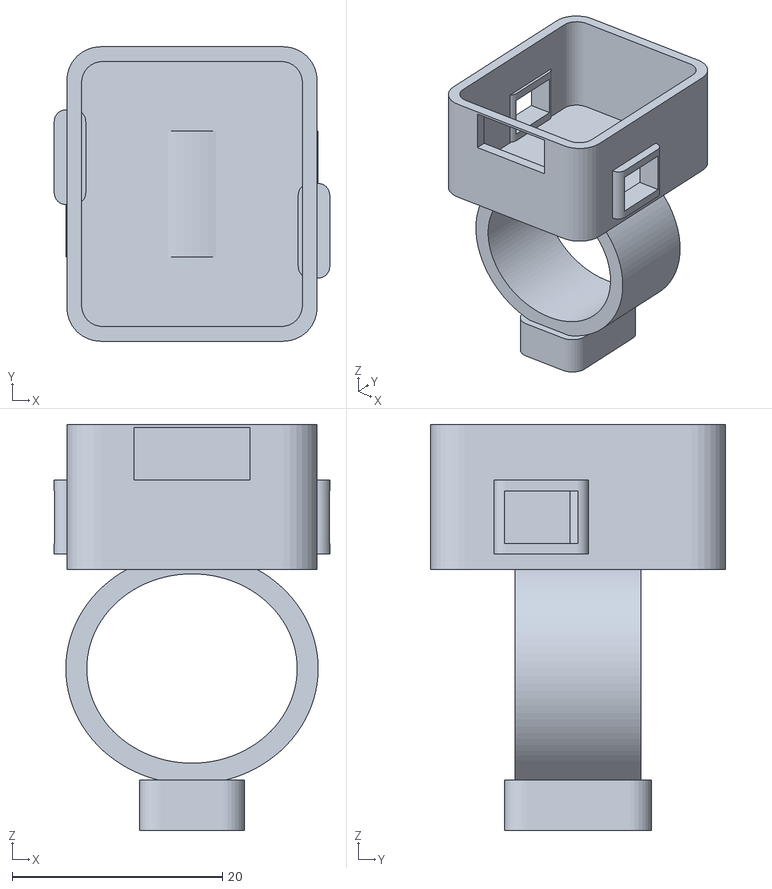
[picture p137: CAD file, 2026-11-02]
control-stones/design/v2/exports/Left_3Button/Band_Pod.stl
26.2 x 28.0 x 38.6
