EthanSK/magic-wand/control-stones/design/v2/exports/Left_4Button/Lift_Off_Lid.stl

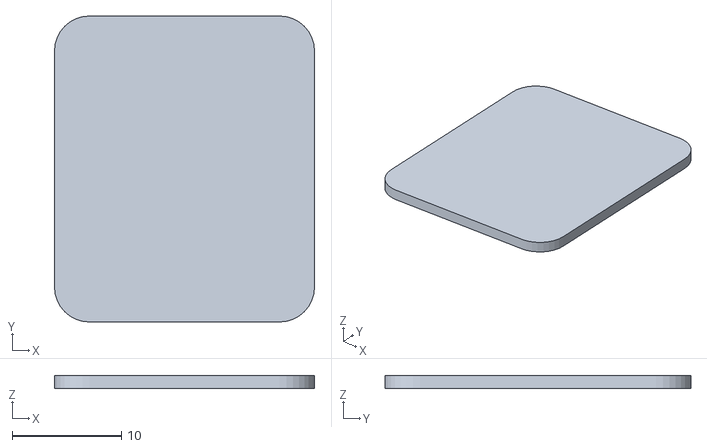
[picture p138: CAD file, 2026-11-02]
control-stones/design/v2/exports/Left_4Button/Lift_Off_Lid.stl
23.8 x 28.0 x 1.20
