EthanSK/magic-wand/control-stones/design/v2/exports/Right_3Button_CONCEPT.3mf

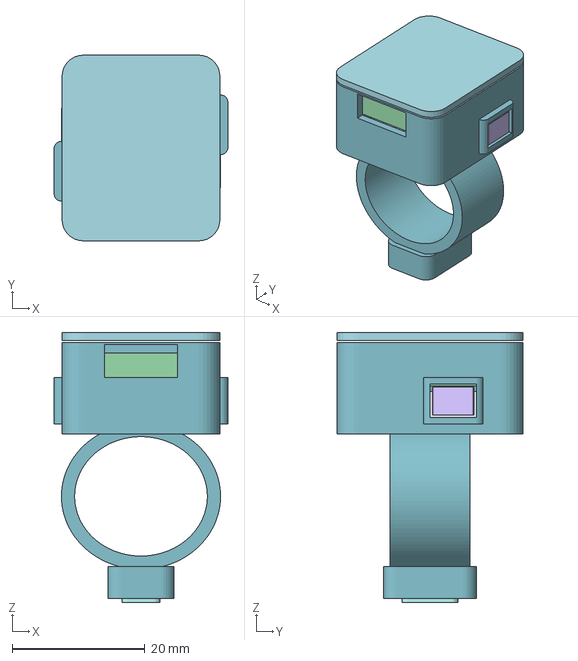
[picture p139: CAD file, 2026-11-02]
control-stones/design/v2/exports/Right_3Button_CONCEPT.3mf
26.2 x 28.0 x 40.7 mm
