EthanSK/magic-wand/magic-wand-3d-models/Slim-Loop-slim-one-left-light.3mf

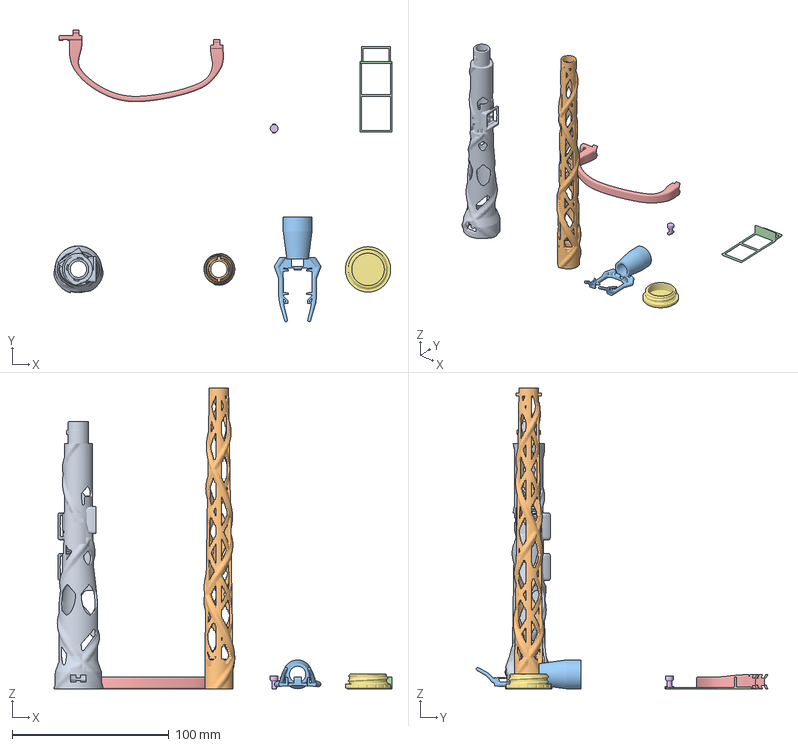
[picture p140: CAD file, 2026-10-28]
magic-wand-3d-models/Slim-Loop-slim-one-left-light.3mf
215.9 x 186.3 x 192.0 mm
Grip_Left
Continuous_Shaft
Sense_Open_Cradle
Battery_Sled
Removable_Finger_Loop
Loop_Keeper_Key
Battery_Screw_Cap_Light
