EthanSK/magic-wand/magic-wand/hardware/carbon-rod-holders-r12-closer-thumb/exports/fit-coupons/Battery-Gate-easier-fit.stl

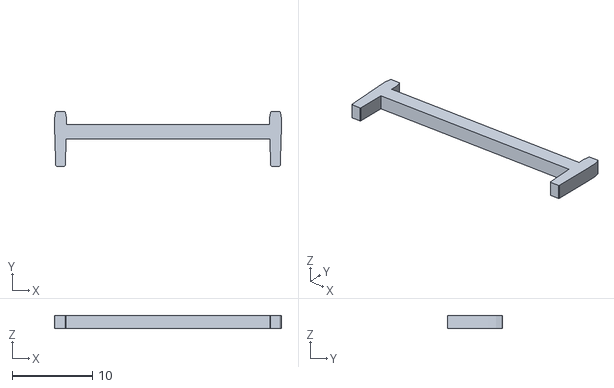
[picture p141: CAD file, 2026-11-02]
magic-wand/hardware/carbon-rod-holders-r12-closer-thumb/exports/fit-coupons/Battery-Gate-easier-fit.stl
28.3 x 6.80 x 1.60
