EthanSK/magic-wand/magic-wand/hardware/carbon-rod-holders-r12-closer-thumb/exports/Holder-modular-layout.3mf

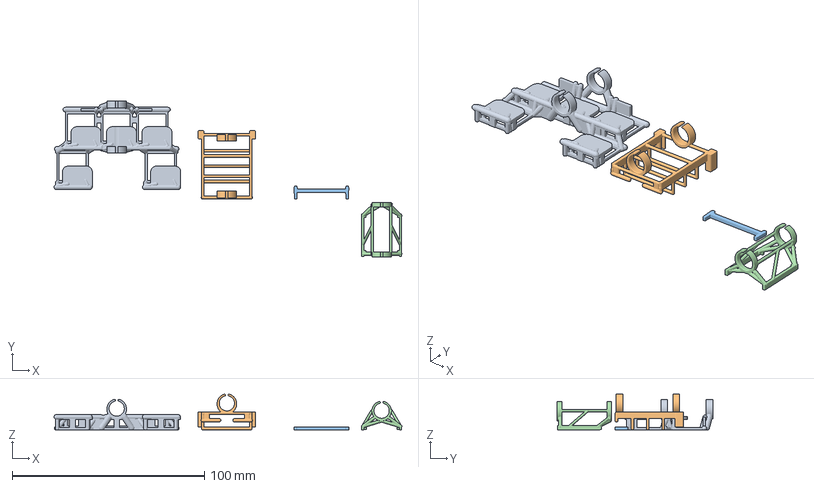
[picture p142: CAD file, 2026-11-02]
magic-wand/hardware/carbon-rod-holders-r12-closer-thumb/exports/Holder-modular-layout.3mf
181.2 x 81.0 x 18.6 mm
Key_Carrier
Battery_Holder
Battery_End_Gate
XIAO_Rod_Holder
