EthanSK/magic-wand/magic-wand/hardware/carbon-rod-holders-r13-printability/exports/Holder-R13-layout.3mf

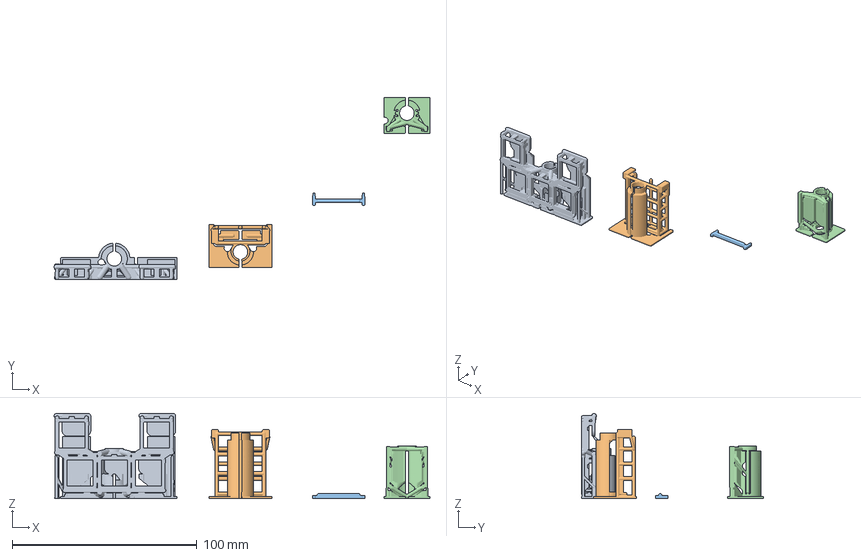
[picture p143: CAD file, 2026-11-05]
magic-wand/hardware/carbon-rod-holders-r13-printability/exports/Holder-R13-layout.3mf
203.7 x 98.7 x 46.0 mm
Key_Carrier
Battery_Holder
Battery_End_Gate
XIAO_Rod_Holder
