EthanSK/magic-wand/magic-wand/hardware/carbon-rod-holders-r13-printability/exports/trial-Battery_Holder-Battery_End_Gate/AFTER-KEY-TEST-Holder-R13-sliced.3mf

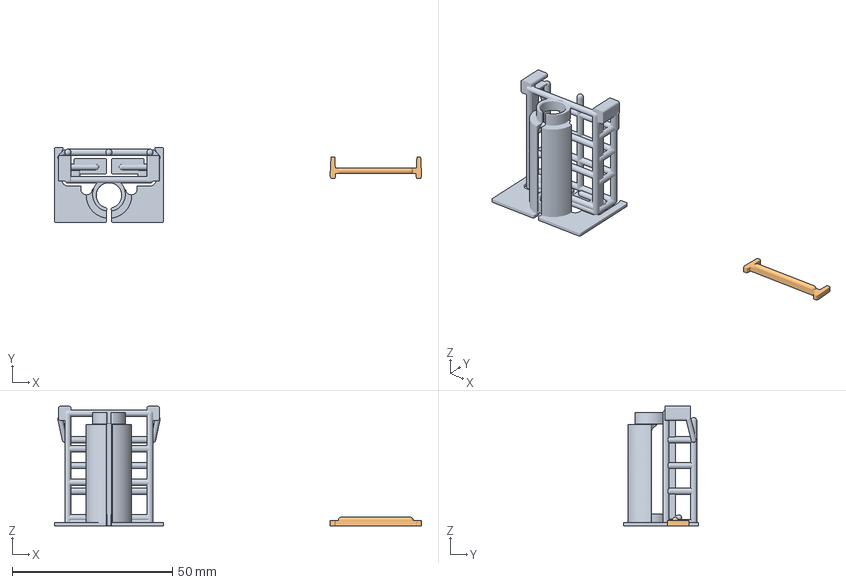
[picture p144: CAD file, 2026-11-05]
magic-wand/hardware/carbon-rod-holders-r13-printability/exports/trial-Battery_Holder-Battery_End_Gate/AFTER-KEY-TEST-Holder-R13-sliced.3mf
114.5 x 23.5 x 37.3 mm
Battery_Holder
Battery_End_Gate
