EthanSK/magic-wand/magic-wand/hardware/carbon-rod-holders-r13-printability/exports/trial-Key_Carrier/Holder-R13-layout.3mf

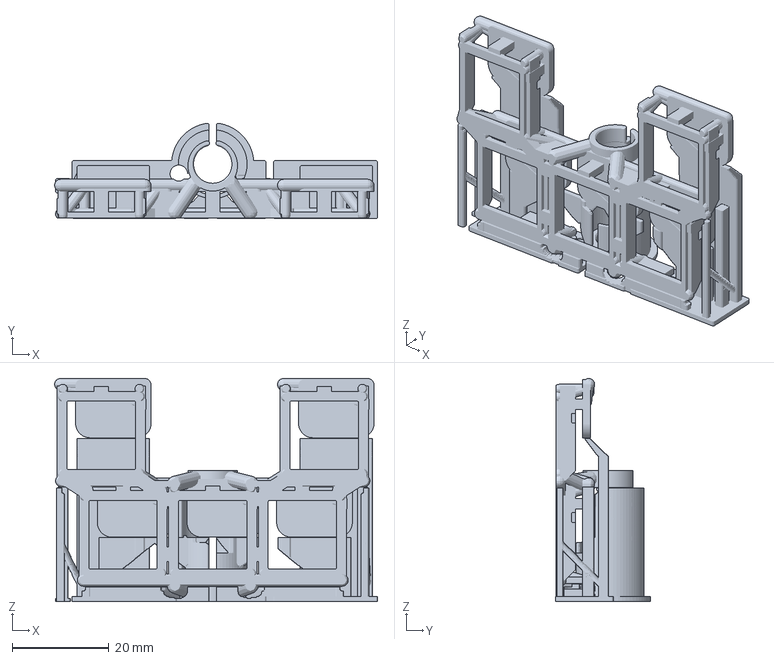
[picture p145: CAD file, 2026-11-05]
magic-wand/hardware/carbon-rod-holders-r13-printability/exports/trial-Key_Carrier/Holder-R13-layout.3mf
66.7 x 19.7 x 46.0 mm
