EthanSK/magic-wand/magic-wand/hardware/carbon-rod-holders-r13-printability/exports/trial-XIAO_Rod_Holder/AFTER-KEY-TEST-Holder-R13-sliced.3mf

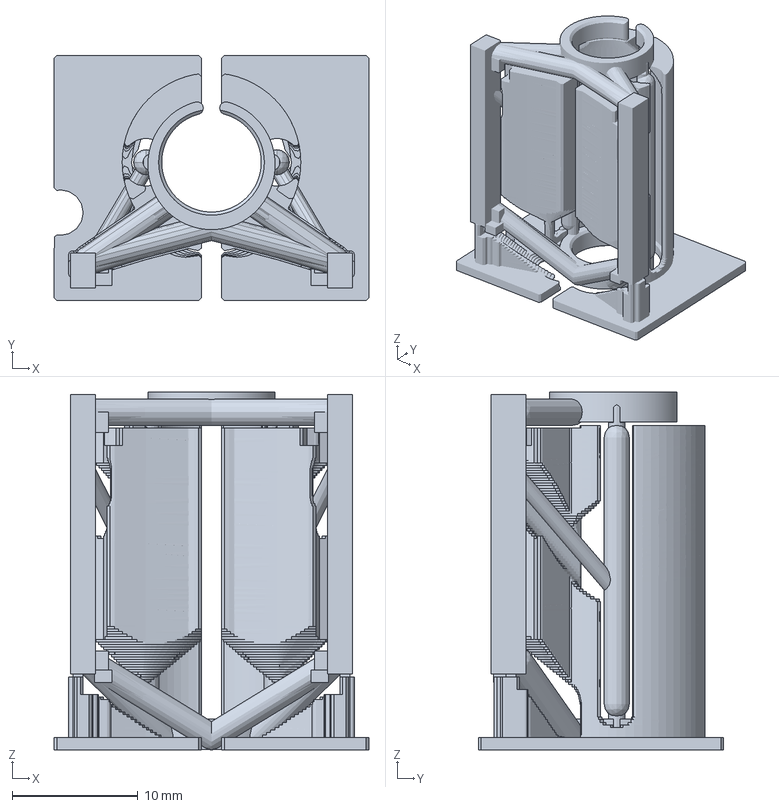
[picture p146: CAD file, 2026-11-05]
magic-wand/hardware/carbon-rod-holders-r13-printability/exports/trial-XIAO_Rod_Holder/AFTER-KEY-TEST-Holder-R13-sliced.3mf
25.0 x 19.5 x 28.5 mm
