EthanSK/magic-wand/magic-wand/hardware/carbon-rod-holders-r15-tight-pyramid/exports/Holder-R15-layout.3mf

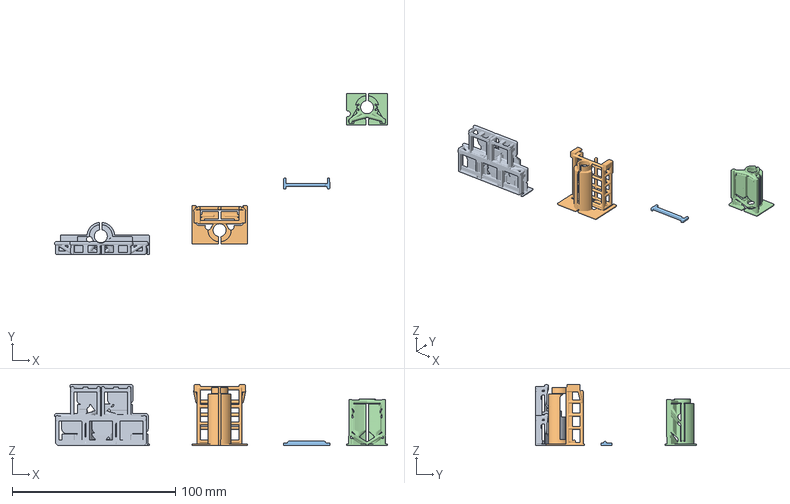
[picture p147: CAD file, 2026-11-06]
magic-wand/hardware/carbon-rod-holders-r15-tight-pyramid/exports/Holder-R15-layout.3mf
203.7 x 98.7 x 37.5 mm
Key_Carrier
Battery_Holder
Battery_End_Gate
XIAO_Rod_Holder
