EthanSK/magic-wand/magic-wand/hardware/carbon-rod-holders-r17-anchored-repair/exports/Battery_End_Gate-ANCHOR-REMOVE-AFTER-PRINT.stl

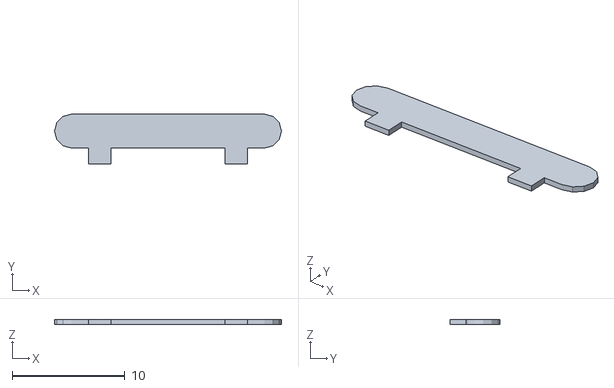
[picture p148: CAD file, 2026-11-08]
magic-wand/hardware/carbon-rod-holders-r17-anchored-repair/exports/Battery_End_Gate-ANCHOR-REMOVE-AFTER-PRINT.stl
20.1 x 4.40 x 0.4
