EthanSK/magic-wand/magic-wand/hardware/carbon-rod-holders-r18-easy-release/exports/Battery_Holder-ANCHOR-REMOVE-AFTER-PRINT.stl

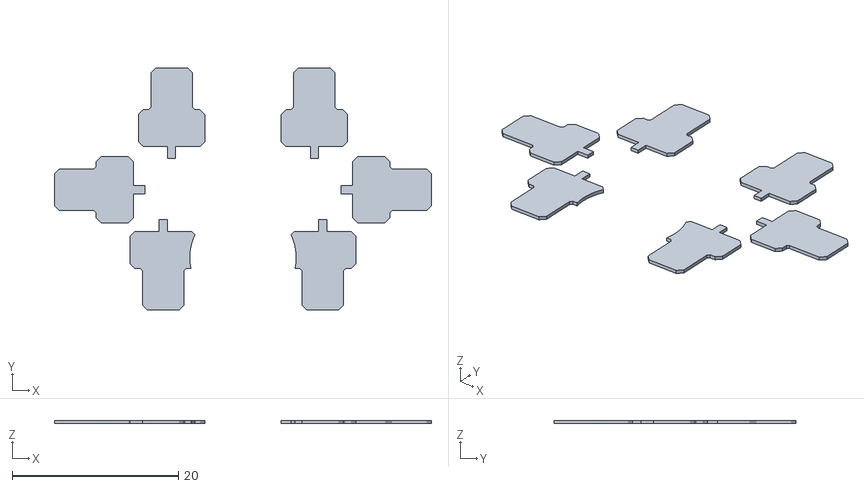
[picture p149: CAD file, 2026-11-08]
magic-wand/hardware/carbon-rod-holders-r18-easy-release/exports/Battery_Holder-ANCHOR-REMOVE-AFTER-PRINT.stl
45.4 x 29.2 x 0.4
