EthanSK/magic-wand/magic-wand/hardware/carbon-rod-holders-r19-lightweight/exports/R19-A1-mini-PETG.gcode.3mf

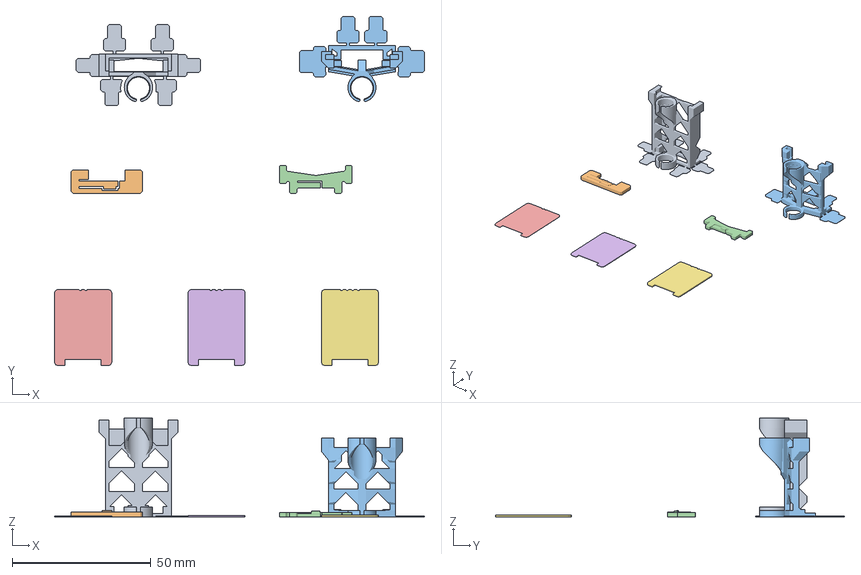
[picture p150: CAD file, 2026-11-09]
magic-wand/hardware/carbon-rod-holders-r19-lightweight/exports/R19-A1-mini-PETG.gcode.3mf
133.1 x 125.6 x 35.6 mm
Battery_Holder
Battery_End_Door
XIAO_Rod_Holder
XIAO_Near_Keeper
Battery_Spacer_0p4mm
Battery_Spacer_0p6mm
Battery_Spacer_0p8mm
