EthanSK/magic-wand/magic-wand/hardware/carbon-rod-holders-r21-cable-clip/exports/Cable_Clip_4mm-ANCHOR-REMOVE-AFTER-PRINT.stl

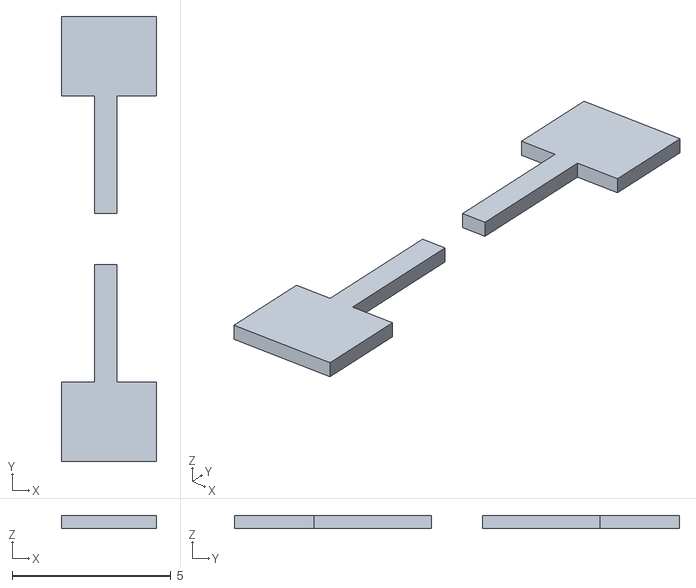
[picture p151: CAD file, 2026-11-10]
magic-wand/hardware/carbon-rod-holders-r21-cable-clip/exports/Cable_Clip_4mm-ANCHOR-REMOVE-AFTER-PRINT.stl
3.00 x 14.0 x 0.4
