EthanSK/magic-wand/magic-wand/hardware/carbon-rod-holders-r22-integrated-guard/exports/guide/latch_cut_holder_centre.stl

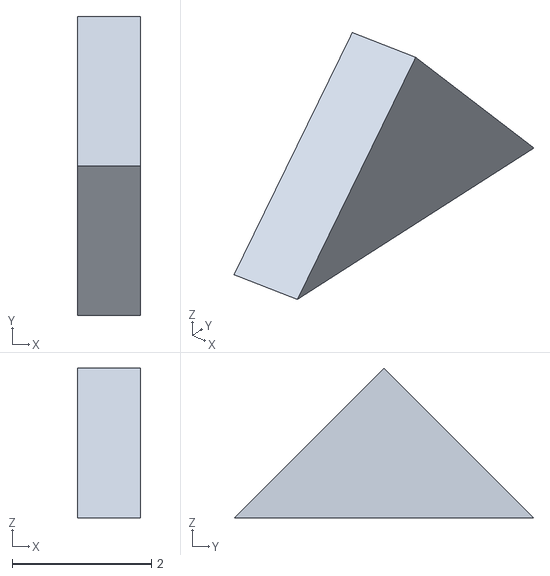
[picture p152: CAD file, 2026-11-10]
magic-wand/hardware/carbon-rod-holders-r22-integrated-guard/exports/guide/latch_cut_holder_centre.stl
0.9 x 4.30 x 2.15
