EthanSK/magic-wand/magic-wand/hardware/carbon-rod-holders-r23-hybrid-centre/exports/guide/xiao_charge_led.stl

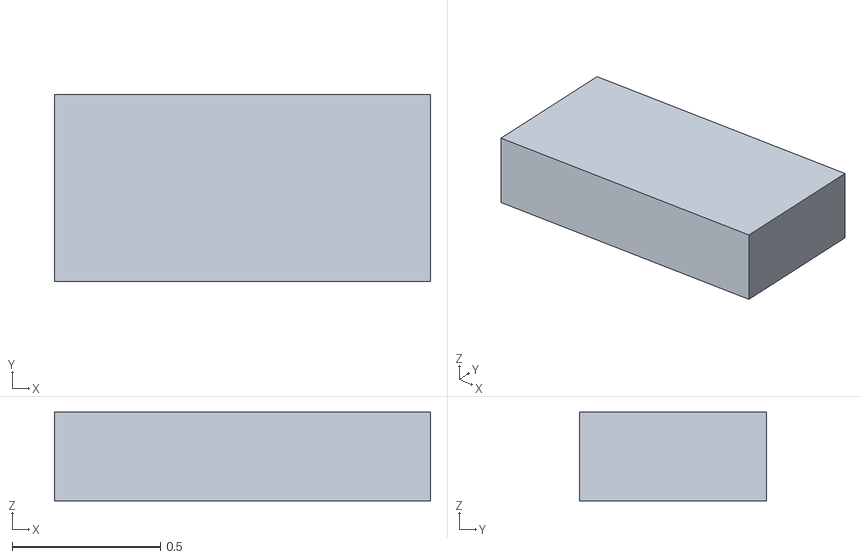
[picture p153: CAD file, 2026-11-10]
magic-wand/hardware/carbon-rod-holders-r23-hybrid-centre/exports/guide/xiao_charge_led.stl
1.27 x 0.63 x 0.3
