EthanSK/magic-wand/magic-wand/hardware/carbon-rod-holders-r24-patterned-spacer/exports/guide/battery_negative_lead.stl

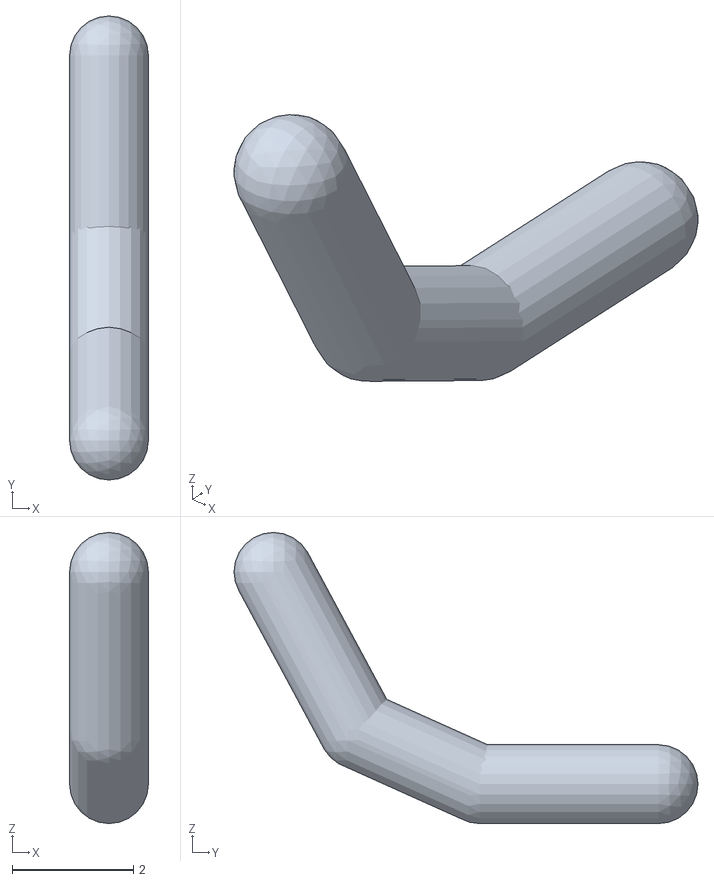
[picture p154: CAD file, 2026-11-10]
magic-wand/hardware/carbon-rod-holders-r24-patterned-spacer/exports/guide/battery_negative_lead.stl
1.30 x 7.65 x 4.80
