EthanSK/magic-wand/(list of files, cad)

Other CAD files:
magic-wand/hardware/carbon-rod-holders-r34-straight-op1/exports/R34-Complete-A1-mini-PETG-layout.3mf
magic-wand/hardware/carbon-rod-holders-r37-adjustable-op1/exports/R37-Complete-A1-mini-PETG-layout.3mf
magic-wand/hardware/carbon-rod-holders-r33-crosswise-guards/exports/R33-Complete-A1-mini-PETG-layout.3mf
magic-wand/hardware/carbon-rod-holders-r38-centred-op1/exports/standard-retry/R38-Complete-A1-mini-PETG.gcode.3mf
magic-wand/hardware/carbon-rod-holders-r32-complete-assembly/exports/R32-Complete-A1-mini-PETG.gcode.3mf
magic-wand/hardware/carbon-rod-holders-r33-crosswise-guards/exports/R33-Complete-A1-mini-PETG.gcode.3mf
magic-wand/hardware/carbon-rod-holders-r6-three-key/exports/XIAO_Rod_Holder-assembly.stl
magic-wand/hardware/carbon-rod-holders-r20-finger-guard/exports/Key_Carrier-assembly.stl
magic-wand/hardware/carbon-rod-holders-r23-hybrid-centre/exports/Centre_Paddle-assembly.stl
magic-wand/hardware/carbon-rod-holders-r32-complete-assembly/exports/Key_Carrier-assembly.stl
magic-wand/hardware/carbon-rod-holders-r33-crosswise-guards/exports/DFRobot_Hole_Bracket-assembly.stl
magic-wand/hardware/carbon-rod-holders-r36-grove-touch/exports/R36-Complete-A1-mini-PETG-layout.3mf
magic-wand-3d-models/Slim-Loop-petal-complete-both-hands.3mf
magic-wand/hardware/carbon-rod-holders-r12-closer-thumb/exports/XIAO_Rod_Holder-assembly.stl
magic-wand/hardware/carbon-rod-holders-r22-integrated-guard/exports/Battery_Holder-assembly.stl
magic-wand/hardware/carbon-rod-holders-r34-straight-op1/exports/Key_Carrier-assembly.stl
magic-wand/hardware/carbon-rod-holders-r35-backed-roots/exports/R35-Complete-A1-mini-PETG-layout.3mf
magic-wand-3d-models/Slim-Loop-leaf-complete-both-hands.3mf
magic-wand/hardware/carbon-rod-holders-r32-complete-assembly/exports/DFRobot_Hole_Bracket-assembly.stl
magic-wand/hardware/carbon-rod-holders-r34-straight-op1/exports/R34-Complete-A1-mini-PETG.gcode.3mf
magic-wand/hardware/carbon-rod-holders-r35-backed-roots/exports/Key_Carrier-assembly.stl
magic-wand/hardware/carbon-rod-holders-r36-grove-touch/exports/Key_Carrier-assembly.stl
magic-wand/hardware/carbon-rod-holders-r23-hybrid-centre/exports/Centre_Paddle_Shallow_Trial-assembly.stl
magic-wand/hardware/carbon-rod-holders-r17-anchored-repair/exports/Battery_End_Gate-assembly.stl
magic-wand-3d-models/Print-Shard-R2-complete-both-hands.3mf
magic-wand/hardware/carbon-rod-holders-r22-integrated-guard/exports/XIAO_Rod_Holder-assembly.stl
magic-wand/hardware/carbon-rod-holders-r22-integrated-guard/exports/XIAO_Near_Keeper-assembly.stl
magic-wand-3d-models/Print-Lattice-one-wide-complete.3mf
magic-wand-3d-models/Print-15-complete-left-right-top-slide-410mm.3mf
magic-wand-3d-models/Print-14-complete-left-right-top-slide-410mm.3mf
magic-wand-3d-models/Print-13-complete-left-right-top-slide-410mm.3mf
magic-wand-3d-models/Print-12-complete-left-right-top-slide-410mm.3mf
magic-wand-3d-models/Print-11-complete-left-right-top-slide-410mm.3mf
magic-wand-3d-models/Print-7-complete-left-right-top-slide-410mm.3mf
magic-wand-3d-models/Print-5-complete-left-right-top-slide-410mm.3mf
magic-wand-3d-models/Print-4-complete-left-right-helix-410mm.3mf
control-stones/design/v2/exports/Handheld_Right_4Button/Thumb_Click_Switch_Assumed.stl
control-stones/design/v2/exports/Right_3Button/Thumb_Click_Switch_Assumed.stl
control-stones/design/v2/exports/Right_4Button/Thumb_Click_Switch_Assumed.stl
magic-wand/hardware/carbon-rod-holders-r23-hybrid-centre/exports/Key_Carrier-SOURCE-REQUIRES-PREPARATION.stl
control-stones/design/v2/exports/Handheld_Left_3Button/Battery_Envelope.stl
control-stones/design/v2/exports/Handheld_Left_3Button/Board_Envelope.stl
control-stones/design/v2/exports/Handheld_Left_3Button/Far_Side_Cap.stl
control-stones/design/v2/exports/Handheld_Left_3Button/Far_Side_Switch_Assumed.stl
control-stones/design/v2/exports/Handheld_Left_3Button/Handheld_Shell.stl
control-stones/design/v2/exports/Handheld_Left_3Button/Lift_Off_Lid.stl
control-stones/design/v2/exports/Handheld_Left_3Button/Thumb_Click_Cap.stl
control-stones/design/v2/exports/Handheld_Left_3Button/Thumb_Click_Switch_Assumed.stl
control-stones/design/v2/exports/Handheld_Left_3Button/Under_Cap.stl
control-stones/design/v2/exports/Handheld_Left_3Button_CONCEPT.3mf
control-stones/design/v2/exports/Handheld_Left_4Button/Battery_Envelope.stl
control-stones/design/v2/exports/Handheld_Left_4Button/Board_Envelope.stl
control-stones/design/v2/exports/Handheld_Left_4Button/Far_Side_Cap.stl
control-stones/design/v2/exports/Handheld_Left_4Button/Far_Side_Switch_Assumed.stl
control-stones/design/v2/exports/Handheld_Left_4Button/Handheld_Shell.stl
control-stones/design/v2/exports/Handheld_Left_4Button/Lift_Off_Lid.stl
control-stones/design/v2/exports/Handheld_Left_4Button/Thumb_Click_Cap.stl
control-stones/design/v2/exports/Handheld_Left_4Button/Thumb_Click_Switch_Assumed.stl
control-stones/design/v2/exports/Handheld_Left_4Button/Under_1_Switch_Assumed.stl
control-stones/design/v2/exports/Handheld_Left_4Button/Under_2_Cap.stl
control-stones/design/v2/exports/Handheld_Left_4Button/Under_2_Switch_Assumed.stl
control-stones/design/v2/exports/Handheld_Left_4Button_CONCEPT.3mf
control-stones/design/v2/exports/Handheld_Right_3Button/Battery_Envelope.stl
control-stones/design/v2/exports/Handheld_Right_3Button/Board_Envelope.stl
control-stones/design/v2/exports/Handheld_Right_3Button/Far_Side_Cap.stl
control-stones/design/v2/exports/Handheld_Right_3Button/Far_Side_Switch_Assumed.stl
control-stones/design/v2/exports/Handheld_Right_3Button/Handheld_Shell.stl
control-stones/design/v2/exports/Handheld_Right_3Button/Thumb_Click_Cap.stl
control-stones/design/v2/exports/Handheld_Right_3Button/Thumb_Click_Switch_Assumed.stl
control-stones/design/v2/exports/Handheld_Right_3Button/Under_Cap.stl
control-stones/design/v2/exports/Handheld_Right_3Button/Under_Switch_Assumed.stl
control-stones/design/v2/exports/Handheld_Right_3Button_CONCEPT.3mf
control-stones/design/v2/exports/Handheld_Right_4Button/Battery_Envelope.stl
control-stones/design/v2/exports/Handheld_Right_4Button/Board_Envelope.stl
control-stones/design/v2/exports/Handheld_Right_4Button/Far_Side_Cap.stl
control-stones/design/v2/exports/Handheld_Right_4Button/Far_Side_Switch_Assumed.stl
control-stones/design/v2/exports/Handheld_Right_4Button/Handheld_Shell.stl
control-stones/design/v2/exports/Handheld_Right_4Button/Thumb_Click_Cap.stl
control-stones/design/v2/exports/Handheld_Right_4Button/Under_1_Cap.stl
control-stones/design/v2/exports/Handheld_Right_4Button/Under_1_Switch_Assumed.stl
control-stones/design/v2/exports/Handheld_Right_4Button/Under_2_Cap.stl
control-stones/design/v2/exports/Handheld_Right_4Button/Under_2_Switch_Assumed.stl
control-stones/design/v2/exports/Handheld_Right_4Button_CONCEPT.3mf
control-stones/design/v2/exports/Left_3Button/Battery_Envelope.stl
control-stones/design/v2/exports/Left_3Button/Board_Envelope.stl
control-stones/design/v2/exports/Left_3Button/Far_Side_Cap.stl
control-stones/design/v2/exports/Left_3Button/Far_Side_Switch_Assumed.stl
control-stones/design/v2/exports/Left_3Button/Thumb_Click_Cap.stl
control-stones/design/v2/exports/Left_3Button/Thumb_Click_Switch_Assumed.stl
control-stones/design/v2/exports/Left_3Button/Under_Cap.stl
control-stones/design/v2/exports/Left_3Button/Under_Switch_Assumed.stl
control-stones/design/v2/exports/Left_3Button_CONCEPT.3mf
control-stones/design/v2/exports/Left_4Button/Band_Pod.stl
control-stones/design/v2/exports/Left_4Button/Battery_Envelope.stl
control-stones/design/v2/exports/Left_4Button/Board_Envelope.stl
control-stones/design/v2/exports/Left_4Button/Far_Side_Cap.stl
control-stones/design/v2/exports/Left_4Button/Far_Side_Switch_Assumed.stl
control-stones/design/v2/exports/Left_4Button/Thumb_Click_Cap.stl
control-stones/design/v2/exports/Left_4Button/Thumb_Click_Switch_Assumed.stl
control-stones/design/v2/exports/Left_4Button/Under_1_Cap.stl
control-stones/design/v2/exports/Left_4Button/Under_1_Switch_Assumed.stl
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
