EthanSK/magic-wand/magic-wand/hardware/printed-loop-wand/README.md

# Printed loop wand

Latest main-branch candidate: [Shard Tube R2 — repaired handle, integral switch seats and open bottom-loading battery](shard-tube-r2/README.md), with [interactive CAD preview](shard-tube-r2/preview/). Both handed grips, small fit tests and light/heavier screw-cap options are included. The butt reference, button offsets, helix, shaft and open cradle are retained. Printed fit and actual cell dimensions remain unverified. Earlier numbered designs and the separate V20 snapshot remain unchanged.

Ready-to-open Bambu projects are in [Magic Wand 3D models](../../../magic-wand-3d-models/).
Their freshness and archive privacy checks run with the repository tests.
When served locally, the preview checks for new exports every two seconds and reloads changed
models while retaining the camera, viewing mode and joint settings. A held pointer drag finishes
before an update is applied.

## Tapered double-helix version

Choose **Tapered wand (XIAO)** in the preview for the continuous wand shape. The straight version
has no loop or separate handle bulge: the body tapers from 30 mm at the butt to 14.6 mm before the XIAO tip.
Two rounded, 1.2 mm raised ribs wind in opposite directions at 90 mm and 72 mm pitch.
Ethan preferred this earlier pattern to the tighter 90/36 mm experiment. The tighter
strand makes 25% more turns, so the crossings rotate around the shaft instead
of repeating equal diamonds in one plane. Ethan calls this the "criss-cross" or "like DNA"
shape and asked for "one goes faster than the other". **Smooth** uses the same body
and joints without the ribs, for comparison. The earlier loop and plain grips remain available.

**Mug handle** adds the full-hand oval loop to this same spiral grip, button platform,
wire path and twist-lock. Both current handles use the same tapered shaft parts; the old
non-tapered mug handle uses a different joint and must not be mixed into this set.
The viewer's **Both** choice shows the two spiral wands together; Smooth stays available separately.
The combined [two-wand Bambu project](../../../magic-wand-3d-models/two-spiral-wands.3mf)
contains eight pieces on one plate: two handles, four shaft sections and two XIAO holders.

The blank button platform spans 54 mm across the top, with 14 mm wings on both sides and a
continuous flat centre. Its mounting area is 30 mm long along the wand and 4 mm thick.
Both the spiral and smooth variants use this platform. Actual button dimensions are still
needed before adding mounting holes. The wire path exits through the centre of the platform.

This version uses its own matching handle and shaft pieces: its twist-lock is reversed for
upright printing and does not interchange directly with the earlier handles. Use
`coupon-tapered-male` and `coupon-tapered-female` for its fit test. The two shaft sections use
a keyed glue joint; the existing XIAO holder joins at the tip. Nothing has been physically fitted.

Both variants use P1S 0.4 mm, Generic PETG, 0.28 mm Extra Draft, two walls, 20% infill, tree support
and 4 mm brim settings. The generated [print manifest](../../../magic-wand-3d-models/manifest.json)
records their current local slicer time and material estimates, not measured print times.
All parts fit one plate. Remove support fully and check the joint coupons before a full wand. Upright printing
and the shelf's strength still need physical testing.

A fully printed body for the three-button wand: interchangeable handles that plug onto one shared
shaft with a push-and-twist lock.

**Current profile: XIAO tip.** The wand now carries a Seeed XIAO board instead of the Puck.js, so
the current set is the open XIAO deck (`tip-xiao`) with two handles side by side:

- **Mug handle**: `handle-oval`, the full-hand loop. Its opening is 101 × 31 mm, measured from the
  model and intended for a four-finger grip. Check the actual hand fit before printing a full wand.
- **Plain handle (no loop)**: `handle-straight`, the rounded grip with no loop.

Both use the same shafts, joint and wire route. The current set has no button pod (the orange
block in earlier previews) and no battery holder. The Puck.js cradle, cap, button pods and the
small round and angled loops stay available as the **Puck.js tip (legacy)** profile; none of their files
changed. There is no battery holder anywhere; the battery is taped on for this prototype.

**Status: first print set, not yet printed.** The model geometry is generated and checked
(closed solids, fit on the bed, no unintended collisions, joint keyed and retained in the model).
Printed fit, strength, comfort, balance and mass are not measured. Every clearance here is a
starting value for PETG on one printer profile, not a tolerance that works everywhere.

This is a mechanical body only. It is not a new controls version or prototype profile; the
existing three buttons and their roles are unchanged.

## What's here

| File | Purpose |
| --- | --- |
| `dimensions.json` | Every editable dimension (mm). Change values here, then rebuild. |
| `wand_cad.py` | The one parametric geometry source. Builds, exports and checks everything. |
| `requirements.txt` | Pinned geometry toolchain (manifold3d, trimesh, numpy). |
| `exports/*.stl` | Binary STL per printable part, already in print orientation. |
| `exports/assembly.glb` | Current XIAO profile: mug and plain assemblies, with the XIAO outline for reference. |
| `exports/assembly-puck-legacy.glb` | Legacy Puck.js profile: the four original assemblies with a Puck case reference. |
| `exports/manifest.json` | Hashes, sizes, print notes, transforms and every check result. |
| `preview/` | Browser preview of both profiles, each handle, the joint and a section view. |

## Two pieces, more prints

Ethan asked for a wand in two pieces where the wand end plugs into the handle. Those are the
two assemblies:

1. **Handle** (mug or plain). Swappable.
2. **Wand**: lower shaft, upper shaft and the XIAO tip, glued once into one piece.

The wand is longer than the 256 mm bed, so it prints as separate parts joined by glued half-laps
(long flat overlaps, not threaded stems). After gluing it behaves as the single second piece.

The shafts are sized from `overall.length` (500 mm, butt to the legacy Puck cap, matching the
existing roughly 50 cm wand). With the XIAO tip on the same shafts, the board's front edge is at
478 mm and the USB plug sticks out beyond it.

## Handles

All four share the socket, button rail, pod stop and wire route, so every handle fits the same
shaft and pod. The loops are a 22 mm wide bar with 45° chamfers. Opening sizes are measured
from the model's mid-plane section.

| Handle | Opening (length × height) | Intended grip |
| --- | --- | --- |
| Round (legacy) | 38 × 38 mm | Small loop for two fingers; thumb on the buttons. |
| Oval (current mug) | 101 × 31 mm | Full-hand D-loop around four fingers, so the wand stays on a relaxed hand. |
| Angled | 100 × 47 mm (deepest at the palm) | Raked loop for a less bent wrist while pointing. |
| No loop | None | Rounded straight grip; the quickest one to try. |

Comfort is untested; these are distinct starting shapes to try, not ergonomic claims.

### No loop

`handle-straight` is the same 140 mm handle with the loop removed and a round 24 mm grip instead of
the chamfered slab. It prints on its side like the others: the underside meets an 11.9 mm bed flat
through 45° faces, avoiding supports under the grip itself, and a 10 mm flat on top seats the rail. The shared rail/socket overhangs still need slicer attention. The butt is
rounded in side view.

Solid model volume and bed footprint (slicer infill, walls and speed decide the real time and
filament):

| Handle | Solid volume | Footprint on the bed |
| --- | --- | --- |
| No loop | 60.1 cm³ | 140 × 36 mm |
| Round | 100.3 cm³ (no loop is 40% less) | 140 × 88 mm |
| Oval | 111.5 cm³ (46% less) | 140 × 81 mm |
| Angled | 115.7 cm³ (48% less) | 140 × 97 mm |

Walls keep the loop handles' minimums: 2.75 mm beside the twist-lock grooves at the bed flat,
3.75 mm or more elsewhere around the socket. Change `handle.variants.straight.grip_radius` for a
thicker grip; the section must stay larger than the socket and pod seat.

## XIAO tip

`tip-xiao` holds a bare XIAO board flat, component side up (the button side), USB end forward.
It is an open U-shaped deck, not an enclosure:

- The deck carries the documented 21 × 17.8 mm outline with 0.3 mm clearance. 0.6 mm side lips
  locate the board without covering the castellated edge pins.
- A 2 mm rear wall stops the board sliding back; a 6 mm slot through it drops the wires into the
  shaft groove.
- The top, USB connector and antenna end are open. The deck stops 1 mm short of the USB end so
  a plug isn't blocked.
- A 0.6 mm relief under the middle of the board keeps the deck off the underside, apart from a
  1.5 mm border.
- Two pairs of side notches take tape or a small cable tie around board and deck. There are no
  snap tabs and nothing clamps components.
- The rear tongue is the same as the legacy cradle's, so it laps under the unchanged upper shaft
  and glues the same way.

Assumptions, all in `dimensions.json → xiao_tip`:

- Board: Seeed XIAO nRF52840 Sense or XIAO MG24 Sense. Which one this wand carries isn't
  physically confirmed. Both document a 21 × 17.8 mm footprint in Seeed's
  [nRF52840 documentation](https://wiki.seeedstudio.com/XIAO_BLE/) and
  [MG24 documentation](https://wiki.seeedstudio.com/xiao_mg24_getting_started/).
- PCB thickness 1.2 mm and component height 3.5 mm are provisional clearances, not measurements.
  The model keeps that space above the board clear of every part.
- The board's axis orientation relative to the wand depends on its firmware; nothing here
  verifies the pointer directions.
- No battery holder. Tape the battery to the shaft or handle.

## The twist-lock joint

The lower shaft ends in a 13 mm spigot with three pins. The handle has a matching socket.

- **Keyed entry.** The pins sit at 10°, 190° and 280° (measured from the button side, clockwise
  seen from the tip). The uneven spacing only lines up with the socket's entry slots one way,
  so the tip and buttons always end up on the same side.
- **Push in.** Hold the shaft with the tip turned 38° anticlockwise from upright and push it in
  until the spigot end meets the socket floor. The floor is the axial stop.
- **Twist.** Turn the shaft 38° clockwise (seen from the tip) until the tip is upright. Each pin
  rides a ramp, crosses a small ridge (0.15 mm interference by default) and drops into a
  shallower pocket (0.05 mm), pulling the spigot onto the floor. The ridge is what should resist
  turning back; the end of the groove stops over-twisting.
- **Retained.** In the locked position each pin sits under a 6.5 mm thick retaining wall, so the
  shaft can't pull straight out.
- **Release.** Twist back 38° past the ridge, then pull.

The ridge and pocket rely on PETG flexing very slightly. Only the real print shows if that
feels like a click, a firm stop or nothing, so the coupons come first.

A plain friction taper would be simpler but can't key the tip's orientation or resist
rotation, so it isn't included. If every coupon fails, a taper is the fallback.

### What the model checks (exports/manifest.json → checks.joint)

- At the entry angle the spigot slides fully home with zero overlap.
- It can only be pushed in within ±2° of the entry angle; every other angle collides.
- Through the twist, the only overlap is the cam: at most 0.15 mm along the axis.
- Locked, every coupon variant rests on the 0.05 mm pocket.
- Pulled 0.6 mm outward when locked, or twisted 6° past locked, the parts collide.

These prove the geometry does what's described. They don't prove the printed parts will.

## Print set

All parts are exported in print orientation, sitting on z = 0. Horizontal bores use flattened
teardrops so their tops bridge 1–3 mm instead of arching. However, Bambu Studio 2.8.2 flags
floating regions under the male pins and floating cantilevers around the female rail/socket.
The face-angle geometry check did not establish that those features print unsupported.
Enable supports and inspect their placement; remove them completely from the mating surfaces
before trying the joint. Brims help the long thin shafts stay down.

### Current XIAO slicer estimates

Bambu Studio 2.8.2 with a P1S 0.4 mm nozzle, provisional Generic PETG, textured PEI,
0.28 mm Extra Draft, two walls, 20% infill, automatic tree supports and a 4 mm outer brim:

| Set | Estimated time | Estimated filament |
| --- | --- | --- |
| Plain handle, both shafts and XIAO holder; no button pod | 2 h 05 min | 62.4 g |
| Full-hand mug loop, both shafts and XIAO holder; no button pod | 2 h 39 min | 83.8 g |
| Joint samples plus XIAO holder, at 0.20 mm Standard | 1 h 16 min | 28.1 g |

Each set fits one plate and slices without floating-region warnings. These are estimates,
not measured print times, fit or strength. Select the actual loaded filament and re-slice
before printing. The separate small holder can be fitted to the real board before gluing.

### Earlier Puck slicer comparison

The following are **estimates, not measured prints**, made with Bambu Studio 2.8.2, a P1S
0.4 mm nozzle, Generic PETG, a textured PEI plate, 0.28 mm Extra Draft, two walls and 20% infill.
Automatic tree supports and a 4 mm outer brim were enabled. These were sliced before the XIAO
tip existed and describe the legacy Puck set. Select the actual loaded filament
preset and re-slice before sending a print; these are provisional settings, not a strength rating.

| Set | Estimated time | Estimated filament |
| --- | --- | --- |
| No-loop handle | 1 h 4 min | 31.1 g |
| Round-loop handle | 1 h 30 min | 47.6 g |
| No-loop handle, both shafts, tip cradle/cap, pilot button pod | 2 h 36 min | 80.1 g |
| Five joint/Puck fit samples, at 0.20 mm Standard | 1 h 13 min | 27.1 g |

The supported no-loop handle is about 29% faster than the supported round-loop handle in
this comparison. The full six-part set fits one plate and slices without floating-region
warnings with supports enabled. This does not prove physical fit or easy support removal.
Print the small fit samples first. Keep printer/account settings and sliced job files locally;
the parametric source and exported meshes are the maintained design.

Print in this order:

| # | Part | On the bed | Notes |
| --- | --- | --- | --- |
| 1 | `coupon-male` | Flat +X face | The real shaft spigot and pins, 28 mm long. |
| 2 | `coupon-female-a/b/c` | On its side | Real handle socket and 14 mm of button rail. 0.05 / 0.15 / 0.30 mm cam ridge; 1, 2 or 3 notches on the back. |
| 3 | `tip-xiao` | Deck up | Current tip, 53 mm long. Check the bare board fits before gluing. |
| 4 | `shaft-lower`, `shaft-upper` | Flat +X face | 183 mm each. Brim recommended. |
| 5 | `handle-straight` and/or `handle-oval` | On its side | Plain and mug handles, 140 mm long. |

Legacy Puck.js parts, unchanged and not in the current set: `coupon-puck-ring`, `tip-cradle`,
`tip-cap`, `handle-round`, `handle-angled`, `button-pod-pilot`, `button-pod-blank`.

Handles and shafts print with layers along their length, which is usually the stronger
direction for bending. Wall and infill settings are yours to choose; nothing here has been
strength tested.

## Legacy Puck.js tip

The tip cradle holds the Puck.js v2.1 in its stock case, flat, with its top facing the button
side, matching the website model and the device code's axis mapping. The case is documented as
36 mm × 12.5 mm; the pocket is 36.6 mm and was not checked against a real case.

- The cap ring presses over the cradle rim and overlaps the case edge by 1.5 mm. The centre stays
  open, so the light and the Puck's own button remain exposed.
- Thumb notches on both sides lift the case out to reach the battery.
- A notch at the front of the rim marks the forward direction. The pocket is round, so turn the
  case to match the current wand before closing the cap, then check the pointer directions.

## Wiring

The three buttons and ground are four wires, as in [BUILDING.md](../../BUILDING.md):

XIAO pins → slot through the deck's rear wall → groove in the tip's tongue → 5 mm bore through
both shafts → spigot end → connector bay behind the socket floor (12 mm × 17.5 mm) → 6 mm channel → wire hole
in the rail on top of the handle. Without a pod, the buttons are mounted however suits this
prototype, such as taped on; the legacy route ends inside the button pod.

The legacy Puck route starts at the cradle's rear notch instead. A 3 mm wire path through either
route clears every part in the model. To swap handles
without re-soldering, put a small four-way inline connector in the bay; the mated connector must
pass the socket floor opening, 9 mm round with a peak (about 9 × 10.9 mm). No connector is specified. Thread the shaft wires
before fitting their connector.

## Button pod (legacy)

The current XIAO set doesn't use it. The pod slides onto the dovetail rail from the back of the handle until it meets the stop, and a
short piece of 1.75 mm filament through its back end pins it to the rail. The pod has a 13 mm
wide, 10 mm deep cavity. The real switch sizes are unknown, so there are no switch holes:
`button-pod-pilot` has 2 mm pilot holes at the Bottom, Middle and Top centres (22 mm apart,
Top nearest the shaft); `button-pod-blank` has none. Measure the switches, then drill out, or set
`pod.height`, `pod.button_pitch` and the cavity size in `dimensions.json` and rebuild.

## Fit checklist

Coupons first:

- [ ] Male coupon enters each female coupon at one angle only and slides home without force.
- [ ] Twisting 38° clockwise: resistance rises, then it settles. Note click, stop or nothing.
- [ ] Locked: a firm pull doesn't separate them. Note any wobble.
- [ ] Twisting back releases with deliberate force, then it pulls out.
- [ ] Pick the best of a, b and c and set `joint.cam.crest_interference` to match. If all are loose
      or tight, adjust `joint.bore_clearance`, `joint.slot_clearance` or the cam values and reprint.
- [ ] The bare XIAO board sits in `tip-xiao` between the lips, flat, without forcing; USB plugs in.
- [ ] Tape through the notches holds the board without pressing on components.
- [ ] A printed pod slides onto a female coupon's rail without binding or rattling.

Then the full parts:

- [ ] Glue the shaft half-laps and the tip with the flat +X faces down on a flat table. Glue
      strength on PETG is untested.
- [ ] Each handle: reach to all three buttons, grip or loop comfort, wrist angle while pointing.
- [ ] Balance and weight with the XIAO and taped battery fitted.
- [ ] Pointer directions after mounting the XIAO.
- [ ] Legacy only: the stock Puck case drops into the ring coupon and the cradle.

## Rebuild and check

```sh
python3.11 -m venv .venv
.venv/bin/pip install -r requirements.txt
.venv/bin/python wand_cad.py          # rebuild exports/
.venv/bin/python wand_cad.py --check  # rebuild in memory, compare byte for byte, run every check
```

The build is deterministic: rebuilding with the pinned toolchain gives identical bytes.
`npm run check` (repository root) also verifies the exports against the manifest and checks
every STL is a closed mesh, without the Python toolchain.

## Preview

Serve the repository root and open the preview (it reuses the website's Three.js):

```sh
python3 -m http.server 8850 --bind 127.0.0.1   # from the repository root
```

Then open `http://127.0.0.1:8850/magic-wand/hardware/printed-loop-wand/preview/`. It opens on the
XIAO profile with both handles. Direct links:

- `?profile=xiao&view=mug`: mug handle only.
- `?profile=xiao&view=plain`: plain handle only.
- `?profile=puck-legacy`: the four legacy Puck.js assemblies.

Viewing controls (top left of the 3D view):

- **Turn** (default), **Move** or **Zoom** decides what dragging and scrolling do. Scrolling over
  the view turns the model rather than zooming, so holding the wand's Bottom button over it (which
  the receiver sends as scrolling here) turns it too. The choice is remembered in this browser.
- Pinch (Ctrl+scroll), **−** / **+** and two-finger pinch on a touch screen always zoom.
  **Reset view** or a double-click restores the framing.
- With the view focused: arrow keys turn, move or zoom by the selected mode (Shift for bigger
  steps), + and − zoom, 0 resets, and T, M or Z choose the mode.
- Only the 3D view takes scrolling; the sidebar scrolls normally. The page doesn't change the wand
  receiver: there's no automatic 3D-viewer detection.

## Known limits

- Nothing has been printed. Fit, strength, comfort, balance and mass are unmeasured.
- The XIAO outline is documented, not measured. Its thickness, component height, pad positions and
  which XIAO is fitted are unconfirmed. The board's fit, tape hold and orientation are untested.
- The Puck case size, switch sizes, button spacing and wire bundle size are documented or assumed,
  not measured.
- The cam relies on small elastic interference; PETG may creep and loosen it over time.
- The spigot stops on a socket floor ring about 1.6 mm wide, narrow so the connector can pass;
  its wear is unknown.
- Overhang figures in the manifest are a simple face-angle count, not a slicer's verdict.

Previous candidate: [V16 — recessed switches without square surrounds, both hands](v16/README.md). Thin switch plates now print flat. Print the matching pocket coupon before the stems; physical fit remains unverified.
