EthanSK/magic-wand/magic-wand-3d-models/Print-17-README.md

# Print V17 — smooth lower handle join, both hands

The exposed diagonal lower connector and hanging blunt toe are removed. The curved return now encloses the lower stud collar. The recessed lift-and-left-turn lock and both handed stems are unchanged, so only the removable handle needs reprinting.

[Replacement handle only](Print-17-replacement-loop-only.3mf), [complete project with both handed stems](Print-17-complete-left-right-recessed-switch-410mm.3mf), [small lock test](Print-17-detachable-loop-fit-test.3mf), and [editable CAD and assembly guide](../magic-wand/hardware/printed-loop-wand/v17/README.md). The complete project has one shared set of remaining parts; choose one stem.

One left wand estimates 75.048 g printed PETG and 3.443 g removable support/brim. Hardware remains unweighed. Check the small lock first; physical fit and strength are unverified. The helix, taper, recessed switches, flat plates, electronics routes and all earlier revisions are retained.
