EthanSK/magic-wand/magic-wand-3d-models/Print-7-README.md

# Print V7 — slimmer ventilated wand, both hands

The 410 mm helix wand now has a 1.6 mm slimmer grip, an 18 × 12 mm hollow loop, and flute-like ventilation holes in the grip, loop and shafts. Thin hollow skins and local reinforcement replace unnecessary material. Button centres, slide-in plates, joints and diamond silhouette are retained.

One complete left wand estimates **75.688 g printed PETG**, down from 91.027 g in V6 (**16.85% less**). The grip alone falls from 45.908 to 35.859 g. Allow a further **24.312 g maximum** for all bought hardware to remain at 100 g; that hardware is unweighed. An 80 g fully assembled wand is not established. Removable support/brim is excluded from finished-part mass.

- [Complete both-hand project, 11 instances](Print-7-complete-left-right-top-slide-410mm.3mf).
- [Exactly one complete left wand, 10 instances](Print-7-one-left-wand-410mm.3mf).
- [Optional upper replacement for a retained V2 grip](Print-7-upper-only-helix-410mm.3mf); its old handle is not the lightweight V7 handle.
- [Button fit coupon](Print-7-top-slide-button-fit-test.3mf) and [joint fit coupon](Print-7-slim-bayonet-fit-test.3mf).
- [Editable CAD, checks, mass report and assembly notes](../magic-wand/hardware/printed-loop-wand/v7/README.md).
- [Interactive V6/V7 comparison](../magic-wand/hardware/printed-loop-wand/v7/preview/index.html), served through a repository HTTP server.

Both handed grips are included in the complete project's build list. Physical strength, comfort, printed fit and all-up weight need a real trial. Open vents do not provide splash protection. Earlier versions are preserved.
