EthanSK/magic-wand/.agents/skills/magic-wand-print-design/SKILL.md

---
name: magic-wand-print-design
description: Revise Magic Wand printable hardware, CAD, assembly previews and Bambu projects while preserving the helix, tapered silhouette, both handed grips and tested interfaces. Use Fable 5.2 for model changes within included usage, and audit actual sliced holes, supports and likely snap points before finishing.
---

# Magic Wand print design

Read this skill before any wand CAD, print-layout or mechanical preview change. Follow the repository's magic-wand-dev skill and hardware lessons. Mechanical print versions are separate from firmware control versions.

Before running CAD, exporters or geometry probes, follow the printability audit's [allocation-efficient geometry workflow](../printability-audit/references/geometry-budget.md). Use complete batched queries and serial owned jobs; fix excessive allocation rather than imposing hard RAM limits or a host-pressure gate. This applies to implementation and reviewers alike. User-corrected — 2026-11-06.

## Continuous improvement

Preserve Ethan's explicit project rules and useful verified mechanical lessons here or in the owning component's LEARNINGS.md. Refine guidance when it changes future design decisions; preserve unrelated rules, distinguish measured evidence from physical acceptance and keep guesses, private transcripts, paths, receipts and credentials out of public files. Mark agent-discovered material workflow additions Self-improved with date, reason and evidence; user-requested changes retain their own attribution. Validate affected models/checks and the skill before finishing.

## Skill usage announcement

Tell Ethan this skill is active and briefly why, using response-preferences when available. Reuse the announcement for the same ongoing model work.

## Model changes

User-requested — 2026-11-09: “make all the 3D models with Fable 5.2. But don't burn credits there.” Use Fable 5.2 for wand model design and implementation through included subscription usage, with no paid API credits or overage. Preserve useful existing model-session context. If the requested model or included usage is unavailable, report the writing limitation before substituting an author; independent read-only work can continue. This supersedes the 6 November Opus-author preference. Codex coordinates verification and publication; follow the host's Claude-invocation workflow and verify the actual model. Implementation does not replace the final independent printability audit below.

User-reaffirmed — 2026-11-09: “don't use too much of my Fable credits.” Conserve included allowance as well as avoiding paid charges; reuse useful session context and checked evidence instead of repeating settled work.

## Prototype holder priorities

User-requested — 2026-11-07: think through the whole held assembly from the actual components before redesigning it, so avoidable fitting and comfort mistakes do not keep requiring another print.

- The parent agent gathers the bought component identities, authoritative drawings, relevant earlier decisions and working-reference photos, then gives the model author the whole source-linked fit brief. Separate fitted or measured parts from catalogue assumptions, basket ideas and later orders. Inspect the photos themselves; preserve unresolved dimensions as unknown rather than certifying a generic CAD reference as the bought assembly.
- “Let's not make the holes too snug.” Prefer sensible clearance and “little bits sticking out to hold it in place where needed”, with robust local tabs or ledges so similar prototype components can be removed and swapped. Optional glue or tape is acceptable for component retention. This replaces the older glue-free tight-capture preference for these prototype holders; it does not authorize bonding an adjustable holder to the rod or making wires structural retainers.
- Material should serve actual support and positive load paths. Strengthen loaded joints and fixed roots without filling working openings or turning intended springs solid. Prefer simple, understandable rod attachments; distinguish removable print helpers from the permanent structure. Keep the existing adjustable slide-on intent unless Ethan changes it.
- Print bases and supports must come away without breaking the holder. Ethan: "Just have like a very narrow connection to the actual main component." Prefer accessible sacrificial connections on strong fixed faces; check their realised printed sections and removal direction, as well as adhesion. Keep the battery gate easy to push in and release, with the battery replaceable and held against vertical movement without squeezing its pouch. User-corrected — 2026-11-08.
- Skin-contact edges should be “rounded, like nice and smooth”, not hard edged. At the five-key holder's lower/front edge beneath the three lower keys, avoid a projecting lip or poking corner; a sharp chamfer or V-notch is not a substitute for genuine rounding. Preserve switch lands, travel and substantial joints while shaping the contact.
- User-clarified — 2026-11-10: “I solder outside and then I slot them in after.” Check the complete prewired insertion/removal path, including solder and wires; in-place solder-tool access is not required. Prefer the requested shallow rounded beams integral with the carrier where feasible, retaining some finger contact with the rod, rather than assuming a bulky separate basket is necessary.
- User-requested — 2026-11-09: fingers should not rest directly on exposed switch/socket contacts beneath the keys. Prefer a shallow open protective structure, such as a few smooth beams from the key-holder edges toward the rod support forming 3D triangles, instead of a heavy solid cover. Check the actual finger-rest area, electrical/component clearance, wiring and assembly/removal routes; an attractive sparse net is insufficient if the resting finger still reaches the contacts. Reassess unnecessary carrier thickness while preserving its real loaded joints and switch interfaces.
- User-requested — 2026-11-09: the XIAO should still be a holder, with side walls or stops that locate the board and sensible local space for protruding solder and wire exits. Avoid a flat, wide support without a definite seated position.
- User-requested — 2026-11-09: for the key carrier, favour well-spaced lightening holes while retaining strong load paths and its bought interfaces; the rod grip should resist ordinary side-button pressing while remaining reasonably flexible to assemble.
- Keep open structures light and attractive: pointed or arrow-like flowing patterns are welcome instead of arbitrary rectangular windows, with enough printable material at their connections. A snug battery should not jiggle, but must retain insertion clearance and must never squeeze the pouch or load its protection electronics.
- User-requested — 2026-11-10: try curved, quarter-circle-like edges in place of straight triangular cutout lines where the opening still clears the hardware and leaves enough material at its joints. Preserve the fit of working parts.
- User-requested — 2026-11-10: lightening holes should have “spiritual vibes and shapes”, with intricate, flowing patterns that make the part beautiful while removing mass. Preserve printable webs, loaded connections and working clearances. Carry this intent across wand components rather than treating the holes as arbitrary rectangular windows.
- User-requested — 2026-11-10: “I want you to reprint keepers every time.” Include each holder's matching keeper/door in every new holder batch unless explicitly excluded; do not depend on finding an old piece. Small extra material and time are acceptable. Clearly distinguish old-compatible and revised fit trials.
- User-corrected — 2026-11-10: omit the loose flat battery spacers from routine holder plates, including when reusing older layouts. Reserve them for a specific battery fit trial. Matching doors and keepers still belong on their holder's plate.
- User-requested — 2026-11-10: “Every part of it has to animate.” In the same dropdown, show the individual pieces assembling in a physically possible order, then show the assembled part going onto the wand and being used. Show what keeps it from falling off through the full motion, and animate release or removal where it applies. Use cutaways for hidden catches, pins and stops. Integral pieces stay together in the animation.
- User-requested — 2026-11-10: show designs with complete retention as candidates for review. Check what holds the moving part and its mount at rest, during use and on release. Keep incomplete ideas apart from candidates with one large, plain status explaining the actual gap. Treat a digitally checked concept and a printed fit as separate evidence. Default to only the essential annotations that help the user see what moves, what holds it, or what needs attention, with a hide control.
- Generate the guide alongside each new model version from its actual meshes and checked motion. Register it in the [assembly catalog](../../../magic-wand/hardware/carbon-rod-holders/assembly/catalog.json), keep old versions selectable, and make the latest checked revision the default. Identify disposable print helpers separately from installed parts.

These prototype-holder priorities do not import the full Shard wand's helix or loop geometry into carbon-rod accessories. Keep the applicable design's established interfaces and ergonomic layout.

## User design rules

- Preserve the original counter-wound helix / criss-cross pattern and recognisable wand silhouette. Reducing mass means thinner walls and hollow interiors; it does not authorize removing decoration or replacing the shape.
- The shaft body must taper continuously towards the head. No pinched waist that widens again, and no external bulb/collar added solely for a joint. Reinforce joints internally. The diamond naturally widens above its matching narrow neck.
- A complete Bambu project always contains **both left- and right-hand handles**. One shared set of shaft/head parts is acceptable, as in Print V2; state the contents clearly. A left-only file may be an explicitly labelled optional subset, never the complete delivery.
- Preserve purchased switch/socket holes and their alignment when reducing the surrounding insert. Recess compact mounts into the grip; use the purchased caps rather than adding visible printed squares or cap covers.
- Preserve board retention, upward USB access, battery solder/wire clearance, cable routes and handed button positions unless the user changes them.
- The current Shard R2 loop candidate uses radial hook entry, a 4 mm upward slide into solid load stops, and a separate indexed quarter-turn keeper. Insert the keeper fully, turn it 90°, then pull outward 0.65 mm to seat it; press in before turning back to release. Remove the battery cap during handle entry/removal. This replaces the failed whole-loop cam and flexible catch. Preserve its final orientation, butt anchors, band and both hands; verify the whole route and whole locked assembly. See the latest repair section below. Physical fit and strength remain unverified. User-corrected — 2026-10-28.
- When the loop is removed, the stem must remain completely usable as a normal wand, with no projecting brackets, receivers, rails or release tabs. Put the receivers inside the existing surface and keep projecting pegs and release hardware on the removable loop. Inspect and verify the bare-wand state alongside the attached state in both hands. V14’s external cam housings were rejected despite its working geometric lock; retain that model only for history. User-corrected — 2026-10-27.
- Keep prior models and delivered files unchanged. New revisions and supporting files go to Downloads; editable sources and regenerated exports are committed together under the repository rules.

## Fixed ergonomic priorities

Read the frozen [V20 design principles](../../../magic-wand/hardware/printed-loop-wand/v20/design-principles.json) before the next revision. They define the butt reference, lower mount, mount spacing and button offsets. Preserve these relationships until the user explicitly changes them; do not derive a new hand position from a convenient connector location.

- Keep the removable finger loop at the butt, with only the clearance needed for the cap and release motion. Removing an unwanted tail must not lift the whole handle higher up the wand. V18 failed this: preserving its high mount positions was the wrong priority.
- Keep all three buttons positioned relative to the loop as one ergonomic group, mirrored for both hands. Moving the loop requires moving the group by the same amount. Preserve button angles and their relative height spacing.
- The loop is a slim solid band, not a thick hollow tube. Keep reinforcement local to the locking ends. Do not preserve obsolete tubular cavities or perforations after this explicit change. The current V20 band is 9 × 4 mm with 1.4 mm rounded edges and gradual 23 mm flares into the wider fitted pads. A request to widen/smooth the loop does not authorize changing its butt anchors, button layout or compatible locking geometry.
- A requested 5–10 mm grip reduction is a substantial size change, not another 1 mm adjustment. Report measured axes honestly. Keep battery space and the wire route, and disclose a wider battery section rather than claiming a circular diameter reduction where none exists.
- Locking interfaces serve the approved grip position and silhouette. Do not silently sacrifice those priorities to reuse old pegs, cap dimensions or joint heights. Verify the cap, buttons, cell, wires and complete attachment path after resolving the packaging.

## Before calling it final

User-corrected — 2026-11-11: “not regularly, but just before printing and then iteration.” Slice and inspect the finished candidate before printing each iteration. Use the printed result and Ethan's feedback to revise the design, then slice and check the next finished candidate before its print. Repeat affected checks when a repair changes the checked print file. Reuse unchanged checked results; a commit alone does not require another slice. This supersedes regular interval slicing and the earlier before-committing wording. Keep the final printability audit and checks of the delivered file.

Before finishing every model or print project, use the repository's [printability-audit](../printability-audit/SKILL.md). It owns the recurring independent Opus review of actual holes, support removal and likely snap points, with minimal design changes. Keep implementation and independent review distinct.

Map each requested change to a source parameter or feature and a check. Compare old/new assembled views, not just the print plate. Check the core-radius profile for monotonic taper; explicitly check the helix is generated. Inspect both handed handles and count both in the actual 3MF build. Check new joints inside the chosen silhouette instead of making the silhouette fit arbitrary collars.

Run manifold, wire/board/USB, joint motion and lid capture checks as applicable. Slice in the actual PETG setup and compare like-for-like material estimates, including supports. Support contact blockers do not alone stop tree branches or descending normal-support columns entering hollow passages; block their landing-source regions where needed and inspect sliced paths. Separate CAD clearance, slicer evidence and physical print acceptance. If the battery product is still unknown, retain its provisional status rather than inventing a fit.

## Verified design lessons

Before work, read the applicable lessons here and in magic-wand/LEARNINGS.md. Preserve worthwhile verified improvements during the same task; this does not create a background learning process.

- 2026-10-26 — Explicit user correction: the V3 candidate lost the helix and used narrow spans between wider joint collars. Preserve the helix and a monotonic shaft silhouette while hollowing/thinning the interior. Source geometry and assembled preview establish the regression; neither the old nor replacement design is physically strength-verified.
- 2026-10-26 — Explicit project requirement: complete means both handed handles. Exporting a right-hand STL separately does not meet that requirement if the opened complete 3MF has only the left handle.

- 2026-10-26 — Explicit button-mount correction: use a small rounded thin plate that slides down from above directly into integral wand guides. No bulky cassette, separate printed cap/keeper or glue. Keep the bought keycap distinct from printed parts. Back the socket recess and use a small cable outlet rather than a generic large opening into the hollow grip. Check the full insertion path in both hands and past neighbouring buttons; an assembled pose alone is insufficient.
- 2026-10-26 — Mass comparisons must contain exactly one complete wand per row (one handed grip plus matching shared parts). Report printed-parts mass separately from support/brim and keep original print settings distinct from a matched-settings comparison.

- 2026-10-26 — Explicit handle correction: keep the mug loop at the butt with removable-cap clearance, controls above and clear of it, and greater outward projection in the upper/thumb region than in the lower return. The user corrected the earlier sloping-arm interpretation: keep loop orientation and button angles unchanged. Vent holes must reach the inner hand-contact face, not only the broad side faces. Check both hands and the whole assembled relationship; isolated button coordinates are insufficient. CAD passage probes and sampled sliced paths establish clearance, not physical comfort or cooling.

- 2026-10-26 — Current loop requirement: detachable without unplugging wiring, using the same mounts on both handed stems. Check the entire released slide past caps, positive radial/lift capture and a small print coupon. A geometric spring-deflection envelope does not establish PETG force or fatigue life. The user rejected the open-braid interpretation: keep the supporting tube and entire raised helix strips continuous. Cut independent elongated slots between those strips, preserving longitudinal lands and local solid collars/hardware protection. Do not turn the helix itself into holes. Use elongated loop slots instead of little bores. Inspect sliced paths and actual single-wand extrusion mass.

- 2026-10-26 — The subsequent narrow-slot V10 fallback was also rejected: it was too closed and the little apertures looked arbitrary. Preserve the solid decorative strips and established silhouette while using broad, regular curved cells with separate continuous axial rails and short connecting webs. A rejection of an unsupported braid does not authorize a nearly closed tube. Compare assembled old/new views at useful scale; keep aesthetics, opening area, sliced mass and physical strength as separate claims. V11 is a checked candidate, not user acceptance.

- 2026-10-27 — Explicit V12 refinement: slightly smaller individual handle openings, more flowing Art Nouveau leaf curves, smoother and slightly thicker connecting lines. Preserve the established helix, taper, controls, both hands and mechanisms. Verify reinforcement in the final hollowed solid: V11's nominal 1.4 mm grip rails were trimmed to 1 mm by the later core subtraction. V12 adds grip rails after hollowing, removing hardware clearances separately; material probes establish added depth, not breaking strength.

- 2026-10-27 — Verified cam preload check: test contact throughout the rigid mount’s available float, not only at the nominal assembled pose. A tiny spring-tooth interference can disappear before the dovetail takes up its clearance. V14 retains tooth contact through its free radial travel and separately checks the seated/released spring envelopes, two-handed motion, independent hard stops and printed coupon. These geometric checks do not measure PETG force or fatigue.

- 2026-10-27 — Current switch correction: remove the projecting square pocket surrounds. Recess the thin mounting plate/socket into the existing curved stem, retaining them with small side claws and lower stops; the bought keycap is the visible cover. The V16 radial clip entry supersedes the older top-slide-guide requirement. Keep actual socket holes and button positions. Wires never retain the switch mechanically. Check released-claw insertion, positive capture and full cap stroke in both hands; print the small fit test before the stems.
- 2026-10-27 — Verified orientation correction: V15 rotated its thin XY switch plate 90 degrees and printed it upright despite a comment claiming it was flat. Inspect the actual exported transform and lowest-face contact area. V16 turns the broad plate face onto the bed, leaving its small rear feet upwards; its 2.5 mm print height replaces the prior 17.2 mm height. Check the prepared project, not the comment.

- 2026-10-27 — Verified deeper-switch interference: after moving pockets inward, hidden detachable-loop reinforcement was unioned after the switch clearances and filled part of the right thumb socket seat. Subtract control pockets and clip relief from that reinforcement before union, and check every socket and switch in both handed stems. The sliced extrusion check detected ordinary wall paths inside the right socket despite the earlier left-only component check. Geometry and toolpath clearance remain distinct from physical fit.

- 2026-10-27 — Latest handle correction supersedes V17: both loop ends must run directly inward into the wand, with matching broad seats and substantial captured pegs entering recessed holes. Do not replace a dangling toe with a rounded U return, bulb or a handle hovering on exposed thin pins. Inspect top and bottom in close-up, attached and removed; check inserted shoulder material, nominal clearance, load-bearing stops and the complete locking/release motion. A visually continuous seat and geometric capture do not establish printed strength. Slim the lower grip while preserving the wire bore, battery cap and complete helix outside necessary local mounting openings.

## Main Shard mechanical repair — latest correction (2026-10-28)

The user explicitly instructed work on main again, on top of its Shard Tube model. The separate V20 snapshot remains preserved. This instruction overrides the earlier snapshot-branch-only workflow for this repair.

- Actual physical assembly failures override a previous CAD-only “passed” claim. Do not defend a tight or fragile nominal fitting as physically working. Keep the butt/control anchors while replacing the failed mechanism.
- Current R2 loop candidate uses two recessed curved hook receivers: radial entry with the loop 4 mm low, upward slide into closed load stops, then a separate keeper inserted inward, turned 90° and pulled outward 0.65 mm into anti-turn notches. Push inward before turning back to release. This replaces the failed whole-loop cam and flexible catch. Remove the battery cap for the handle's travel; close it only after seating the handle. Verify the whole moving loop and whole locked loop+key, not only a peg or nominal pose. Physical fit/strength remain unverified.
- The user rejected the separate projecting square switch parts, carrier tracks and fragile printed claws. Use the bought Choc switch's own clips with an integral grip seat. Boolean every required post/pin/socket/wire void from the final union, after rails and receiver reinforcement. Each grip must export as one closed normal mesh. Slicer negative volumes are not a substitute for physical CAD openings.
- Verify the full battery/sled insertion from outside the open bottom, not only a cell already seated in its chamber. Keep an open ladder sled and thin guides, not a solid battery-shaped block. Use conservative rectangular cell geometry where the actual cell shape is unknown; do not conceal interference with rounded reference corners. Keep purchased dimensions provisional until verified.
- The optional heavier screw cap belongs below the hand. R2 adds 18 mm below the butt using 45% gyroid, 3 walls and 5 top/bottom layers; retain a lighter interchangeable cap. This is a tested print recipe candidate, not a permanent requirement to increase wand mass.
- Do CAD Boolean work outside Bambu Studio. Export the completed normal solids for slicing. Distinguish legitimate labelled print-support helpers from physical hole definitions. Retain the unchanged Shard cradle's checked back-flat/manual-low-back support recipe; unsupported orientations have actual floating starts. Check sliced support as well as model extrusion in its board/USB/wire/lock spaces.
