EthanSK/magic-wand/.agents/skills/magic-wand-print-design/user-preferences.md

# User preferences for printable Wand models

Read this when an unsettled design or model-authoring choice needs preference history. Settled work needs no lookup.

Use `learned-user-preferences` to locate this repository's private project profile, query the relevant hardware, key-layout or model-authoring topic, and read only the matching entries. Preserve original wording, context and reasons in that private evidence.

Keep detailed history outside this public skill. Current instructions take precedence; earlier preferences or permissions do not authorize future actions. Existing skill-learning and repository-learnings duties remain separate.
