EthanSK/magic-wand/.agents/skills/printability-audit/user-preferences.md

# User preferences for printability review

This is a shared project skill. When an open choice needs Ethan's exact wording or reasons, use learned-user-preferences to locate the current project's private profile, then query its hardware/printability branch. Routine settled work needs no history lookup.

Keep authored prompts, personal feedback and model-run transcripts private; this public file is only a router. Evidence does not authorize future sends, monitoring or unrelated hardware changes.
