EthanSK/magic-wand/docs/how-to/index.html

Skip to the videos

 Magic Wand

# How do I…?

Pick an action. See the buttons, the wand movement and what happens on screen.

Illustrated guides for Control V2. They call the mouse button Bottom, the HUD button Middle and the speech button Top. The current V3 uses straight drags and keeps scrolling while the mouse button is held; the circle-scroll clips show the older selectable V2. Each clip has narration, captions and a transcript.

Find an action

Clear

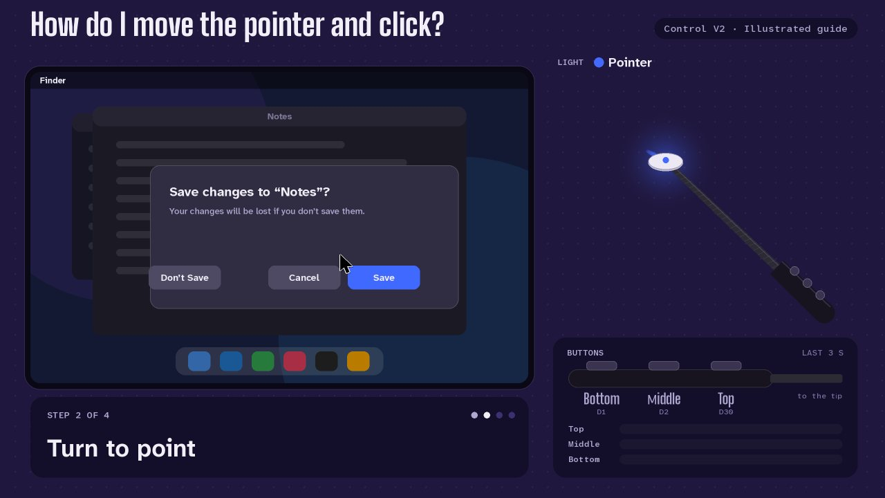
[picture p155: docs/how-to/videos/point-and-click.jpg]
-  0:17

## How do I move the pointer and click?

  Tap the mouse button to point and settle to click, without pressing at the exact moment. Need time to decide? Tap it again to pause without a click, then resume when ready. Keep moving naturally between actions: aim, settle, click, move again.
  Bottom
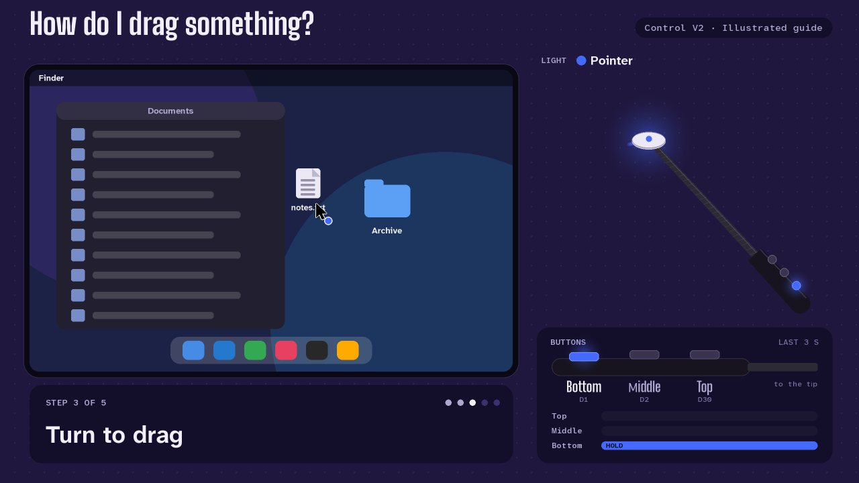
[picture p156: docs/how-to/videos/drag.jpg]
-  0:16

## How do I drag something?

  Tap the mouse button, then hold the second press to drag; release to drop.
  Bottom
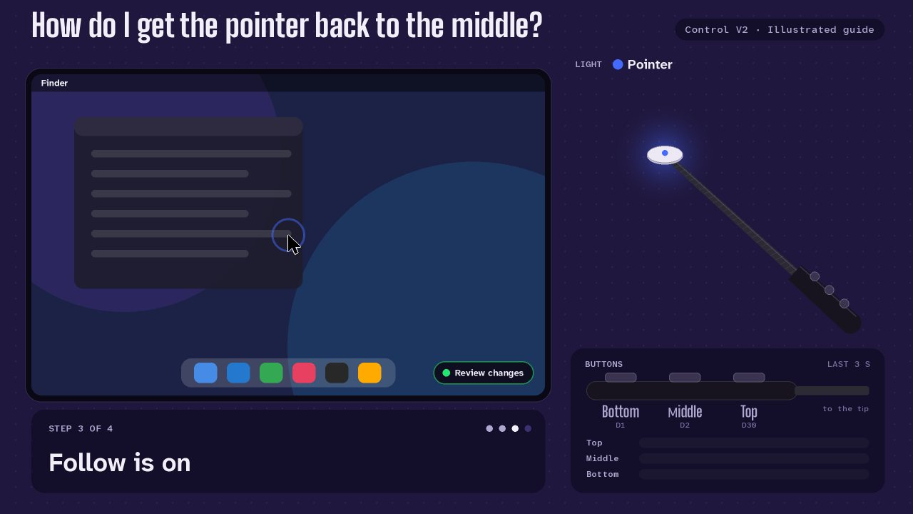
[picture p157: docs/how-to/videos/recenter.jpg]
-  0:12

## How do I get the pointer back to the middle?

  Double tap the mouse button to centre the pointer with mouse follow on.
  Bottom
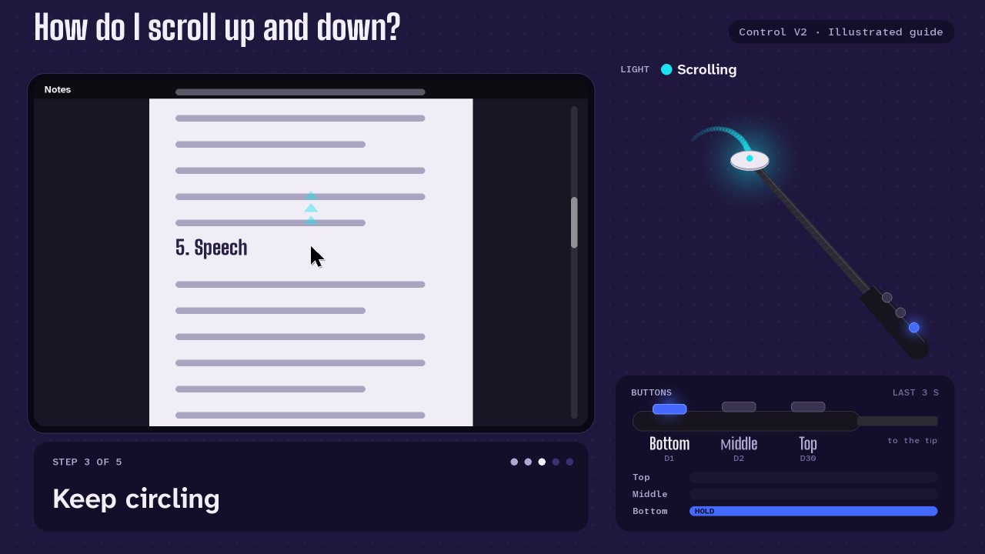
[picture p158: docs/how-to/videos/scroll-up-down.jpg]
-  0:19

## How do I scroll up and down?

  Hold the mouse button, move up or down, then keep circling; release to stop.
  Bottom
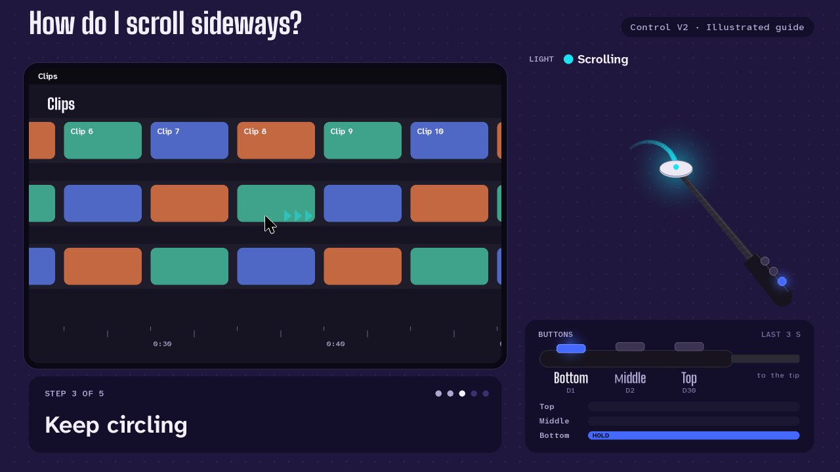
[picture p159: docs/how-to/videos/scroll-sideways.jpg]
-  0:15

## How do I scroll sideways?

  Hold the mouse button, start left or right, then keep circling; release to stop.
  Bottom
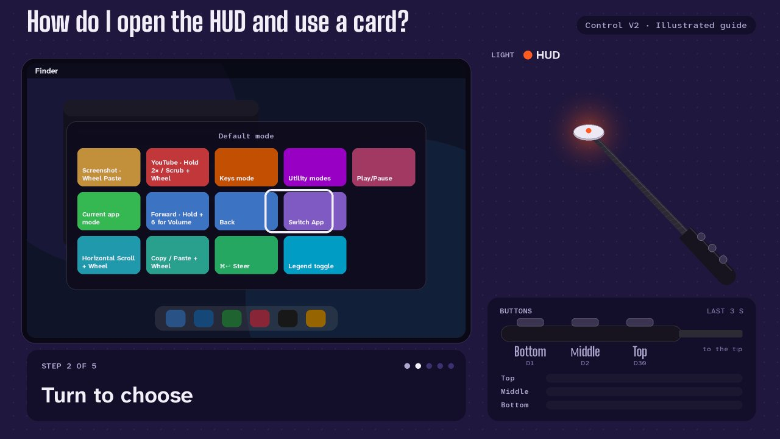
[picture p160: docs/how-to/videos/hud-cards.jpg]
-  0:20

## How do I open the HUD and use a card?

  Tap the HUD button, turn to a card, tap to use it; double tap to close.
  Middle
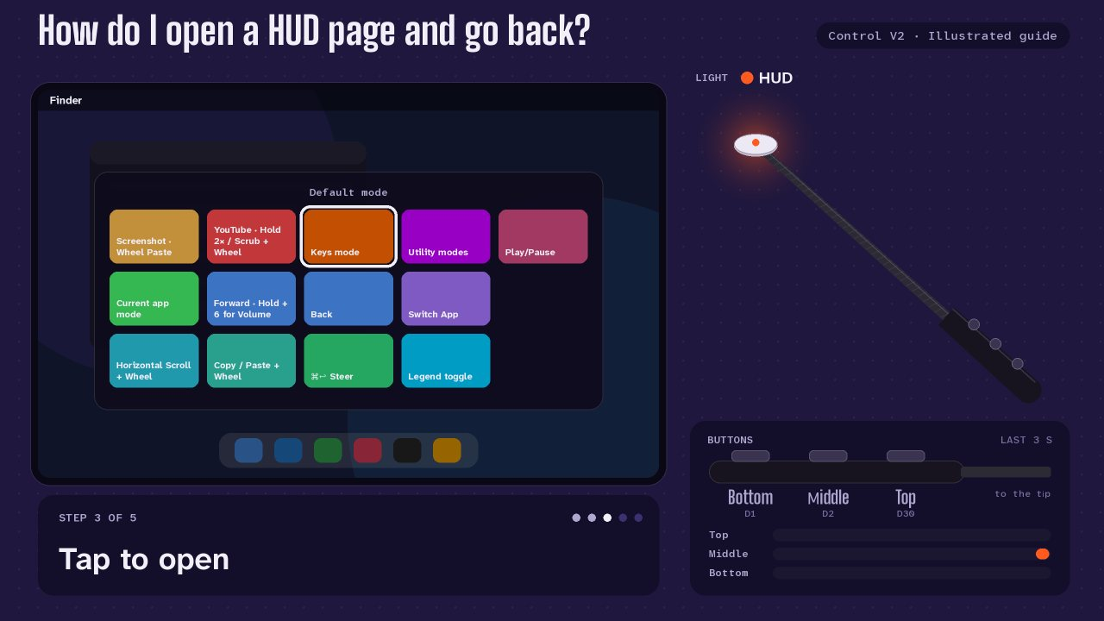
[picture p161: docs/how-to/videos/hud-pages.jpg]
-  0:17

## How do I open a HUD page and go back?

  Tap the HUD button on a page card; its exit card goes back one page.
  Middle
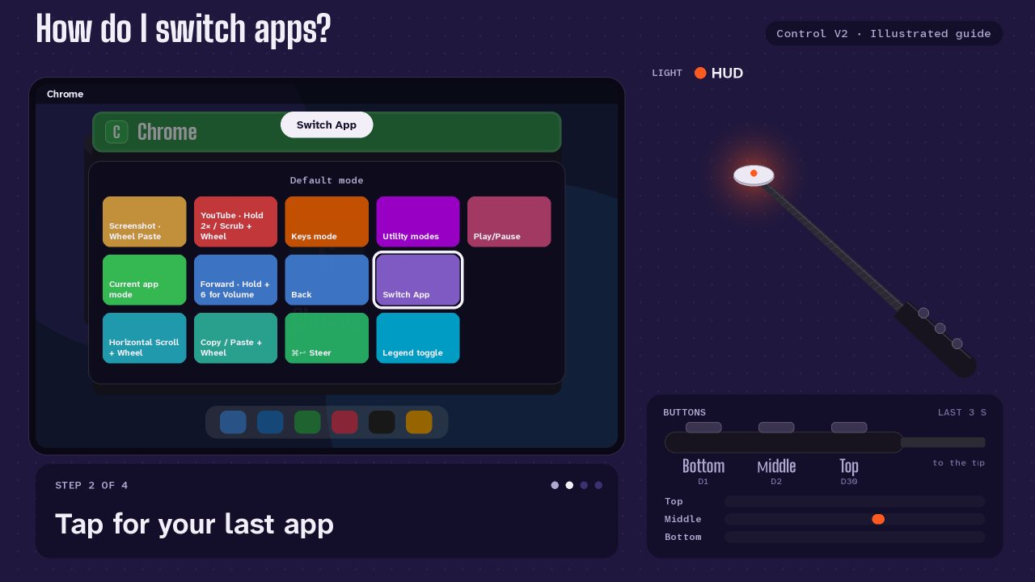
[picture p162: docs/how-to/videos/switch-apps.jpg]
-  0:15

## How do I switch apps?

  Tap Switch App for your last app, or hold and turn to pick one.
  Middle
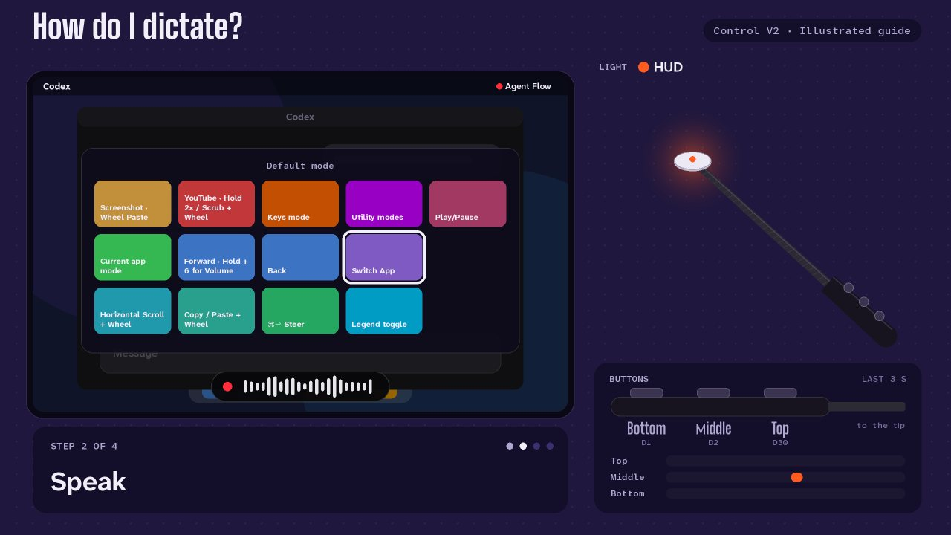
[picture p163: docs/how-to/videos/dictate.jpg]
-  0:18

## How do I dictate?

  Tap the speech button to start Agent Flow and tap again to stop and paste.
  Top
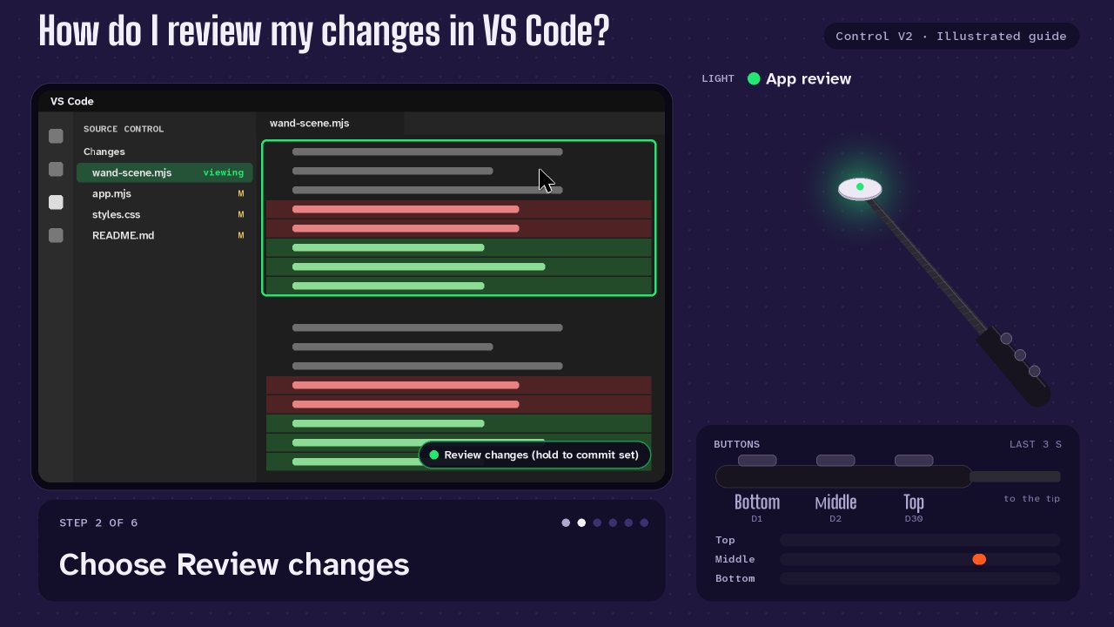
[picture p164: docs/how-to/videos/review-changes.jpg]
-  0:36

## How do I review my changes in VS Code?

  Choose Review changes, quarter-turn through changes, hold the HUD button to stage the set.
  Middle
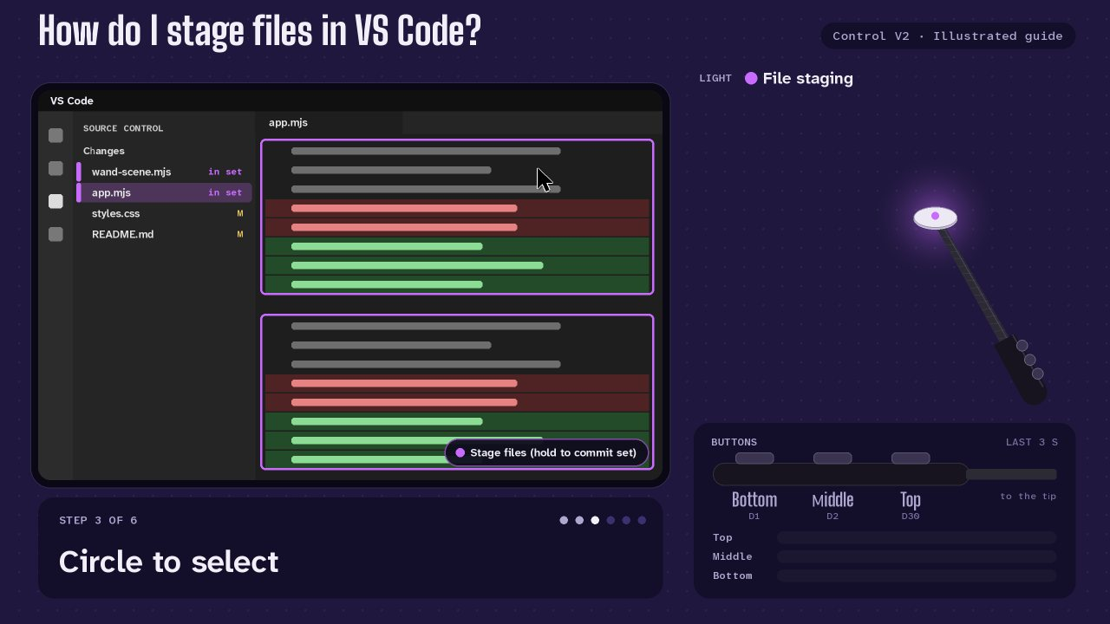
[picture p165: docs/how-to/videos/stage-files.jpg]
-  0:32

## How do I stage files in VS Code?

  Choose Stage files, circle to build a set, hold the HUD button to stage it.
  Middle
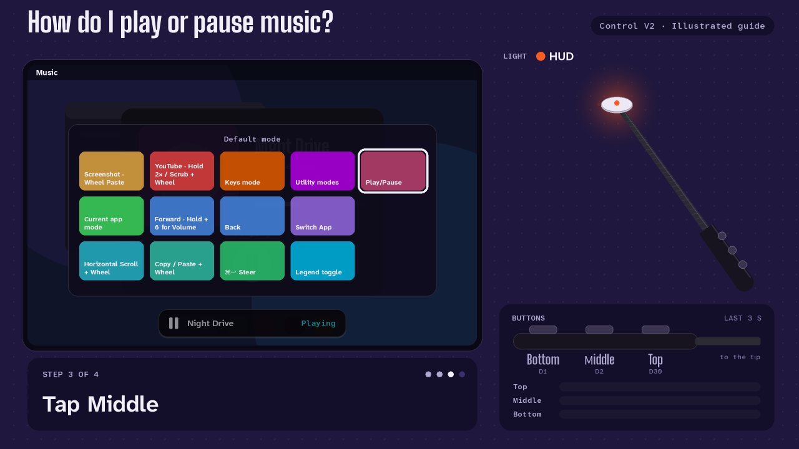
[picture p166: docs/how-to/videos/play-pause.jpg]
-  0:15

## How do I play or pause music?

  Open the HUD and use Play/Pause, right of Utility on the top row.
  Middle

No videos found. Try a button name or a shorter action.

## Using nods and shakes for review?

The review videos show the default circles and nudges. With Options → Review with nods and shakes on, move up and down for next, or side to side for previous. Each clear change of direction makes one step. Entry, exit and holding Middle to stage the set work the same way.

Close ×

TranscriptDownload videoLink to this guide

Magic Wand Ethan’s setup ↗ (https://ethansk.github.io/ethan-setup/) Agentic Mouse ↗ (https://ethansk.github.io/agentic-mouse/) Agent Flow ↗ (https://ethansk.github.io/AgentFlow/) GitHub ↗ (https://github.com/EthanSK/magic-wand)

All the wording on this website is AI generated, so sorry if it’s cringe.
