EthanSK/magic-wand/magic-wand/hardware/carbon-rod-holders/assembly/index.html

Magic Wand · Assembly

Drag to rotate · Scroll or pinch to zoom · Option-scroll to roll

# Wand Assembly

Version Component Assembly view

Compare cap heights Show mechanism Hide annotations

Parts and colours

## View

RotatePanZoom

+−Reset view

Scroll rotates (wand override)

Dimensions are in millimetres. Actual solder, wires and printed fit still need checking. Keep wires free and do not force a binding part.
