EthanSK/magic-wand/magic-wand/hardware/carbon-rod-holders-r13-printability/preview/index.html

Independent sliding modules · R13 · millimetres

Tip: green +Y axis

Drag to turn · Scroll or pinch to zoom

# Magic Wand Holders

Five keys, closer to the rod. Choose where the battery sits.

Key orientation

Battery above the keys, toward the tip. The grip stays below.

Battery side Extra space: 0 mm Parts Reference parts Keycaps Gate removed Scroll rotates (wand override)

## View

RotatePanZoom

+−Reset view

## Print estimate

Loading models…

Print prototype. Comfort, sliding grip and strength need a physical trial. The battery stays above the keys, with its small entry gate toward the tip. Lift the gate, slide the battery in, then replace the gate. Wires stay outside; USB faces the tip. Keep pressure off the battery pouch. Unplug or leave lead slack before moving modules; reorder from a bare tube end.

Bambu project
