EthanSK/magic-wand/magic-wand/hardware/printed-loop-wand/lattice-study/preview/index.html

# Lightweight Wand Variations

410 mm · V18–V20 mechanisms · PETG prototypes

V18 reference

Compare Hand Loop TurnMoveZoom−+Reset view

Loading models…

Drag or wand-scroll to turn · Pinch to zoom · Arrow keys use the selected tool

Slicer estimates compare one complete left wand, including its loop and three mounting plates. The V19 and V20 loops use 100% infill; earlier loops use 20%. Electronics, battery, bought switches, sockets, caps and wires are unweighed. Each complete print project also includes a right-hand stem. Physical strength, fit and comfort need testing.

Dimensions and checks

Diamond net, Open helix and Cross braced are separate open-frame experiments. Leaf shell retains the full V18 spiral strips. All retain the original joints, recessed switch seats, battery guides and detachable-loop lock. The reinforced options taper their wide bands towards the tip and use a smaller open sensor cradle with the existing retaining clip and board pockets. The one-shaft version has its own smaller tip connector; use its matching cradle. Fit and strength still need a physical test. The baseline remains unchanged.
