EthanSK/magic-wand/magic-wand/hardware/printed-loop-wand/shard-tube-r2/preview/index.html

# Magic Wand · Shard Tube R2

Integral switch seats · supported slide-in handle · open bottom-loading battery · interchangeable screw caps

Drag to rotate · scroll to zoom · right-drag to pan

## Loading checked CAD…

CAD and sliced paths are checked. Printed PETG fit, clip force and strength remain unverified. Print the small fit tests first. The 20 × 6 × 40 mm cell envelope is provisional.

Blue: printed wand. Teal: removable loop. Amber: screw cap / keeper. Black: purchased keycaps shown for scale. Purple: open battery sled. Physical openings are baked into the meshes. Only the unchanged cradle has clearly labelled print-support helpers in its print project. Bought parts are references.

Assembly and print instructions
