EthanSK/magic-wand/magic-wand/hardware/printed-loop-wand/v20/preview/index.html

# Magic Wand · Smooth wider handle · Both hands

Rounded 9 × 4 mm band · smooth flared ends · V19 stem compatible

Drag to rotate · scroll to zoom · right-drag to pan

## 410 mm overall

Helix and ventilated tapered body

Rounded diamond

Thin switch plates / battery rails

Previous V19 reference

410 mm overall. Main wire tunnel: 10.4 mm. The original raised helix, hollow shell, curved windows and rounded supporting rails remain. The removable finger loop is a rounded solid 9 × 4 mm band, flaring smoothly into the existing locking pads. Its lower mount remains 14 mm above the butt. The battery zone is oval; hand-contact depth is 5 mm slimmer than V18, unchanged from V19. Both axes slim above the cell.

Choose one lower shaft: the retained-handle version starts at 140 mm; the raised-button handle uses the shorter shaft starting at 160 mm. Do not mix them.

Battery guides remain provisional for a 20 × 6 × 40 mm cell, with a checked 20.4 × 6.4 × 42 mm clearance envelope. Keycaps: purchased 17.5 × 16.6 mm footprint, shown as black references; they are not printed parts. Board and battery are references. Open vents are not splash protection. PETG force, strength and printed fit need a small test.
