EthanSK/magic-wand/magic-wand/hardware/printed-loop-wand/v2/preview/index.html

# Magic Wand · Print V2

Print V2 · clipped board cradle · thumb mount clear of the loop · 340 mm

Drag to rotate · scroll to zoom · right-drag to pan

## 340 mm overall

Wand body and joints

Diamond head and cover

Socket keepers

Separate socket carriers

Sense board reference · blue

The 10.4 mm main tunnel feeds a clear 6 mm forward passage at the board cradle. Eight wires means: six button wires plus two battery wires. Branch outlets have an upright teardrop roof.

Battery fit is provisional. Reference cell: 20 × 6 × 40 mm; chamber: 22.6 × 9 × 49 mm. Measure the actual battery before printing the handle.

These are actual CAD meshes. Board, battery and keycap shapes are visual references. Physical snap, socket and print fit still need the small fit test.

Loading geometry…
