EthanSK/magic-wand/magic-wand/hardware/printed-loop-wand/v3/preview/index.html

# Magic Wand · Lightweight 410 mm

Smooth shafts · captured sliding cover · hollow handle · comparison with Print V2

Drag to rotate · scroll to zoom · right-drag to pan

## 410 mm overall

New smooth body

Rounded diamond

Compact socket inserts / battery rails

Original V2 reference

410 mm from butt to tip, 70 mm longer. Wire tunnel stays 10.4 mm. Long shaft spans have 1.6–2.6 mm walls, with local reinforcement at the twist locks.

Choose one lower shaft: the retained-handle version starts at 140 mm; the raised-button handle uses the shorter shaft starting at 160 mm. Do not mix them.

Battery guides remain provisional for a 20 × 6 × 40 mm cell. Keycaps: purchased 17.5 × 16.6 mm footprint, shown as black references; they are not printed parts. Board and battery are references. PETG spring force, strength and printed fit need a small test.
