EthanSK/magic-wand/magic-wand/hardware/carbon-rod-holders-r16-repair/exports/assembled-view.png

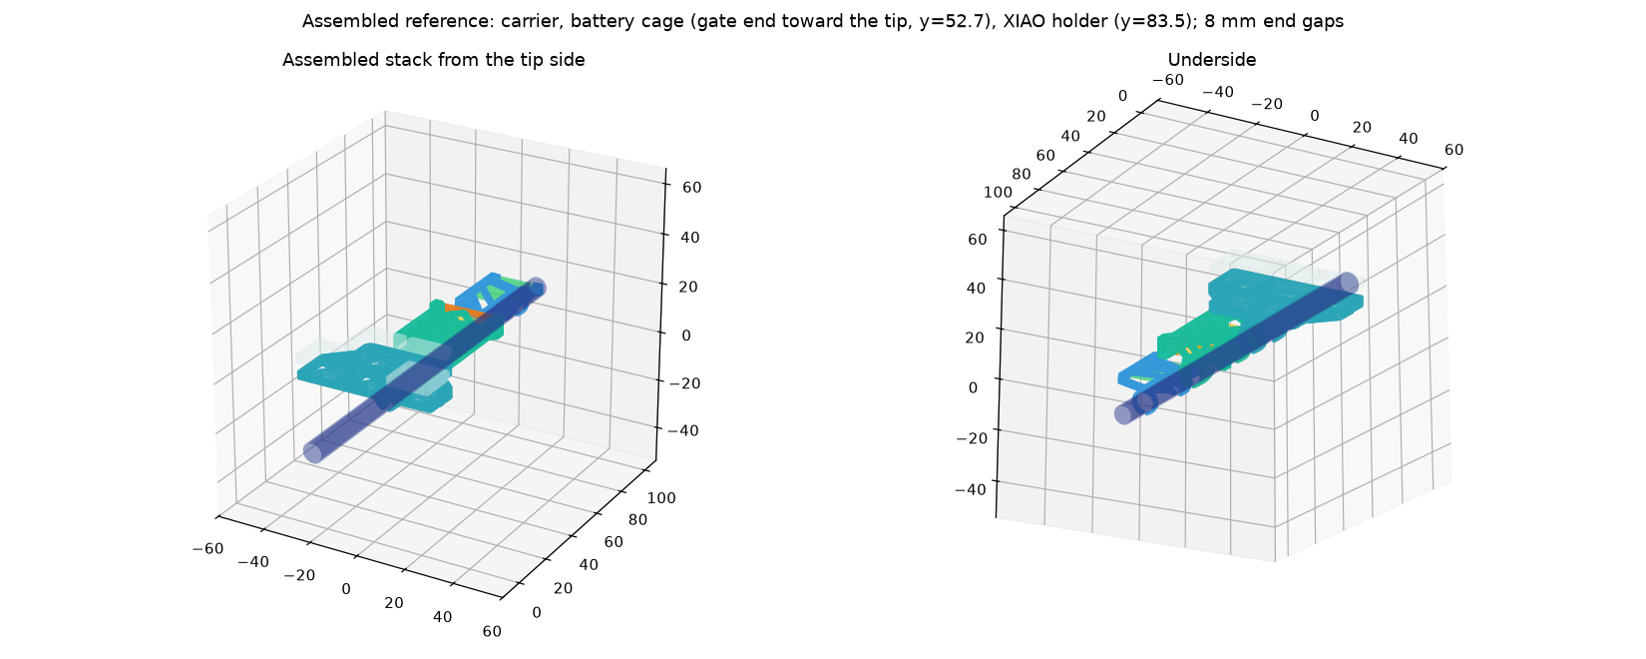
magic-wand/hardware/carbon-rod-holders-r16-repair/exports/assembled-view.png
