EthanSK/magic-wand/magic-wand/hardware/carbon-rod-holders-r17-anchored-repair/exports/assembled-view.png

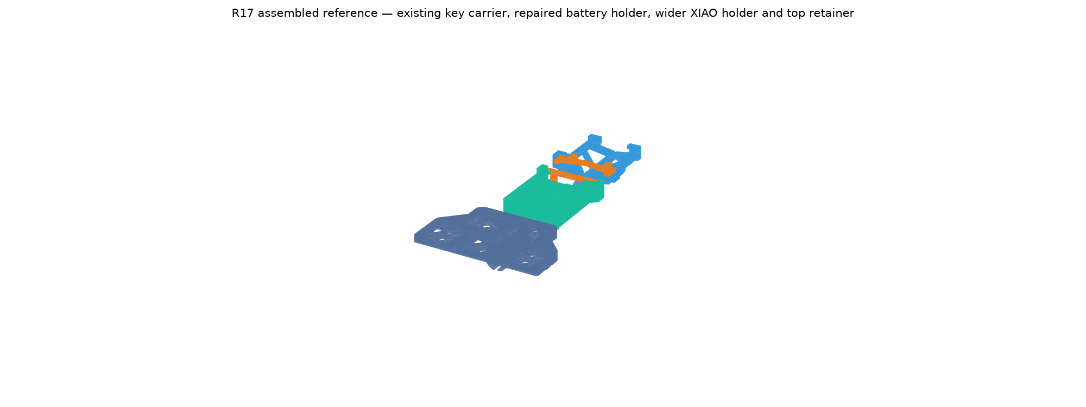
magic-wand/hardware/carbon-rod-holders-r17-anchored-repair/exports/assembled-view.png
