EthanSK/magic-wand/magic-wand/hardware/printed-loop-wand/long-solid-rod/preview/model.png

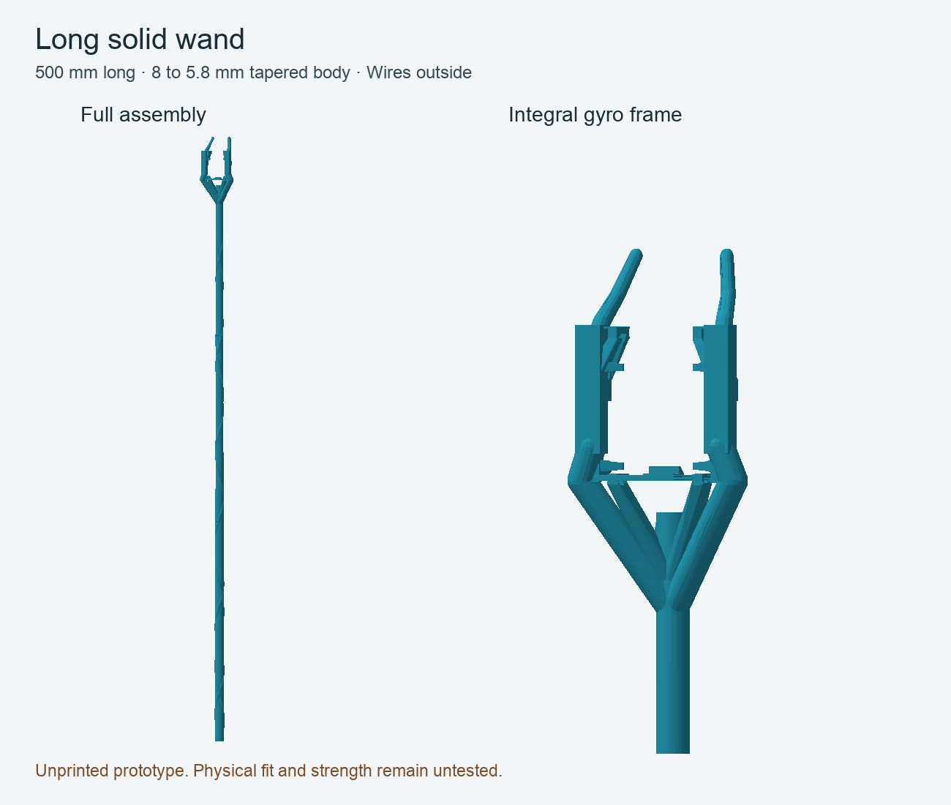
magic-wand/hardware/printed-loop-wand/long-solid-rod/preview/model.png
