EthanSK/magic-wand/control-stones/debug/README.md

# Control Stones sensor test

This test is isolated from the existing Magic Wand/Puck runtime. It reads the original XIAO nRF52840 Sense's built-in LSM6DS3 and external BMI160 sensors through a TCA9548A, over USB or Bluetooth. The viewer includes an optional hold-to-move pointer test; it never sends clicks.

## Firmware

`../firmware/imu_debug/imu_debug.ino` uses Seeed nRF52 core 1.1.13 and Seeed Arduino LSM6DS3 2.0.7. Compile for `Seeeduino:nrf52:xiaonRF52840Sense`.

The firmware samples roughly every 20 ms and sends motion JSON lines over open USB serial. The recovery build limits Nordic UART Bluetooth motion publication to 20 Hz, with a leading newline to recover framing after a failed notification. `ax`, `ay`, `az` are acceleration in g; `gx`, `gy`, `gz` are rotation speed in degrees per second; `ms` is the board clock. `sensor` is `hand` or `finger`; finger packets include the physical mux `channel`. Acceleration includes gravity. Rotation speed is not absolute orientation. Actual receive rate depends on the transport.

`finger_sensors.h` uses the external D4/SDA and D5/SCL bus (TWIM0), separate from the built-in IMU (`Wire1`). It selects one mux channel at a time, accepts BMI160 chip ID 0xD1 at 0x68 or 0x69, and checks configuration readback. `timed_i2c.h` bounds each external transfer wait to 20 ms and recovers the controller and bus on timeout; a failed external transfer must not block the built-in sensor indefinitely. Hand telemetry includes `i2c_timeouts` for diagnosis. Sensors run at 100 Hz with ±4 g and ±1000 degrees/s; telemetry is read at about 50 Hz. Missing channels are periodically rescanned. Power and wiring must follow the [wiring notes](../docs/wiring-notes.md); the driver cannot prove a correct physical connection from a label or a lit LED.

## Idle power mode

`firmware/imu_debug/motion_idle.h` tracks the complete assembly. After five seconds without a change of at least 0.0625 g on an acceleration axis or 3 degrees/s on a running gyro, it requests idle. Each sensor keeps its own resting acceleration reference, so gravity and small gyro offsets do not count as movement. The reference stays anchored until a threshold is crossed, allowing slow tilts to accumulate. Missing readings are never evidence of stillness. These are initial prototype thresholds, not measured gesture-detection limits.

In idle, `sense_power.h` puts the internal gyro in Sleep mode and its accelerometer at 12.5 Hz low power. `finger_sensors.h` suspends every connected BMI160 gyro and sets its accelerometer to 12.5 Hz with undersampling (four averaged samples). Both power configurations are read back; a failed finger is isolated and recovered without resetting healthy neighbours. Recovery during idle restores the idle configuration too.

The CPU task blocks between checks: 20 ms while active, 80 ms while idle. The built-in accelerometer can interrupt that wait; external accelerometers are polled because their interrupt pins are not wired. Any detected movement restores all connected gyros and the original active rates. BMI160 startup takes up to 80 ms; starts overlap across fingers instead of waiting 80 ms per finger. Pre-transition samples are discarded. Acceleration-only detection can miss sufficiently gentle rotation around gravity; pickup/gesture sensitivity and end-to-end latency need a hands-on test.

Bluetooth uses the existing Nordic UART connection and needs no system pairing. Advertising has no timeout. It stays connected during idle, with motion snapshots reduced from at most 20 per second per sensor to one per second, plus the one-per-second health packet. USB likewise sends one idle snapshot per second. Idle packets explicitly mark the gyro as asleep and show zero rotation, not stale gyro values. This saves sensing and payload activity; it is not complete power-off and does not eliminate Bluetooth connection events. Runtime gains require current measurements on the assembled hardware.

References: [Bosch BMI160 datasheet](https://www.bosch-sensortec.com/media/boschsensortec/downloads/datasheets/bst-bmi160-ds000.pdf), sections 2.4.1.2, 2.11.11 and 2.11.38; [ST AN5130](https://www.st.com/resource/en/application_note/an5130-lsm6ds3trc-alwayson-3d-accelerometer-and-3d-gyroscope-stmicroelectronics.pdf), sections 3.4, 3.5 and 5.2.

The new firmware identifies itself as `cs-assembly-sleep-20261026`. Compilation and host tests do not establish that it is installed: require this live health marker, fresh readings, then a physical rest/pickup test before claiming hardware acceptance.

Battery voltage uses the original Sense's battery ADC, a 3.0 V reference, 12-bit resolution and the 1 MΩ / 510 kΩ divider. The divider enable stays LOW, and charging current stays at the core's default 50 mA. `charging` reads the active-low charger-status input. Percentage is a heuristic voltage curve, not a measured capacity or runtime prediction; charging and load affect it. This is not a fuel gauge and cannot reliably distinguish a disconnected battery from a powered charger node.

## Viewer

Run `python debug/server.py` with Python, `pyserial`, and `bleak` installed, from the project folder. Open `http://127.0.0.1:8769/`. The server binds only to localhost, finds one Seeed USB device automatically, and scans for one device named Control Stones with the Nordic UART service. It leaves the original Sense bootloader (USB product ID 0x0045) alone so the uploader can own its serial port. It prefers fresh Bluetooth samples, falls back to USB, reconnects after removal, rejects invalid samples, and marks stale data instead of displaying it as live. Multiple matching Bluetooth devices are not selected arbitrarily.

Install the Python dependencies from `debug/requirements.txt` in a virtual environment. The page, receiver and firmware are retained project source, not temporary generated previews.

Toolchain downloads and builds for this session are on the SD card under `AgentScratch.noindex/control-stones-debug/`, including the Python environment and Arduino CLI configuration. Source stays here. No existing Wand or Puck source was modified.

## Current verification

- Firmware compilation passed; 50,680 bytes of flash and 7,696 bytes of RAM.
- USB enumeration confirmed the connected original Sense.
- Parser accepted a complete sample and rejected incomplete, non-object, non-finite, and boolean axes.
- The first upload did not receive a bootloader acknowledgement. A reported zero exit code from the vendor uploader did not mean a successful upload.
- After two quick presses of physical Reset and accepting the macOS accessory prompt, the device entered its bootloader (USB product ID 0x0045). The second upload reported `Device programmed`.
- Real six-axis samples were observed from the USB device and in the browser, with changing values and fresh timestamps.
- Bluetooth-and-battery firmware compiled (126,148 bytes flash / 14,552 bytes RAM) and uploaded successfully after detecting bootloader USB product ID 0x0045 and sending directly with the vendor uploader.
- Fresh Bluetooth samples and battery ADC readings were observed. The charge-status input reported charging with USB connected. Charging current, capacity and remaining runtime have not been measured. External sensors were not wired or verified at that earlier check.
- The subsequent sleep firmware compiled and uploaded successfully. Register readback confirmed the sleep configuration and real telemetry reported the hardware Idle state.

## Finger channels and mouse test

To avoid the multiplexer pins on the opposite side: thumb uses SD2/SC2, index SD3/SC3, middle SD4/SC4, ring SD5/SC5 and little SD6/SC6. Channels 0, 1 and 7 are unused. The firmware, viewer and wiring diagram use this mapping.

The default viewer shows all six sensors together: the internal Sense sensor and external channels 2–6. Every card has its own rotation and acceleration values and history; matching graphs share their vertical range across all six cards. External sensors are labelled by channel rather than assuming they are already mounted on fingers. The independent Mouse sensor selector chooses which of the six sensors controls the optional pointer test without hiding any cards. Select a **Mouse sensor**, keep it still and choose **Calibrate while still**. Calibration averages 50 readings; a hand sensor already in idle sends fewer readings. Adjust the horizontal/vertical axes and their inversion to suit the actual mounting. Hold **Hold to move mouse**, or hold Space/Enter while that button is focused. Release, lose focus, or stop renewing the hold for 0.6 seconds to stop movement. Fresh packets are required; duplicate USB/BLE packets, stale gaps and device-clock resets do not replay movement. A local per-run token protects mouse commands against unrelated websites. The reader's Python needs macOS Accessibility access; the page reports when it is unavailable without prompting or changing settings.

The BMI160 build compiled (129,292 bytes flash / 14,624 bytes RAM). Eight host tests cover packet validation, channel numbering, calibration, hold expiry, duplicate/stale samples, connection status, bootloader exclusion and command access. The firmware upload reported `Device programmed`; the installed build then sent changing six-axis thumb readings on channel 2 over Bluetooth, alongside the built-in hand sensor. The browser displayed both as live, and a brief hold/release test returned pointer control to off. The user's preferred pointer directions, calibration and battery-only operation with this build still need hands-on acceptance. Only one external sensor was connected; channels 3–6 have not been physically tested. Uploading this build over Bluetooth is not implemented. Earlier verification above describes the previous hand-only installed build.

The subsequent guarded-I2C build compiled at 130,580 bytes flash / 14,632 bytes
RAM and uploaded with `Device programmed`. Both the internal and channel-2
external streams were observed together over Bluetooth after installation;
Ethan confirmed the comparison working. Ten host tests now include simulated
stalled transfers and recovery. This is the working Control Hand snapshot in
the component README. The exact original stall cause remains unproven;
timeout counts are diagnostics, not proof of a particular wiring fault.

## All-sensor dashboard — 26 October 2026

The default dashboard now shows the internal sensor and all five external
channels together, with independent values and history. All six streams were
observed live over Bluetooth in the desktop and in-chat views. The mouse test
retains its separate sensor choice and remains off until deliberately held.

## Finger recovery revision — 26 October 2026

The old driver retained a detected sensor's address when data-ready stayed
clear indefinitely. Periodic discovery skipped that cached address, so an
acknowledging sensor that lost its sampling configuration could remain silent.
The host regression reproduces this failure with the old driver and passes
with the revision. This is a verified software fault, not proof of what caused
an interruption on a particular physical assembly.

The revised driver invalidates a sensor after one second without measurements,
reconfigures missing/stale sensors independently, and deselects the mux after
each configuration/read attempt. It makes at most one reconfiguration per scan
pass. Healthy sensors are not reset merely because another finger is stale.

One `sensor: health` packet per second identifies firmware
`cs-recovery-20261026`, the five channel states, successful reinitialisation
counts, external I2C timeouts and failed Bluetooth writes. Channel states are
0 missing, 1 live, 2 no fresh measurements, 3 bus error, 4 configuration failure,
5 ambiguous addresses, and 6 starting. The reader exposes fresh diagnostics as
`health` in `/api/sample`; diagnostics never become motion packets or move the
pointer. A null health field means no recent diagnostic packet was received.

Local regression checks and firmware compilation passed. Physical acceptance
must require this firmware marker plus fresh readings; compilation or an
uploader's zero exit status is insufficient. A physical short, absent power or
unreachable sensor cannot be repaired by retrying software.

For authorised uploads, the reader's optional `--resume-file PATH` keeps HTTP
available but postpones USB/Bluetooth ownership until that new signal file
exists. The six-sensor dashboard can remain open while the uploader owns the
USB port. The bootloader port remains excluded from normal serial reading.
