EthanSK/magic-wand/docs/how-to/transcripts/review-changes.txt

How do I review my changes in VS Code?

In VS Code, tap Middle to open the HUD. Review changes is just right of Switch App.
Outline it and tap Middle. The HUD hides, the light turns green and review starts.
With no button held, a clockwise quarter-turn goes to the next change. Turn anticlockwise to go back one.
Up to right moves forward one. Right to up moves back one. A full circle moves four changes.
Files you finish join the set. Hold Middle for about half a second to stage them and keep reviewing.
Tap Middle once to cancel and leave review.

Steps:
1. Open the HUD
2. Choose Review changes
3. Turn to move
4. Quarter-turn to step
5. Hold Middle to stage
6. Tap Middle to exit
