EthanSK/magic-wand/magic-wand/debug/index.html

Skip to activity

Magic Wand Monitor

Starting

# Checking

Reading Wand Receiver’s status.

Wand Receiver

—

Last event

—

## Buttons

### Speech button

### HUD button

### Mouse button

## Sleep

1. AwakeLight shows the mode
2. 1 min on the desk
3. Desk idleLights off · pickup wakes
4. 5 min on the desk
5. Deep sleepBluetooth off · grip button wakes

## Light

—

## Motion Data

—

Measured by Wand Receiver after 5 s of continuous movement. How often updates arrive, not how long they take.

## Settings

## Receiver

## Errors

Earlier errors

## Activity

## Diagnostics

### Status

—

### Recent log lines

—

Read-only. Reads Wand Receiver’s status and log on this Mac; never connects to the wand.
