EthanSK/magic-wand/magic-wand/hardware/carbon-rod-holders-r16-repair/preview/index.html

Independent sliding modules · R16 test prototype · millimetres

Tip: green +Y axis

Drag to turn · Scroll or pinch to zoom

# Magic Wand Holders

Three keys below, two above. Battery and XIAO toward the tip.

Key orientation

Battery above the keys, toward the tip. The grip stays below.

Battery side Extra space: 0 mm Parts Reference parts Keycaps Gate removed Scroll rotates (wand override)

## View

RotatePanZoom

+−Reset view

## Print estimate

Loading models…

Test prototype. Measure a mounted keycap before printing. The XIAO holder assumes no underside pin headers and wires soldered on top. Keep solder bumps clear of the corner supports and confirm your board before printing it. Comfort, sliding grip and strength need a physical trial.

Fit and tape the insulated sockets before sliding the carrier onto the rod. Support each socket from below while pressing in its switch. Tape the XIAO board to its rails.

The battery gate faces the tip. Lift the gate and insert the non-lead end first, with the leads trailing through the opening, then replace the gate. Wires stay outside; USB faces the tip. Keep pressure off the pouch. Unplug or leave lead slack before moving modules; reorder from a bare tube end.

A1 mini PETG test project
