EthanSK/magic-wand/magic-wand/hardware/carbon-rod-holders-r16-repair/exports/Battery_End_Gate-layer-views.png

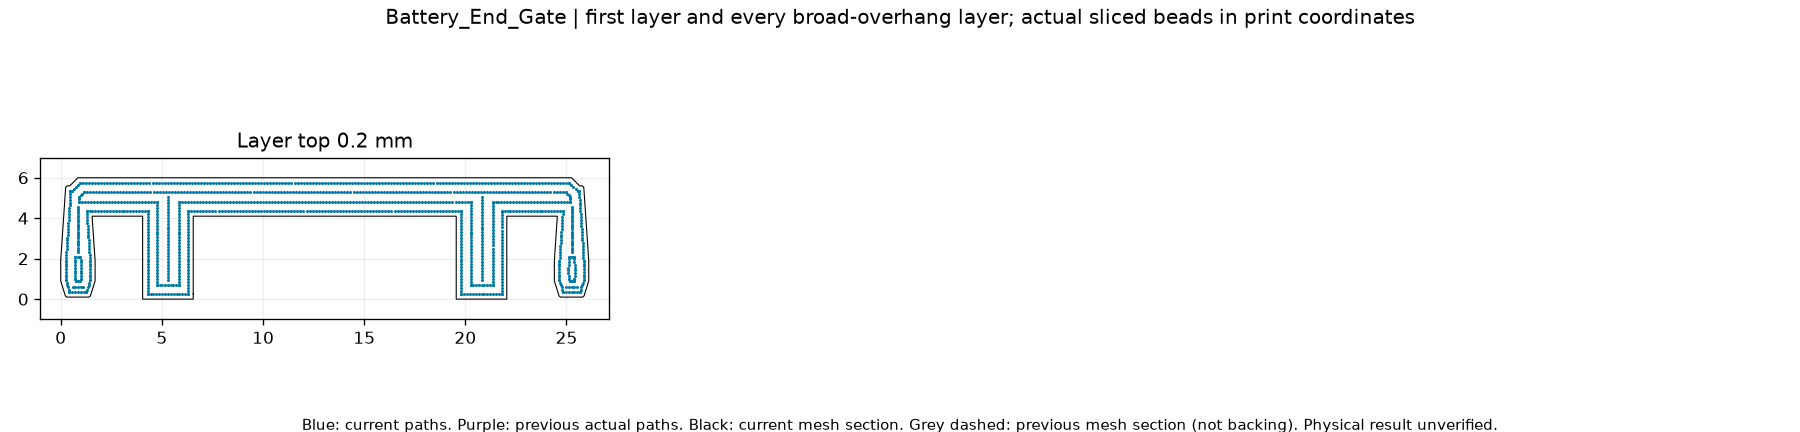
magic-wand/hardware/carbon-rod-holders-r16-repair/exports/Battery_End_Gate-layer-views.png
