EthanSK/magic-wand/magic-wand/hardware/carbon-rod-holders-r16-repair/exports/Battery_Holder-layer-views.png

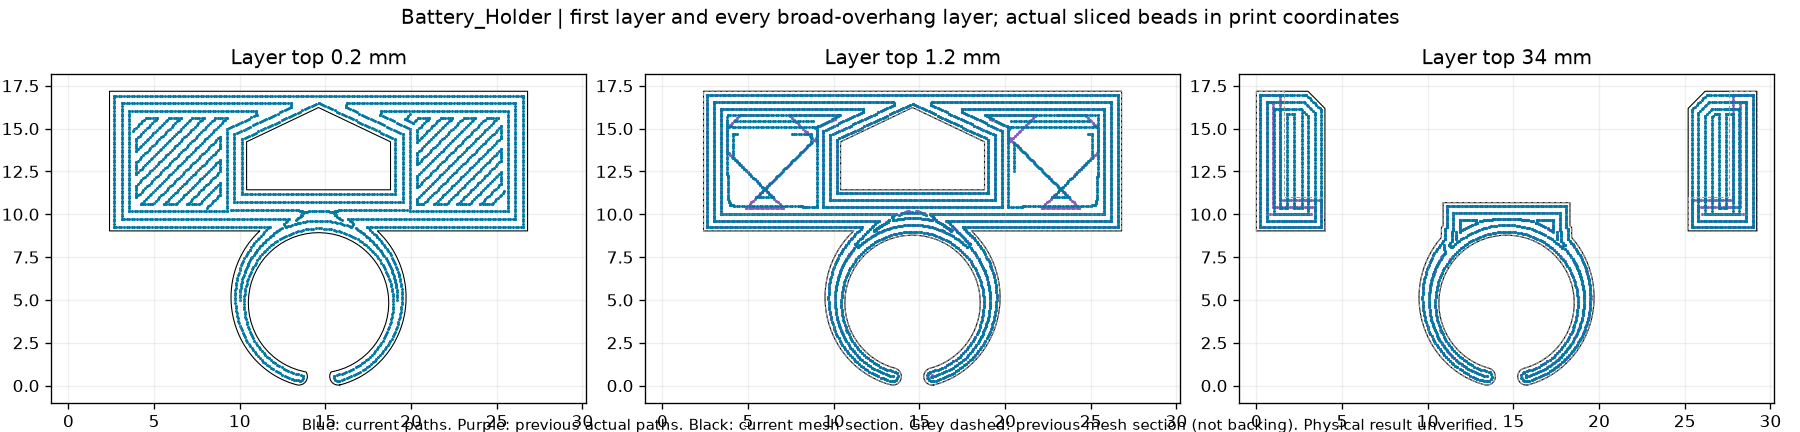
magic-wand/hardware/carbon-rod-holders-r16-repair/exports/Battery_Holder-layer-views.png
