EthanSK/magic-wand/magic-wand/hardware/carbon-rod-holders-r16-repair/exports/Key_Carrier-layer-views.png

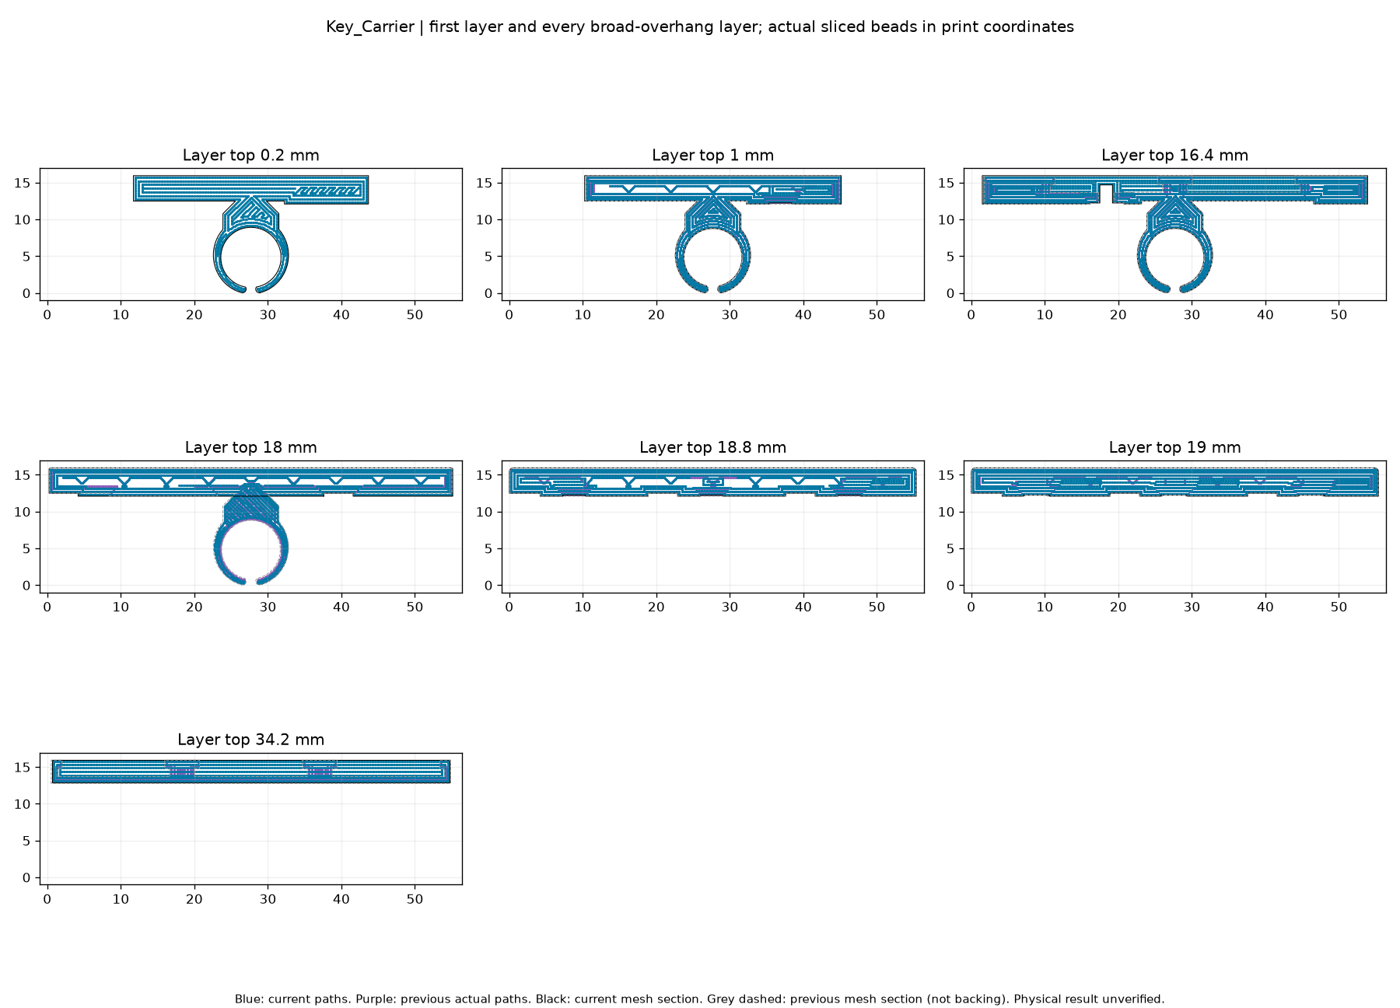
magic-wand/hardware/carbon-rod-holders-r16-repair/exports/Key_Carrier-layer-views.png
