EthanSK/magic-wand/magic-wand/hardware/carbon-rod-holders-r16-repair/exports/layout-views.png

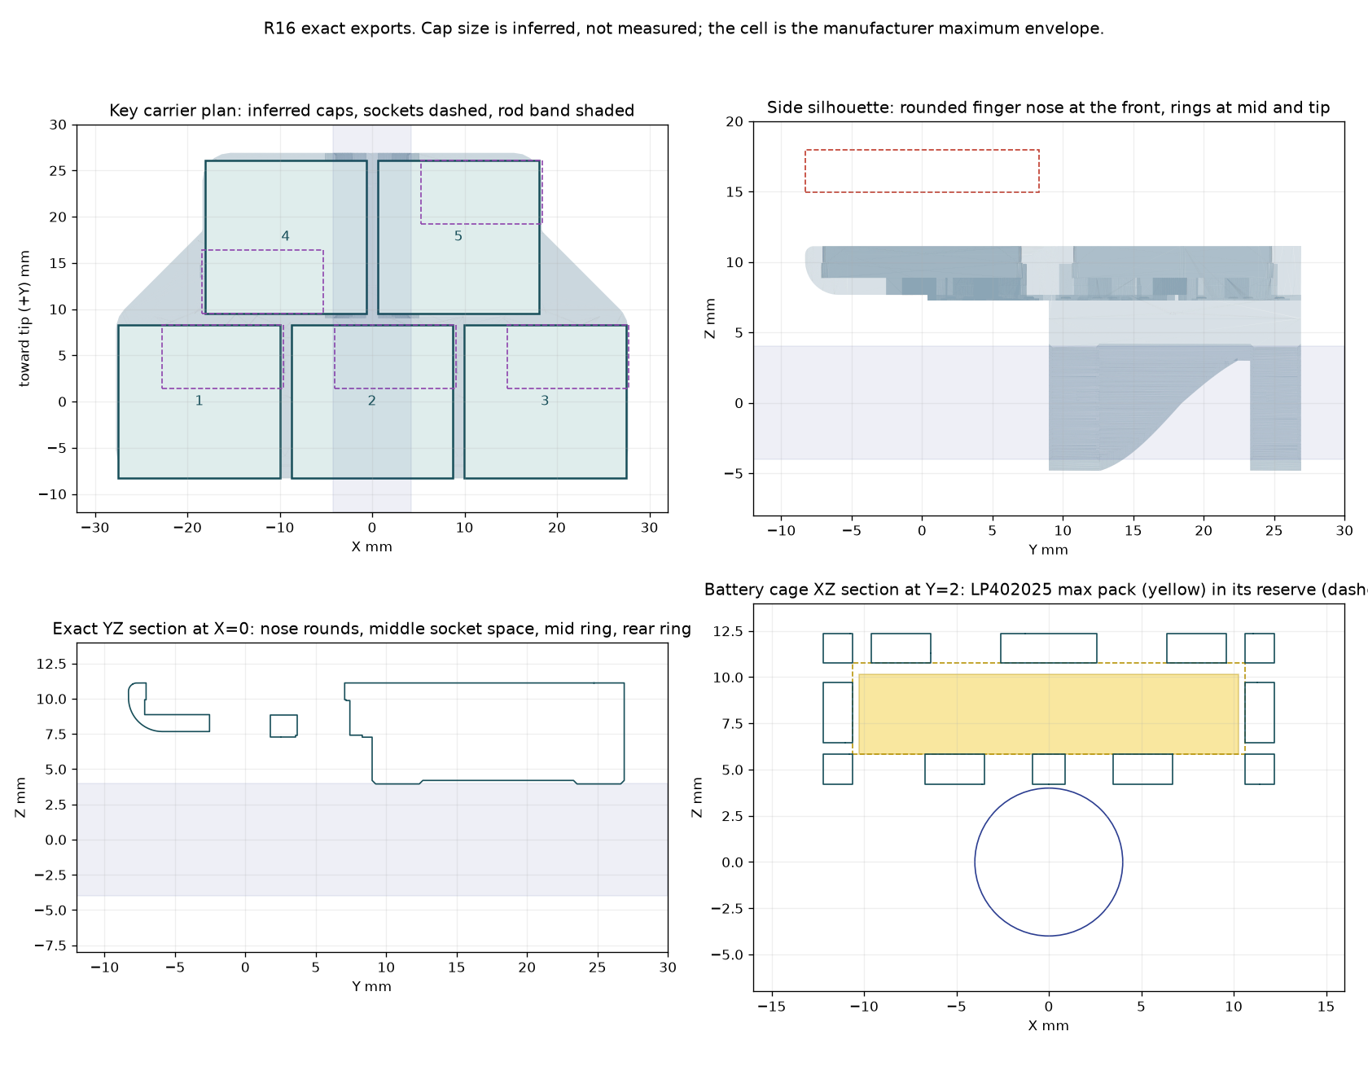
magic-wand/hardware/carbon-rod-holders-r16-repair/exports/layout-views.png
