EthanSK/magic-wand/magic-wand/hardware/carbon-rod-holders-r16-repair/exports/XIAO_Rod_Holder-layer-views.png

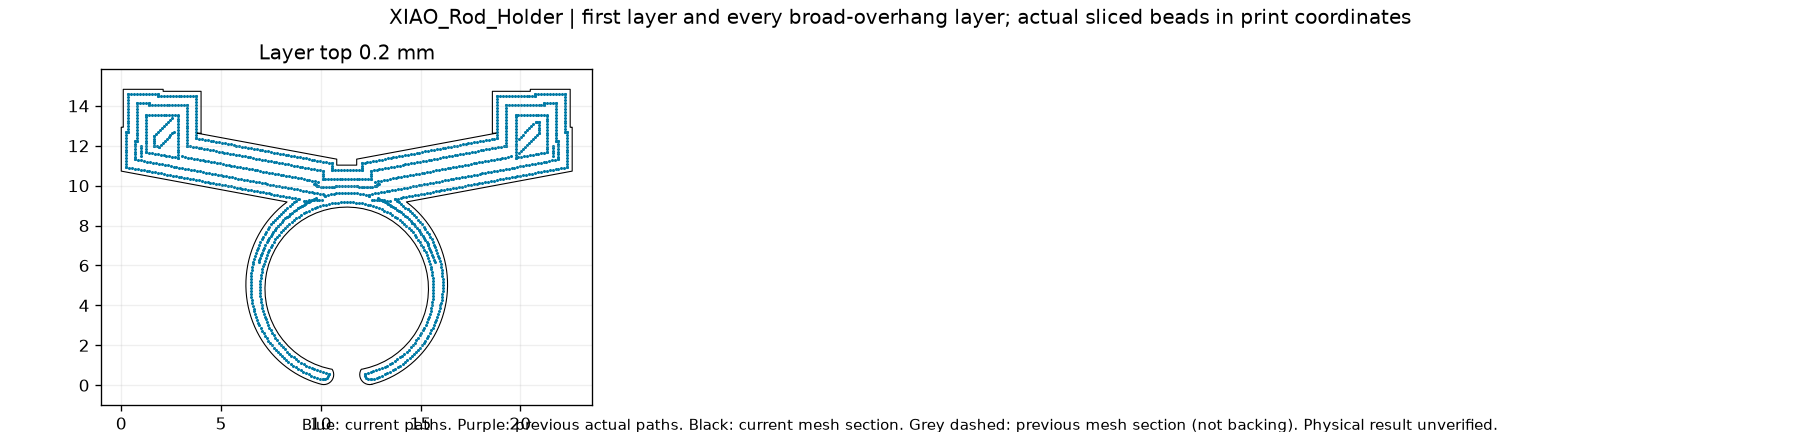
magic-wand/hardware/carbon-rod-holders-r16-repair/exports/XIAO_Rod_Holder-layer-views.png
