EthanSK/magic-wand/magic-wand/hardware/carbon-rod-holders-r17-anchored-repair/exports/Battery_Holder-layer-views.png

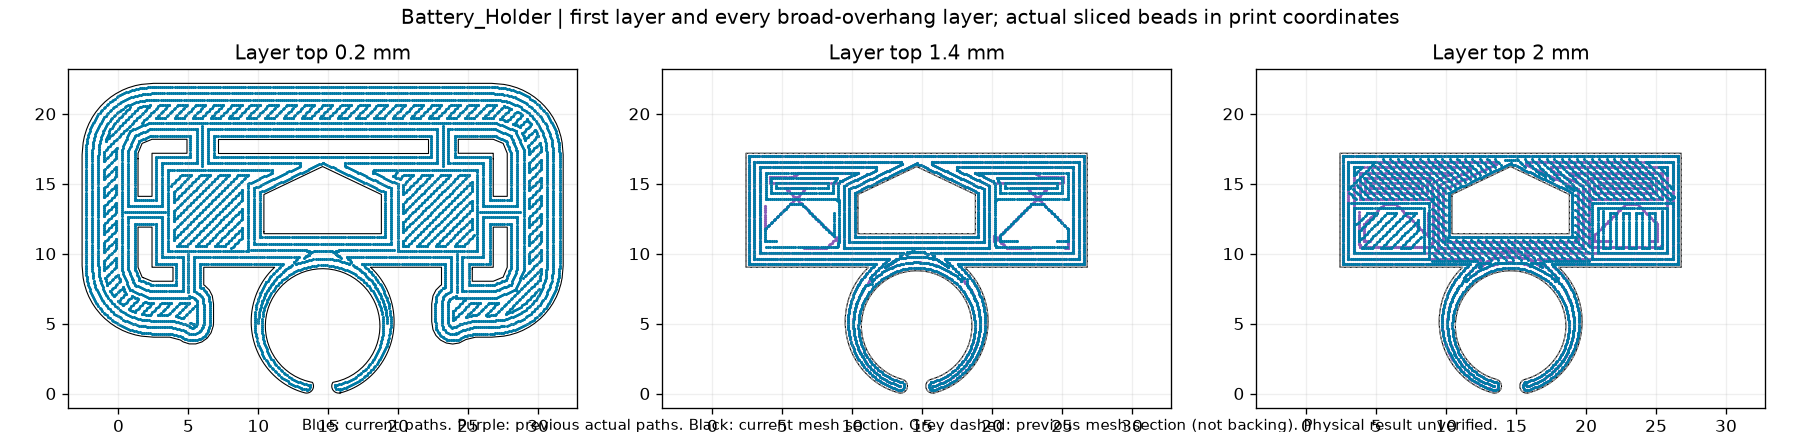
magic-wand/hardware/carbon-rod-holders-r17-anchored-repair/exports/Battery_Holder-layer-views.png
