EthanSK/magic-wand/magic-wand/hardware/carbon-rod-holders-r17-anchored-repair/exports/XIAO_Top_Retainer-layer-views.png

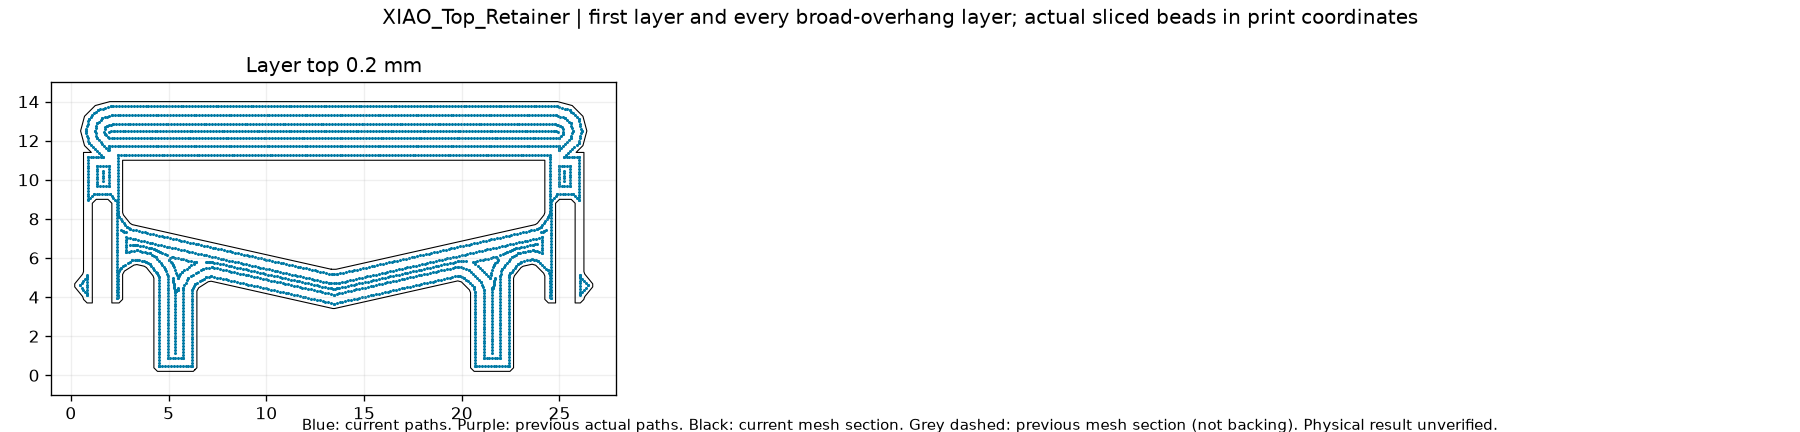
magic-wand/hardware/carbon-rod-holders-r17-anchored-repair/exports/XIAO_Top_Retainer-layer-views.png
