EthanSK/magic-wand/(commit log)

2026-10-16 Prepare Magic Wand source and interactive project website
    Publishable source snapshot, shared device simulation, maintained controls manifest and setup documentation. Browser verification and external publication remain pending.
2026-10-16 Resume HIGH after LOW release click and suppress resting pointer jitter
    [wand-mode-bridge.js]
2026-10-16 Shorten release pause to 300 ms and resume HIGH after dragging
    [wand-mode-bridge.js]
2026-10-16 Preserve slow aiming intent and shorten gesture timing
    [wand-mode-bridge.js]
2026-10-16 Record installed horizontal app switcher and verification
2026-10-16 Keep 104 Hz pointer updates efficient and verify update readiness
2026-10-16 Reduce motion overhead and retain wide UART travel
    Keep the accepted exponential filter and held-only buffer. Restore the earlier perceived-orange LED mix and allow recovery from incomplete bridge loads.
2026-10-16 Move pointer filtering to the Mac and restore immediate held aiming
2026-10-16 Recognize table rest at the idle sensor rate and retain its reference
2026-10-16 Preserve Prototype V1 and recognize resting wand across poses
2026-10-16 Record confirmed Prototype V1 pickup and put-down
2026-10-18 Honor Puck upload flow control to prevent dropped code
2026-10-18 Fix wand recovery, orange status lights and visible review selection
    [wand-mode-bridge.js]
2026-10-18 Stage review sets on hold and preserve submenu navigation
2026-10-19 Add desk sleep, redesign review corners and capture diagnostic traces
    [wand-mode-bridge.js]
2026-10-19 Preserve bottom-centred wand HUD placement above Agent Flow
2026-10-24 Add isolated Control Stones sensor prototype
2026-10-24 Keep prototype recovery checkout outside the monorepo
2026-10-24 Clarify BMI160 wiring and allow clearing diagram selection
2026-10-24 Restore per-device calibration and add button-wake standby
2026-10-24 Format calibration recovery notes
2026-10-24 Persist the complete wand firmware and calibration at startup
2026-10-24 Keep passive Switch App navigation separate from held controls
2026-10-24 Install pinned device compiler before CI checks
2026-10-24 Require distinct insulation colours for Control Stones wiring
2026-10-24 Record installed dotted Switch App hold feedback
2026-10-24 Add printable wand with interchangeable loop handles
    [button-pod-blank.stl, button-pod-pilot.stl, coupon-female-a.stl, coupon-female-b.stl, coupon-female-c.stl, coupon-male.stl, coupon-puck-ring.stl, handle-angled.stl]
2026-10-24 Keep local task ledgers outside public source checks
2026-10-24 Measure desk-rest duration from the current rest event
2026-10-24 fix(control-stones): match wire colours to current assembly
2026-10-24 Share HIGH sensitivity with Switch App and persist complete firmware
2026-10-24 Add rounded quick-print wand handle and slicer guidance
    [handle-straight.stl]
2026-10-24 Release orphaned wand drags and reject late button frames
2026-10-24 Add XIAO tip and swappable handle comparison
    [tip-xiao.stl]
2026-10-24 Make the printed wand viewer respond to wand controls
2026-10-24 Restore the full-hand mug loop and omit the XIAO button pod
2026-10-24 Use Opus for wand CAD design
2026-10-24 Add tapered double-helix wand with a thumb button shelf
    [coupon-tapered-female.stl, coupon-tapered-male.stl, handle-tapered-smooth.stl, handle-tapered-spiral.stl, shaft-lower-tapered-smooth.stl, shaft-lower-tapered-spiral.stl, shaft-upper-tapered-smooth.stl, shaft-upper-tapered-spiral.stl]
2026-10-24 Widen tapered wand shelf into a flat top platform
    Keep both tapered variants, two helix strands and a central wire path. Verify left, centre and right top surfaces plus symmetry, mesh closure and legacy exports. CAD/viewer tests pass (16); full suite currently fails in concurrently edited native receiver tests, outside this change.
    [handle-tapered-smooth.stl, handle-tapered-spiral.stl]
2026-10-24 Publish shared Bambu print projects for the tapered wand
    Add an easy-to-find magic-wand-3d-models folder with spiral and smooth 3MFs, assembly notes, saved P1S/PETG settings and a reproducible generator. Verify freshness and archive privacy in the normal test suite.
    [machine.json, tapered-double-helix.3mf, tapered-smooth.3mf]
2026-10-24 Cross the wand spiral ribs and refresh the live model view
    Wind the two ridges in opposite directions, verify actual crossings, keep fixed plate spacing clear of supports, and reload local CAD exports while preserving the camera. Full repository checks pass.
    [handle-tapered-spiral.stl, shaft-lower-tapered-spiral.stl, shaft-upper-tapered-spiral.stl, tapered-double-helix.3mf, tapered-smooth.3mf]
2026-10-24 Prepare original and tighter mirrored spiral print variants
    Freeze the first 110 mm-pitch print and make the current crossing pattern 90 mm pitch. Derive geometry samples from pitch and preserve the original print checksum. Full local checks pass; printer jobs remain pending Bambu sign-in and device connection.
    [Print-1-crossed-110mm.3mf, handle-tapered-spiral.stl, shaft-lower-tapered-spiral.stl, shaft-upper-tapered-spiral.stl, tapered-double-helix.3mf, tapered-smooth.3mf]
2026-10-24 Add BMI160 finger telemetry and held mouse test
2026-10-24 Vary wand spiral pitches and retain Bambu infill settings
    [handle-tapered-spiral.stl, shaft-lower-tapered-spiral.stl, shaft-upper-tapered-spiral.stl, tapered-double-helix.3mf, tapered-smooth.3mf]
2026-10-24 Triple the wand spiral pitch difference
    [handle-tapered-spiral.stl, shaft-lower-tapered-spiral.stl, shaft-upper-tapered-spiral.stl, tapered-double-helix.3mf, tapered-smooth.3mf]
2026-10-24 Compare internal and external motion sensors side by side
2026-10-24 Add interchangeable spiral mug wand and combined print plate
    [handle-tapered-mug-spiral.stl, handle-tapered-spiral.stl, shaft-lower-tapered-spiral.stl, shaft-upper-tapered-spiral.stl, tapered-double-helix.3mf, tapered-mug-double-helix.3mf, tapered-smooth.3mf, two-spiral-wands.3mf]
2026-10-24 Working Control Hand snapshot: internal and external sensors over Bluetooth
2026-10-24 Add persistent three-button power toggle and sleep warning
2026-10-24 Wake manual wand standby with any grip button
2026-10-25 Add six-sensor Control Hand dashboard
    Show the main Sense and five finger sensors together in a three-column, two-row grid with acceleration and rotation traces. Share the existing telemetry reader through a read-only local viewer.
2026-10-26 Use negotiated Puck UART packet sizes
2026-10-26 Add Print V2 diamond mug wand sources and print projects
    [Battery_Sled.stl, Battery_Twist_Cap.stl, Choc_Socket_Carrier.stl, Choc_Socket_Keeper.stl, Fit_Test_Female.stl, Fit_Test_Male.stl, Handle_Left.stl, Handle_Right.stl]
2026-10-26 Shorten wand Switch App centre wait to 500 ms
2026-10-26 Add lightweight 410 mm Print V3 wand with compact raised buttons
    Preserve V2 and add an upper-only replacement for its printed handle. Add a hollow taller grip, compact recessed Choc inserts, slim bayonets and a rounded diamond with a captured sliding cover. Include portable CAD, meshes, PETG projects, comparison preview and geometric/sliced-path verification.
    [Battery_Sled.stl, Battery_Twist_Cap.stl, Choc_Socket_Carrier.stl, Choc_Socket_Keeper.stl, Existing_Handle_Left.stl, Existing_Handle_Right.stl, Fit_Test_Female.stl, Fit_Test_Male.stl]
2026-10-26 Restore tapered helix wand with hollow interiors and both handed grips
    [Battery_Sled.stl, Battery_Twist_Cap.stl, Choc_Socket_Carrier.stl, Choc_Socket_Keeper.stl, Existing_Handle_Left.stl, Existing_Handle_Right.stl, Fit_Test_Female.stl, Fit_Test_Male.stl]
2026-10-26 Replace wand button cassettes with thin top-loading plates
    [Battery_Sled.stl, Battery_Twist_Cap.stl, Button_Mount_Coupon.stl, Choc_Top_Slide_Plate.stl, Existing_Handle_Left.stl, Existing_Handle_Right.stl, Fit_Test_Female.stl, Fit_Test_Male.stl]
2026-10-26 Raise side buttons 14 mm on both Print V6 wand grips
    [Battery_Sled.stl, Battery_Twist_Cap.stl, Button_Mount_Coupon.stl, Choc_Top_Slide_Plate.stl, Existing_Handle_Left.stl, Existing_Handle_Right.stl, Fit_Test_Female.stl, Fit_Test_Male.stl]
2026-10-26 Recover stalled Control Hand finger sensors and report health
    Reinitialise sensors that acknowledge I2C but stop producing measurements, isolate mux channels between operations, and report firmware health separately from motion. Preserve healthy sensors while recovering stale fingers and bound Bluetooth publication load.
    Validation: repository-wide npm run check passed, including 171 Wand tests and 14 Control Stones tests. Recovery firmware compiled for the original XIAO nRF52840 Sense.
    Installation status: cs-recovery-20261026 is prepared but not installed on the test board. The updated host remains compatible with the older installed firmware; fresh health telemetry is required to confir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
    [finger_sensors.h, imu_debug.ino]
2026-10-26 Add slimmer ventilated V7 wand with 75.7 g PETG print estimate
    [Battery_Sled.stl, Battery_Twist_Cap.stl, Button_Mount_Coupon.stl, Choc_Top_Slide_Plate.stl, Existing_Handle_Left.stl, Existing_Handle_Right.stl, Fit_Test_Female.stl, Fit_Test_Male.stl]
2026-10-26 Correct V8 wand grip ergonomics and contact-facing ventilation
    [Battery_Sled.stl, Battery_Twist_Cap.stl, Button_Mount_Coupon.stl, Choc_Top_Slide_Plate.stl, Existing_Handle_Left.stl, Existing_Handle_Right.stl, Fit_Test_Female.stl, Fit_Test_Male.stl]
2026-10-26 Add solid-helix slotted wand with detachable upper-flared loop
    [Battery_Sled.stl, Battery_Twist_Cap.stl, Button_Mount_Coupon.stl, Choc_Top_Slide_Plate.stl, Existing_Handle_Left.stl, Existing_Handle_Right.stl, Fit_Test_Female.stl, Fit_Test_Male.stl]
2026-10-26 Add ribbed-shell wand with broad windows and clear loop vents
    [Battery_Sled.stl, Battery_Twist_Cap.stl, Button_Mount_Coupon.stl, Choc_Top_Slide_Plate.stl, Existing_Handle_Left.stl, Existing_Handle_Right.stl, Fit_Test_Female.stl, Fit_Test_Male.stl]
2026-10-26 Show all six Control Stones sensors by default
2026-10-26 Add whole-assembly idle and automatic wake for Control Stones
2026-10-27 Refine wand with curved leaf windows and fuller rounded rails
    [Battery_Sled.stl, Battery_Twist_Cap.stl, Button_Mount_Coupon.stl, Choc_Top_Slide_Plate.stl, Existing_Handle_Left.stl, Existing_Handle_Right.stl, Fit_Test_Female.stl, Fit_Test_Male.stl]
2026-10-27 Reverse detachable wand loop to seat upward against load stops
    [Battery_Sled.stl, Battery_Twist_Cap.stl, Button_Mount_Coupon.stl, Choc_Top_Slide_Plate.stl, Existing_Handle_Left.stl, Existing_Handle_Right.stl, Fit_Test_Female.stl, Fit_Test_Male.stl]
2026-10-27 Implement lift-and-left-turn cam lock for both wand handles
    [Battery_Sled.stl, Battery_Twist_Cap.stl, Button_Mount_Coupon.stl, Choc_Top_Slide_Plate.stl, Existing_Handle_Left.stl, Existing_Handle_Right.stl, Fit_Test_Female.stl, Fit_Test_Male.stl]
2026-10-27 Recess detachable wand handle mounts into the original stem surface
    [Battery_Sled.stl, Battery_Twist_Cap.stl, Button_Mount_Coupon.stl, Choc_Top_Slide_Plate.stl, Existing_Handle_Left.stl, Existing_Handle_Right.stl, Fit_Test_Female.stl, Fit_Test_Male.stl]
2026-10-27 Recess switch mounts and print thin plates flat
    [Battery_Sled.stl, Battery_Twist_Cap.stl, Button_Mount_Coupon.stl, Choc_Recessed_Plate.stl, Existing_Handle_Left.stl, Existing_Handle_Right.stl, Fit_Test_Female.stl, Fit_Test_Male.stl]
2026-10-27 Blend the lower handle attachment into its curved return
    [Battery_Sled.stl, Battery_Twist_Cap.stl, Button_Mount_Coupon.stl, Choc_Recessed_Plate.stl, Existing_Handle_Left.stl, Existing_Handle_Right.stl, Fit_Test_Female.stl, Fit_Test_Male.stl]
2026-10-27 Seat both removable handle arms directly and slim the wand grip
    [Battery_Sled.stl, Battery_Twist_Cap.stl, Button_Mount_Coupon.stl, Choc_Recessed_Plate.stl, Existing_Handle_Left.stl, Existing_Handle_Right.stl, Fit_Test_Female.stl, Fit_Test_Male.stl]
2026-10-27 Redesign the Magic Wand site around the three-button experience
2026-10-27 Add four lightweight wand lattice studies and checked print projects
    [Handle_Left.stl, Handle_Right.stl, Lower_Shaft.stl, Print-Lattice-diamond-complete.3mf, Print-Lattice-diamond-one-left.3mf, Print-Lattice-helix-complete.3mf, Print-Lattice-helix-one-left.3mf, Print-Lattice-leaf-complete.3mf]
2026-10-27 Add reinforced tapered lattices and an open sensor cradle
    [Handle_Left.stl, Handle_Right.stl, Lower_Shaft.stl, Print-Lattice-broad-frame-complete.3mf, Print-Lattice-broad-frame-one-left.3mf, Print-Lattice-one-wide-complete.3mf, Print-Lattice-one-wide-one-left.3mf, Print-Lattice-two-wide-complete.3mf]
2026-10-27 Restore butt-mounted controls and use a slim solid handle band
    [Battery_Sled.stl, Battery_Twist_Cap.stl, Button_Mount_Coupon.stl, Choc_Recessed_Plate.stl, Existing_Handle_Left.stl, Existing_Handle_Right.stl, Fit_Test_Female.stl, Fit_Test_Male.stl]
2026-10-27 Add continuous two-spiral wand design
    [Continuous_Shaft.stl, Print-Continuous-Two-Wide-complete.3mf, Print-Continuous-Two-Wide-one-left.3mf, Sense_Open_Cradle.stl]
2026-10-27 Smooth and widen the V20 removable wand handle
    [Battery_Sled.stl, Battery_Twist_Cap.stl, Button_Mount_Coupon.stl, Choc_Recessed_Plate.stl, Existing_Handle_Left.stl, Existing_Handle_Right.stl, Fit_Test_Female.stl, Fit_Test_Male.stl]
2026-10-27 Adapt tapered continuous shaft to V19 grip
    [Continuous_Shaft.stl, Print-Continuous-Two-Wide-V19-complete.3mf, Print-Continuous-Two-Wide-V19-one-left.3mf, Sense_Open_Cradle.stl]
2026-10-27 Add sharper tapered wand tube with tip sensor
    [Continuous_Shaft.stl, Print-Shard-Tube-complete.3mf, Print-Shard-Tube-one-left.3mf, Sense_Open_Cradle.stl]
2026-10-27 Show assembled wand length in model viewer
2026-10-28 Repair Shard Tube handle, switch seats and battery loading
    Add integral Choc seats, an indexed detachable loop and continuous bottom-loading access with interchangeable light and weighted screw caps. Preserve the Shard upper assembly and both handed grips, and include editable CAD, prepared PETG projects, exported-mesh checks and sliced-path receipts.
    [Battery_Screw_Cap_Light.stl, Battery_Screw_Cap_Weighted.stl, Battery_Sled.stl, Continuous_Shaft.stl, Grip_Left.stl, Grip_Right.stl, Loop_Keeper_Key.stl, Loop_Upper_Hook_Test.stl]
2026-10-28 Add slimmer detachable loop studies
    [Removable_Finger_Loop.stl, Slim-Loop-leaf-complete-both-hands.3mf, Slim-Loop-leaf-one-left-light.3mf, Slim-Loop-petal-complete-both-hands.3mf, Slim-Loop-petal-one-left-light.3mf, Slim-Loop-slim-complete-both-hands.3mf, Slim-Loop-slim-one-left-light.3mf]
2026-10-28 Record CAD viewer and print-path lessons
2026-10-29 Correct Sense grip finger mapping while preserving wire channels
2026-10-29 Add thin 500 mm solid wand with integral gyro mount
    [Long-Solid-Wand-500mm-8mm.3mf, Lower_Rod.stl, Middle_Rod.stl, Upper_Rod_Integral_Gyro_Mount.stl]
2026-10-29 Prepare Sense delivery and tuning update; board validation pending
2026-10-29 Fix wand HUD selection and pointer jitter; add persistent guide
    [bridge.py, test_bridge.py, wand_light.h, wand_sense.ino]
2026-10-29 Restore fine wand aiming and fix physical Bottom tap timing
    [wand-mode-bridge.js]
2026-10-29 Keep Switch App movement direct and reset centred pointer input
2026-10-30 Add lightweight carbon-rod holder prototypes
    [Holder-pair-layout.3mf, Holder-pair-sliced.3mf, Key_Battery_Carrier-assembly.stl, Key_Battery_Carrier.stl, XIAO_Rod_Holder-assembly.stl, XIAO_Rod_Holder.stl]
2026-10-30 Reverse carbon-rod holder USB and clear the wire route
    [Holder-pair-layout.3mf, Holder-pair-sliced.3mf, Key_Battery_Carrier-assembly.stl, Key_Battery_Carrier.stl, XIAO_Rod_Holder-assembly.stl, XIAO_Rod_Holder.stl]
2026-10-30 Fix cursor jump-back and restore clicks after screenshot selection
    Track the receiver’s own posted cursor origin across delivery batches and recover hidden HUD sessions so ordinary stop-to-click works again. Preserve single-shot clicks, native screenshot dragging, held button releases and the explicit centre-held/left-press click.
    Validated locally: all 240 Wand tests, 17 Control Stones checks and the repository privacy scan pass. Receiver 119 is installed; no firmware was flashed in this update.
    [wand-mode-bridge.js, wand-mouse-prototype.js]
2026-10-30 Publish installed Wand HUD controls and remove the rejected click chord
    Update receiver120/native309 guide and version metadata, preserve actual Wand motion axes and stay-open actions, and move the detailed HUD instructions into the project skill to avoid truncation. The replacement double-HUD click remains pending latency approval.
    Validation: 227 Wand tests, 17 Control Stones checks, generation/privacy checks, signed receiver installation and native309 full gate. Physical reconnect acceptance remains pending a wake-button press.
    [wand-mode-bridge.js]
2026-10-30 Use HUD, mouse and speech button names throughout wand controls
2026-10-31 Verify wireless Sense updates and add white connection pulses
2026-10-31 Track installed Agentic Mouse drag restore fix
2026-10-31 Add held-mode brightness feedback and a bounded LED demo
2026-10-31 Drop obsolete Sense motion at the physical button release
2026-10-31 Click promptly after filtered brisk stops and blink blue
2026-10-31 Expire temporary sensor captures and retain bounded diagnostics
2026-10-31 Acknowledge dark-state wand button presses locally
2026-10-31 Bound wireless update packets and reject late callbacks
2026-10-31 Harden Sense update recovery and discard stale HUD pointer frames
2026-10-31 Record verified wireless firmware 11 installation
2026-10-31 Keep wand input current and capture post-install diagnostics
    Leave follow off after completed scrolling, prevent synthetic old-reading replay in every live mode, and apply stale-frame protection to native and screenshot drags. Preserve current-pointer clicks, existing gain and click timing, and record the user decisions beside their owners.
    Start a bounded ten-minute diagnostic window once per installed receiver or verified firmware version. Preserve manual-off choices, ordinary restarts, and temporary-data retention.
2026-10-31 Keep the wand reachable during active update work
    Add an expiring private work lease that inhibits automatic deep standby while preserving dark idle, manual shutdown and pointer behavior. Reuse the receiver request watcher and heartbeat, retain the lease across receiver swaps, and restore normal standby when work ends.
    Document the agent workflow and distinguish updating the Mac receiver from waking or flashing a sleeping device.
2026-10-31 Restore separate pointer moves and clarify fine sensor readings
2026-10-31 Use physical HUD tap timing and show valid fine sensor readings
2026-11-01 Restore ordinary page wheel scrolling and compact navigation feedback
2026-11-01 Preserve Sense motion continuity across host delivery stalls
2026-11-01 Preserve recording follow and chain fast stop clicks
2026-11-01 Add five-key carbon rod carrier and interactive holder preview
    [Holder-pair-layout.3mf, Holder-pair-sliced.3mf, Key_Battery_Carrier-assembly.stl, Key_Battery_Carrier.stl, XIAO_Rod_Holder-assembly.stl, XIAO_Rod_Holder.stl]
2026-11-01 Add close sliding five-key carbon-tube holders
    [Carrier_front-assembly.stl, Carrier_front.stl, Carrier_lower-assembly.stl, Carrier_lower.stl, Carrier_rear-assembly.stl, Carrier_rear.stl, Centre-key-with-rings.stl, Holder-front-layout.3mf]
2026-11-02 Add Control Stones V2 compact handheld and ring concepts
    [Band_Pod.stl, Battery_Envelope.stl, Board_Envelope.stl, Far_Side_Cap.stl, Far_Side_Switch_Assumed.stl, Handheld_Left_3Button_CONCEPT.3mf, Handheld_Left_4Button_CONCEPT.3mf, Handheld_Right_3Button_CONCEPT.3mf]
2026-11-02 Record the wand assembly blueprint and reproducible mass model
2026-11-02 Tighten holder key spacing and add continuous 3D controls
    [Carrier_front-assembly.stl, Carrier_front.stl, Carrier_lower-assembly.stl, Carrier_lower.stl, Carrier_rear-assembly.stl, Carrier_rear.stl, Centre-key-with-rings.stl, Holder-front-layout.3mf]
2026-11-02 Add the compact three-key prototype and mechanics study
    [Key_Battery_Carrier-assembly.stl, Key_Battery_Carrier.stl, XIAO_Rod_Holder-assembly.stl, XIAO_Rod_Holder.stl]
2026-11-02 Add open spring clips to carbon-rod holders
    [Carrier-spring-7.9mm.stl, Carrier-spring-8.0mm.stl, Carrier-spring-8.1mm.stl, Carrier_front-assembly.stl, Carrier_front.stl, Carrier_lower-assembly.stl, Carrier_lower.stl, Carrier_rear-assembly.stl]
2026-11-02 Add reversible five-key holder and separate sliding battery module
    [Battery_Holder-assembly.stl, Battery_Holder.stl, Holder-modular-layout.3mf, Holder-modular-sliced.3mf, Key_Carrier-assembly.stl, Key_Carrier.stl, XIAO_Rod_Holder-assembly.stl, XIAO_Rod_Holder.stl]
2026-11-02 Add R9 compact keys and slide-in battery cage
    [Battery-Gate-easier-fit.stl, Battery_End_Gate-assembly.stl, Battery_End_Gate.stl, Battery_Holder-assembly.stl, Battery_Holder.stl, Holder-modular-layout.3mf, Holder-modular-sliced.3mf, Key_Carrier-assembly.stl]
2026-11-02 Add R10 thumb clearance and tip-side battery layout
    [Battery-Gate-easier-fit.stl, Battery_End_Gate-assembly.stl, Battery_End_Gate.stl, Battery_Holder-assembly.stl, Battery_Holder.stl, Holder-modular-layout.3mf, Holder-modular-sliced.3mf, Key_Carrier-assembly.stl]
2026-11-02 Tighten thumb spacing and keep one current model viewer
    [Battery-Gate-easier-fit.stl, Battery_End_Gate-assembly.stl, Battery_End_Gate.stl, Battery_Holder-assembly.stl, Battery_Holder.stl, Holder-modular-layout.3mf, Holder-modular-sliced.3mf, Key_Carrier-assembly.stl]
2026-11-02 Bring side keys slightly closer and refresh open model previews
    [Battery-Gate-easier-fit.stl, Battery_End_Gate-assembly.stl, Battery_End_Gate.stl, Battery_Holder-assembly.stl, Battery_Holder.stl, Holder-modular-layout.3mf, Holder-modular-sliced.3mf, Key_Carrier-assembly.stl]
2026-11-05 Audit holder print paths and reinforce R13 fixed parts
    [AFTER-KEY-TEST-Holder-R13-sliced.3mf, Battery_End_Gate-SOURCE-REQUIRES-PREPARATION.stl, Battery_End_Gate-assembly.stl, Battery_Holder-PRINT-HELPER-assembly.stl, Battery_Holder-SOURCE-REQUIRES-PREPARATION.stl, Battery_Holder-assembly.stl, Holder-R13-layout.3mf, Key_Carrier-PRINT-HELPER-assembly.stl]
2026-11-06 Build compact R14 pyramid key holder and audit print trials
    [AFTER-KEY-TEST-Pyramid-Holder-R14.3mf, Battery_End_Gate-SOURCE-REQUIRES-PREPARATION.stl, Battery_End_Gate-assembly.stl, Battery_Holder-PRINT-HELPER-assembly.stl, Battery_Holder-SOURCE-REQUIRES-PREPARATION.stl, Battery_Holder-assembly.stl, Holder-R14-layout.3mf, Key_Carrier-PRINT-HELPER-assembly.stl]
2026-11-06 Enable wand follow on mouse-button release
2026-11-06 Build audited R15 carrier and reduce geometry allocations
    [AFTER-KEY-TEST-Pyramid-Holder-R15.3mf, Battery_End_Gate-SOURCE-REQUIRES-PREPARATION.stl, Battery_End_Gate-assembly.stl, Battery_Holder-PRINT-HELPER-assembly.stl, Battery_Holder-SOURCE-REQUIRES-PREPARATION.stl, Battery_Holder-assembly.stl, Holder-R15-layout.3mf, Key_Carrier-PRINT-HELPER-assembly.stl]
2026-11-08 Repair and audit R16 slide-on holder prototypes
    [Battery_End_Gate-SOURCE-REQUIRES-PREPARATION.stl, Battery_End_Gate-assembly.stl, Battery_Holder-SOURCE-REQUIRES-PREPARATION.stl, Battery_Holder-assembly.stl, Key_Carrier-SOURCE-REQUIRES-PREPARATION.stl, Key_Carrier-assembly.stl, R16-A1-mini-PETG-layout.3mf, R16-A1-mini-PETG.gcode.3mf]
2026-11-08 Focus 3D print reviews on changed risks
2026-11-08 Repair battery and XIAO holders with fused bed anchors
    [Battery_End_Gate-ANCHOR-REMOVE-AFTER-PRINT.stl, Battery_End_Gate-SOURCE-REQUIRES-PREPARATION.stl, Battery_End_Gate-assembly.stl, Battery_Holder-ANCHOR-REMOVE-AFTER-PRINT.stl, Battery_Holder-SOURCE-REQUIRES-PREPARATION.stl, Battery_Holder-assembly.stl, R17-A1-mini-PETG-layout.3mf, R17-A1-mini-PETG.gcode.3mf]
2026-11-08 Align repair notes with final battery mass
2026-11-08 Record holder cleanup failure and replaceable battery priorities
2026-11-08 Repair R18 holders for easier release and replaceable battery fit
    [Battery_End_Door-SOURCE-REQUIRES-PREPARATION.stl, Battery_End_Door-assembly.stl, Battery_Holder-ANCHOR-REMOVE-AFTER-PRINT.stl, Battery_Holder-SOURCE-REQUIRES-PREPARATION.stl, Battery_Holder-assembly.stl, Battery_Spacer_0p4mm-SOURCE-REQUIRES-PREPARATION.stl, Battery_Spacer_0p4mm-assembly.stl, Battery_Spacer_0p6mm-SOURCE-REQUIRES-PREPARATION.stl]
2026-11-09 Lighten R19 holders with open backs and checked printable roots
    [Battery_End_Door-SOURCE-REQUIRES-PREPARATION.stl, Battery_End_Door-assembly.stl, Battery_Holder-ANCHOR-REMOVE-AFTER-PRINT.stl, Battery_Holder-SOURCE-REQUIRES-PREPARATION.stl, Battery_Holder-assembly.stl, Battery_Spacer_0p4mm-SOURCE-REQUIRES-PREPARATION.stl, Battery_Spacer_0p4mm-assembly.stl, Battery_Spacer_0p6mm-SOURCE-REQUIRES-PREPARATION.stl]
2026-11-09 Resolve A1 mini command templates before printing R19
    [R19-A1-mini-PETG-layout.3mf, R19-A1-mini-PETG.gcode.3mf]
2026-11-09 Record R19 print feedback and explain holder assembly
2026-11-09 Add shared Three.js assembly playback and R19 guide
2026-11-09 Route CAD author preferences through the design skill
2026-11-10 Prepare R20 finger guard and revised wand holders
    [Battery_Holder-ANCHOR-REMOVE-AFTER-PRINT.stl, Battery_Holder-SOURCE-REQUIRES-PREPARATION.stl, Battery_Holder-assembly.stl, Finger_Guard-ANCHOR-REMOVE-AFTER-PRINT.stl, Finger_Guard-SOURCE-REQUIRES-PREPARATION.stl, Finger_Guard-assembly.stl, Key_Carrier-ANCHOR-REMOVE-AFTER-PRINT.stl, Key_Carrier-SOURCE-REQUIRES-PREPARATION.stl]
2026-11-10 Add a lightweight split cable clip and checked PETG trial
    [Cable_Clip_4mm-ANCHOR-REMOVE-AFTER-PRINT.stl, Cable_Clip_4mm-SOURCE-REQUIRES-PREPARATION.stl, Cable_Clip_4mm-assembly.stl, R21-A1-mini-PETG-layout.3mf, R21-A1-mini-PETG.gcode.3mf]
2026-11-10 Show wand component assemblies in one viewer
2026-11-10 Prepare checked R22 wand holders and matching keepers
    [Battery_End_Door-SOURCE-REQUIRES-PREPARATION.stl, Battery_End_Door-assembly.stl, Battery_End_Door_Easy_Trial-SOURCE-REQUIRES-PREPARATION.stl, Battery_End_Door_Easy_Trial-assembly.stl, Battery_Holder-ANCHOR-REMOVE-AFTER-PRINT.stl, Battery_Holder-SOURCE-REQUIRES-PREPARATION.stl, Battery_Holder-assembly.stl, Battery_Spacer_0p4mm-SOURCE-REQUIRES-PREPARATION.stl]
2026-11-10 Skip optional battery spacers on routine holder plates
2026-11-10 Document the OP1 centre switch wiring
2026-11-10 Record Wand print evidence as trials progress
2026-11-10 Prepare R23 centre click and reinforced guard fit trial
    [Centre_Paddle-SOURCE-REQUIRES-PREPARATION.stl, Centre_Paddle-assembly.stl, Centre_Paddle_Deep_Trial-SOURCE-REQUIRES-PREPARATION.stl, Centre_Paddle_Deep_Trial-assembly.stl, Centre_Paddle_Shallow_Trial-SOURCE-REQUIRES-PREPARATION.stl, Centre_Paddle_Shallow_Trial-assembly.stl, Key_Carrier-SOURCE-REQUIRES-PREPARATION.stl, Key_Carrier-assembly.stl]
2026-11-10 Use legible viewer-type icons for 3D and sensor pages
2026-11-10 Animate the R22 keeper and prepare the R24 patterned spacer trial
    [Battery_Spacer_0p4mm_Patterned-SOURCE-REQUIRES-PREPARATION.stl, Battery_Spacer_0p4mm_Patterned-assembly.stl, R24-A1-mini-PETG-layout.3mf, R24-A1-mini-PETG.gcode.3mf, battery_negative_lead.stl, battery_positive_lead.stl, latch_cut_holder_centre.stl, latch_cut_keeper_centre-tongue-lifted.stl]
2026-11-10 Add the R25 lift-release XIAO keeper trial
    [R25-XIAO-Catch-A1-mini-PETG-layout.3mf, R25-XIAO-Catch-A1-mini-PETG.gcode.3mf, XIAO_Near_Keeper-SOURCE-REQUIRES-PREPARATION.stl, XIAO_Near_Keeper-assembly.stl, XIAO_Rod_Holder-ANCHOR-REMOVE-AFTER-PRINT.stl, XIAO_Rod_Holder-SOURCE-REQUIRES-PREPARATION.stl, XIAO_Rod_Holder-assembly.stl, holder25_section.stl]
2026-11-10 Group the R25 keys in the assembly viewer
2026-11-10 Add per-model visibility actions to the assembly viewer
2026-11-10 Show how each centre cap assembles and stays attached
2026-11-11 Animate the snap-in centre cap hinge
2026-11-11 Bring the upper keys closer with outward hinge pins
2026-11-11 Prepare the DFRobot centre click fit trial
    [DFRobot_Front_Keeper-SOURCE-REQUIRES-PREPARATION.stl, DFRobot_Front_Keeper-assembly.stl, DFRobot_Paddle-SOURCE-REQUIRES-PREPARATION.stl, DFRobot_Paddle-assembly.stl, Key_Carrier-ANCHOR-REMOVE-AFTER-PRINT.stl, Key_Carrier-SOURCE-REQUIRES-PREPARATION.stl, Key_Carrier-assembly.stl, R26-DFRobot-A1-mini-PETG-layout.3mf]
2026-11-11 Mechanically retain the OP1 board in R26
    [Key_Carrier-SOURCE-REQUIRES-PREPARATION.stl, Key_Carrier-assembly.stl, OP1_Board_Latch-SOURCE-REQUIRES-PREPARATION.stl, OP1_Board_Latch-assembly.stl, R26-DFRobot-A1-mini-PETG-layout.3mf, R26-DFRobot-A1-mini-PETG.gcode.3mf, R26-DFRobot-OP1-Latch-A1-mini-PETG-layout.3mf, R26-DFRobot-OP1-Latch-A1-mini-PETG.gcode.3mf]
2026-11-11 Preview the removable copper insert on the R26 hinge
    [copper26-cap.stl, copper26-foil.stl, copper26-insert.stl, copper26-terminal.stl]
2026-11-11 Preview the compact copper key layout and add viewer roll
    [Compact_Key_Carrier.stl, OP1_Keeper_Pin.stl, OP1_Lead.stl, OP1_Rear_Keeper.stl, carrier-squeezed.stl]
2026-11-11 Align the centre copper key with the bottom row
    [Aligned_Copper_Cap.stl]
2026-11-11 Reorient the DFRobot touch board in R28
    [DFRobot_Touch_Tray-SOURCE-REQUIRES-PREPARATION.stl, DFRobot_Touch_Tray-assembly.stl, Key_Carrier-SOURCE-REQUIRES-PREPARATION.stl, Key_Carrier-assembly.stl, OP1_Rear_Keeper-SOURCE-REQUIRES-PREPARATION.stl, OP1_Rear_Keeper-assembly.stl, board-keeper-pin.stl, carrier-squeezed.stl]
2026-11-11 Fit the DFRobot tray with integral snap arms
    [DFRobot_Touch_Tray-SOURCE-REQUIRES-PREPARATION.stl, DFRobot_Touch_Tray-assembly.stl, Key_Carrier-SOURCE-REQUIRES-PREPARATION.stl, Key_Carrier-assembly.stl, OP1_Rear_Keeper-SOURCE-REQUIRES-PREPARATION.stl, OP1_Rear_Keeper-assembly.stl, hinge-detail-key-holder.stl, hinge-detail-tray-pinched.stl]
2026-11-11 Finish the DFRobot hole mount and assembly controls
    [DFR0030_Post_Clip-SOURCE-REQUIRES-PREPARATION.stl, DFR0030_Post_Clip-assembly.stl, DFR0030_Post_Clip_2-SOURCE-REQUIRES-PREPARATION.stl, DFR0030_Post_Clip_2-assembly.stl, DFRobot_Hole_Bracket-ANCHOR-REMOVE-AFTER-PRINT.stl, DFRobot_Hole_Bracket-SOURCE-REQUIRES-PREPARATION.stl, DFRobot_Hole_Bracket-assembly.stl, Key_Carrier-ANCHOR-REMOVE-AFTER-PRINT.stl]
2026-11-11 Move the touch-board hinge to the key holder rear edge
    [DFR0030_Post_Clip-SOURCE-REQUIRES-PREPARATION.stl, DFR0030_Post_Clip-assembly.stl, DFR0030_Post_Clip_2-SOURCE-REQUIRES-PREPARATION.stl, DFR0030_Post_Clip_2-assembly.stl, DFRobot_Hole_Bracket-ANCHOR-REMOVE-AFTER-PRINT.stl, DFRobot_Hole_Bracket-SOURCE-REQUIRES-PREPARATION.stl, DFRobot_Hole_Bracket-assembly.stl, Key_Carrier-ANCHOR-REMOVE-AFTER-PRINT.stl]
2026-11-11 Prepare the complete R32 Magic Wand first-fit plate
    [DFR0030_Post_Clip-SOURCE-REQUIRES-PREPARATION.stl, DFR0030_Post_Clip-assembly.stl, DFR0030_Post_Clip_2-SOURCE-REQUIRES-PREPARATION.stl, DFR0030_Post_Clip_2-assembly.stl, DFRobot_Hole_Bracket-SOURCE-REQUIRES-PREPARATION.stl, DFRobot_Hole_Bracket-assembly.stl, Key_Carrier-SOURCE-REQUIRES-PREPARATION.stl, Key_Carrier-assembly.stl]
2026-11-11 Start wand assembly animations at the first step
2026-11-11 Add R33 crosswise wand guards and checked print plate
    [DFR0030_Post_Clip-SOURCE-REQUIRES-PREPARATION.stl, DFR0030_Post_Clip-assembly.stl, DFR0030_Post_Clip_2-SOURCE-REQUIRES-PREPARATION.stl, DFR0030_Post_Clip_2-assembly.stl, DFRobot_Hole_Bracket-SOURCE-REQUIRES-PREPARATION.stl, DFRobot_Hole_Bracket-assembly.stl, Key_Carrier-SOURCE-REQUIRES-PREPARATION.stl, Key_Carrier-assembly.stl]
2026-11-11 Prepare R34 straight OP1 assembly and first-fit plate
    [Battery_Spacer_0p4mm_Patterned-SOURCE-REQUIRES-PREPARATION.stl, Battery_Spacer_0p4mm_Patterned-assembly.stl, DFR0030_Post_Clip-SOURCE-REQUIRES-PREPARATION.stl, DFR0030_Post_Clip-assembly.stl, DFR0030_Post_Clip_2-SOURCE-REQUIRES-PREPARATION.stl, DFR0030_Post_Clip_2-assembly.stl, DFRobot_Hole_Bracket-SOURCE-REQUIRES-PREPARATION.stl, DFRobot_Hole_Bracket-assembly.stl]
2026-11-11 Check finished print candidates before committing
2026-11-11 Tie slicing checks to each print iteration
2026-11-12 Prepare R34 retry with modest removable pad area increase
    [DFRobot_Hole_Bracket-ANCHOR-REMOVE-AFTER-PRINT.stl, R34-Pad-Retry-A1-mini-PETG-layout.3mf, R34-Pad-Retry-A1-mini-PETG.gcode.3mf, R34-Pad-Retry-print-only.3mf]
2026-11-12 Record Fable review and measured early bracket contact
2026-11-12 Document Flashforge Metallic Red print temperatures
2026-11-12 Save verified R34 perforated-pad print test
    [R34-Perforated-Pad-Test-editable.3mf, R34-Perforated-Pad-Test-print-only.3mf]
2026-11-12 Reinforce R35 wand print roots and support OP1 ledge
    [Battery_Spacer_0p4mm_Patterned-SOURCE-REQUIRES-PREPARATION.stl, Battery_Spacer_0p4mm_Patterned-assembly.stl, DFR0030_Post_Clip-SOURCE-REQUIRES-PREPARATION.stl, DFR0030_Post_Clip-assembly.stl, DFR0030_Post_Clip_2-SOURCE-REQUIRES-PREPARATION.stl, DFR0030_Post_Clip_2-assembly.stl, DFRobot_Hole_Bracket-SOURCE-REQUIRES-PREPARATION.stl, DFRobot_Hole_Bracket-assembly.stl]
2026-11-12 Prepare R36 Seeed Grove touch Wand assembly
    [Battery_Spacer_0p4mm_Patterned-SOURCE-REQUIRES-PREPARATION.stl, Battery_Spacer_0p4mm_Patterned-assembly.stl, Grove_Touch_Bracket-SOURCE-REQUIRES-PREPARATION.stl, Grove_Touch_Bracket-assembly.stl, Key_Carrier-SOURCE-REQUIRES-PREPARATION.stl, Key_Carrier-assembly.stl, R36-Complete-A1-mini-PETG-layout.3mf, R36-Grove-print-only.3mf]
2026-11-12 Make the Grove Wand OP1 stop adjustable
    [Grove_Touch_Bracket-SOURCE-REQUIRES-PREPARATION.stl, Grove_Touch_Bracket-assembly.stl, Key_Carrier-SOURCE-REQUIRES-PREPARATION.stl, Key_Carrier-assembly.stl, R37-Adjustable-OP1-print-only.3mf, R37-Complete-A1-mini-PETG-layout.3mf, connector.stl, electrode.stl]
2026-11-12 Bind the R37 print download to its slice audit
2026-11-13 Prepare solid adhesion pads and gentler R37 bed motion
    [R37-Solid-Pads-A1-mini-PETG-layout.3mf, R37-Solid-Pads-A1-mini-PETG-print-only.3mf]
2026-11-13 Prepare gentler R37 adhesion retry after early-layer failure
    [R37-Gentle-Start-A1-mini-PETG-layout.3mf, R37-Gentle-Start-A1-mini-PETG-print-only.3mf]
2026-11-13 Prepare R37 standard-motion PETG retry with gentle base layers
    [R37-Standard-PETG-retry-layout.3mf, R37-Standard-PETG-retry-print-only.3mf, R37-Standard-PETG-retry.gcode.3mf]
2026-11-14 Prepare checked R38 centred OP1 fit trial and assembly
    [Battery_End_Door-SOURCE-REQUIRES-PREPARATION.stl, Battery_Holder-ANCHOR-REMOVE-AFTER-PRINT.stl, Battery_Holder-SOURCE-REQUIRES-PREPARATION.stl, Cable_Clip_12_Wire-ANCHOR-REMOVE-AFTER-PRINT.stl, Cable_Clip_12_Wire-SOURCE-REQUIRES-PREPARATION.stl, Grove_Touch_Bracket-ANCHOR-REMOVE-AFTER-PRINT.stl, Grove_Touch_Bracket-SOURCE-REQUIRES-PREPARATION.stl, Grove_Touch_Bracket-assembly.stl]
