EthanSK/magic-wand/(notices)

Notices in the files:
magic-wand/SOURCES.md:
Big Shoulders Display | SIL OFL 1.1 | © 2019 The Big Shoulders Project Authors
Atkinson Hyperlegible Next | SIL OFL 1.1 | © 2020–2024 The Atkinson Hyperlegible Next Project Authors
Atkinson Hyperlegible Mono | SIL OFL 1.1 | © 2020–2024 The Atkinson Hyperlegible Mono Project Authors
